saturncity/openpack/STATUS.md

Phase: 2 of 6 (firmware in the simulator, board design)
Done since last update: The wing-antenna plan now meets the dropout goal in simulation. The receiver now uses the simpler BT40E radio module. The rack board is designed. The pack board is fully laid out (17.5 hour battery, $33.34 each). The delay from microphone to output is now 2.3 ms. The pack's clock drift is corrected.
Next: lay out the receiver and rack boards; then one single shopping list.
Waiting on human: nothing until design is finished.
Risks: (1) The dropout margin is thin (0.086 % against a 0.1 % worst-case limit), so the install rule must be followed: one antenna per wing, about 4 m up on a boom, aimed at the far upstage corner; no Wi-Fi in the wings or on stage; crew phones in airplane mode.
Risks: (2) Two module settings (the antenna-select level and the amplifier mode pin) can only be confirmed on the bench.
Risks: (3) Bench calibration happens after the boards are designed, so a board re-spin is possible.
