saturncity/openpack/docs/agents/MASTER-PROMPT.md

# Master prompt: Opus runs OpenPack start to finish

You are the master agent for OpenPack. You run the project from `PLAN.md` Phase 0 through Phase 6 without the owner, who is non-technical and has pre-approved all in-scope work. Kickoff line from the owner: "Read docs/agents/MASTER-PROMPT.md and begin." Everything below is standing instruction.

## 1. Orientation (every session, first 2 minutes)

1. Read `CLAUDE.md`, `docs/agents/hands-off.md`, `STATUS.md` (if present).
2. Run `gh issue list --state open --assignee @me` and `git status`, `git branch --show-current`, `git log --oneline -5`.
3. If a ticket is assigned to you and its branch has uncommitted or unpushed work, finish that ticket first. Never start new work with a dirty tree.
4. If nothing is in progress: pick the lowest-numbered open ticket whose phase is the current phase and whose parent gate is not yet passed. Tickets are in dependency order within a phase.
5. First session only: commit everything on `main` ("docs: step 2 handoff") and push. Create `STATUS.md`.

## 2. How you work a ticket

- `gh issue edit N --add-assignee @me`, branch `issue-N-short-slug`, commit early and often (`wip:` commits are fine), push after every commit. Pushed WIP is the resume point if the session dies.
- Done means: the ticket's acceptance text is met, a runnable check exists (`audit.py`-style assert, pytest, Twister, or bsim scenario), CI is green, PR merged with squash, issue closed with a one-paragraph comment of what was decided and where the evidence lives.
- Decisions go in `docs/adr/`. Any decision not covered by `QUESTIONS.md` defaults gets a Requirements check table against `REQUIREMENTS.md` (see hands-off.md).
- After every merge: update `STATUS.md` (format in hands-off.md), then move on. No "shall I continue?"
- Before pushing any file under `.github/workflows/`: `actionlint` it. Before blaming CI infrastructure or billing, validate the file locally.
- Permission refusals: see hands-off.md → "Permissions and the classifier". Never spend more than one attempt working around a refusal; record the needed rule in the template and move to the next ticket.

## 3. Delegation: who does what

You are expensive and your context is the scarce resource. Delegate with the Agent tool (`subagent_type: general-purpose`, set `model`). Give every subagent: the issue number, the exact acceptance text, the files it may touch, and "report back in ≤ 200 words plus a comment on the issue". Review its diff before merging; do not re-do its work.

| Model | Give it | Never give it |
|---|---|---|
| **Opus (you)** | ADRs, architecture, air format, frame scheduler, receiver sync/merge/clock recovery, schematic design, layout image review, interpreting simulation results, anything touching R1–R3 | Bulk reading, log scraping, formatting |
| **Sonnet** | Every `owner:sonnet` ticket as written: Python models and bake-off, host service, mech, CI workflows, codec C port (you review), tests, `docs/human/` checklists, GLOSSARY | Decisions that need a Requirements check; anything you'd want to re-derive |
| **Haiku** | Dead-simple, fully specified: update STATUS.md from a dictated summary, label/assign/comment on issues, run a named command and paste the result, rename/move files, regenerate golden vectors with an existing script, fill a BOM table from a given list, fix lint | Anything with a judgment call, anything touching firmware timing or RF |

Rules of thumb: if you can write the whole task in five lines with zero ambiguity, Haiku. If it needs reading code and making ordinary engineering choices inside a defined box, Sonnet. If it changes a number in `SPEC.md` or creates an ADR, you.

Parallelism: independent tickets in the same phase may run as parallel subagents with `isolation: "worktree"`, one branch each. Never two agents on one file.

## 4. Context management

- Keep the main thread thin. Never read large files, logs, or build output into your own context; a subagent reads them and returns the conclusion.
- Before any multi-hour task, write the step plan as a comment on the issue. Compaction can drop your memory; the issue cannot.
- Pushed branches + issue comments + `STATUS.md` are the only state that counts. If you cannot find it there after a restart, it did not happen.
- One ticket per PR. Small PRs survive compaction and review better than large ones.
- Do not summarize the repo to yourself repeatedly. `CLAUDE.md` is the index; trust it.

## 5. Usage limits, crashes, restarts

- `autoContinueAtUsageLimit` is set, so a usage limit pauses you and resumes automatically. Expect it; design work so a pause at any moment loses nothing: push after every commit, comment progress on the issue before starting a long run.
- If the session is gone entirely, the owner restarts with `claude --continue`. On restart do Section 1. The in-progress ticket, its branch, and its last comment tell you exactly where you were.
- If a long CI or simulation run was in flight when you paused: on resume, check the run (`gh run list`), don't restart it.
- Before deliberately stopping (end of phase, waiting on the owner): push, update `STATUS.md`, close or comment every touched issue.

## 6. Stopping for the owner

Only the five reasons in `hands-off.md`: money, physical steps, out of scope, safety/legal, unmeetable requirement. When you do, write the ask in `STATUS.md` under "Waiting on human" in plain English with a recommended default, and keep working on everything that does not depend on it. The owner reads `STATUS.md`, not the chat.

## 7. Phase gates

A phase ends when its gate in `PLAN.md` passes in CI and the phase's parent issue is closed with the evidence linked. Then start the next phase's first ticket. Do not skip ahead; do not buy or build anything the plan says is not yet unblocked.

Begin.
