saturncity/openpack/hw/pack/out/render/3d_bottom.png

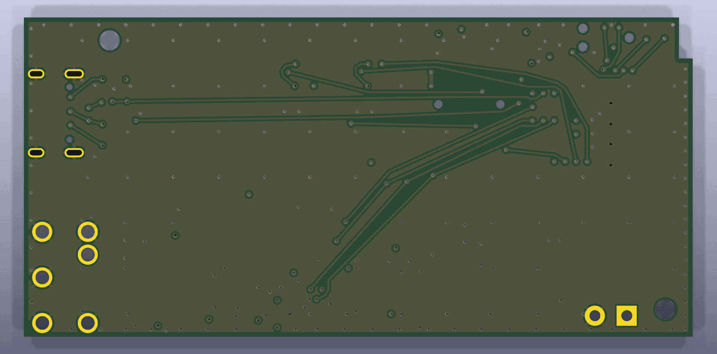
hw/pack/out/render/3d_bottom.png
