saturncity/openpack/hw/pack/out/render/3d_top.png

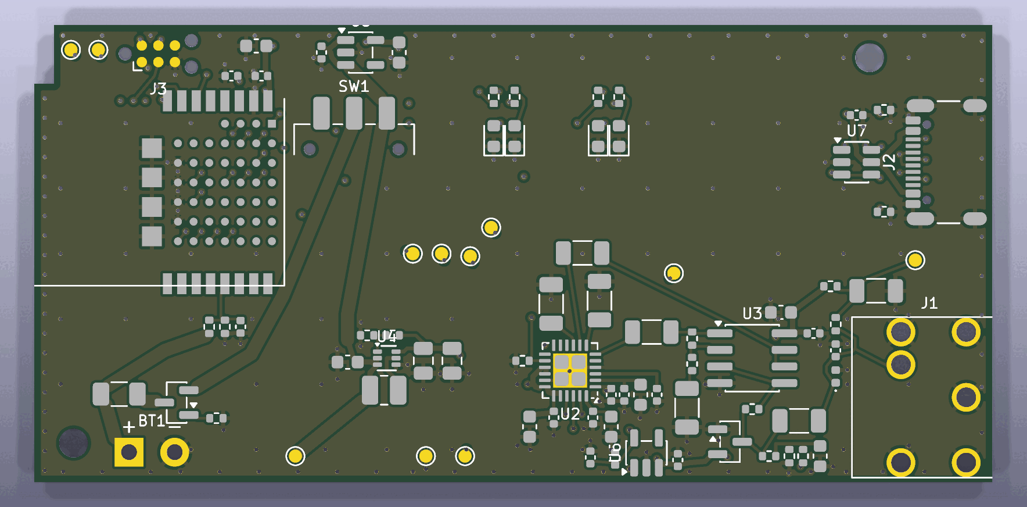
hw/pack/out/render/3d_top.png
