saturncity/openpack/hw/rack/out/render/3d_top.png

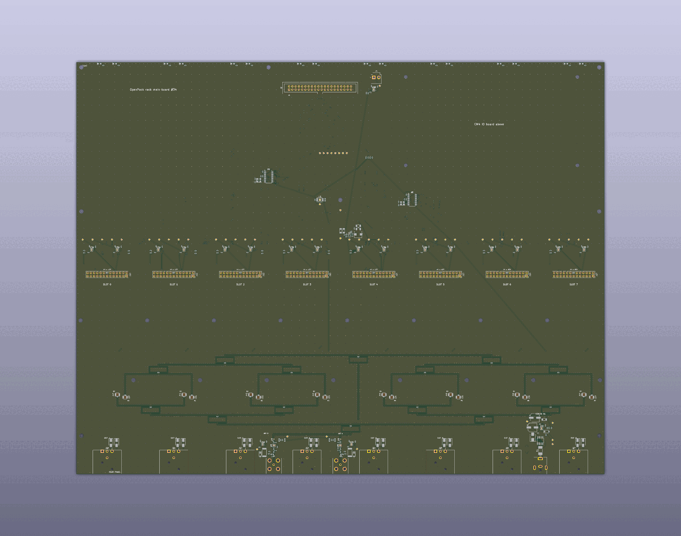
hw/rack/out/render/3d_top.png
