saturncity/openpack/hw/rack/out/render/B.Silkscreen.png

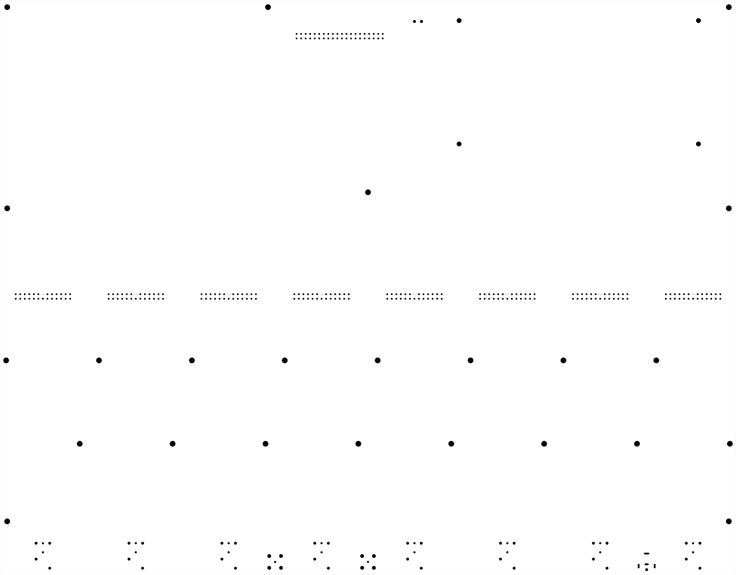
hw/rack/out/render/B.Silkscreen.png
