saturncity/openpack/hw/rack/out/render/crop_power_entry.png

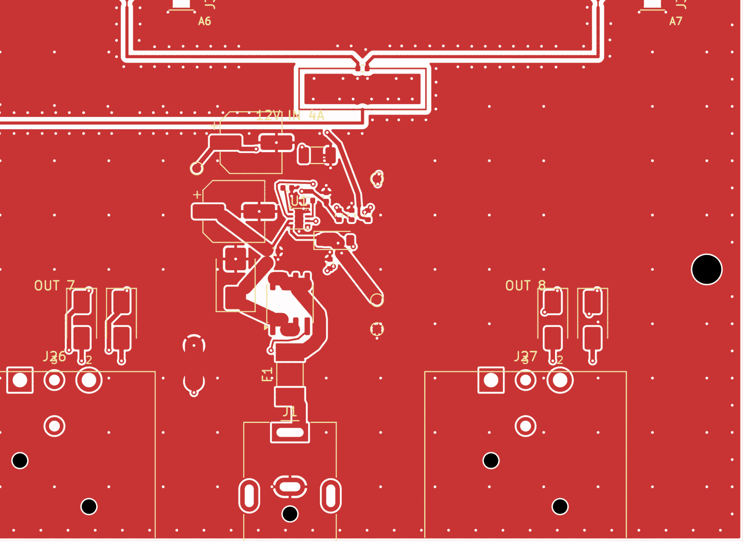
hw/rack/out/render/crop_power_entry.png
