saturncity/openpack/hw/rack/out/render/crop_rf_center.png

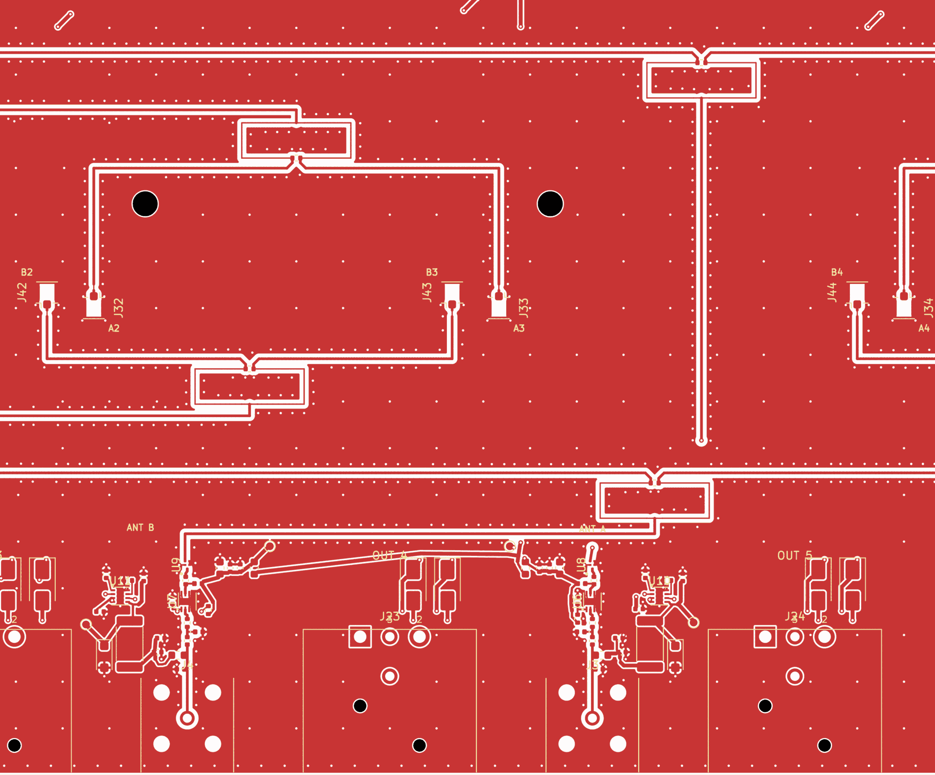
hw/rack/out/render/crop_rf_center.png
