saturncity/openpack/hw/rack/out/render/F.Mask.png

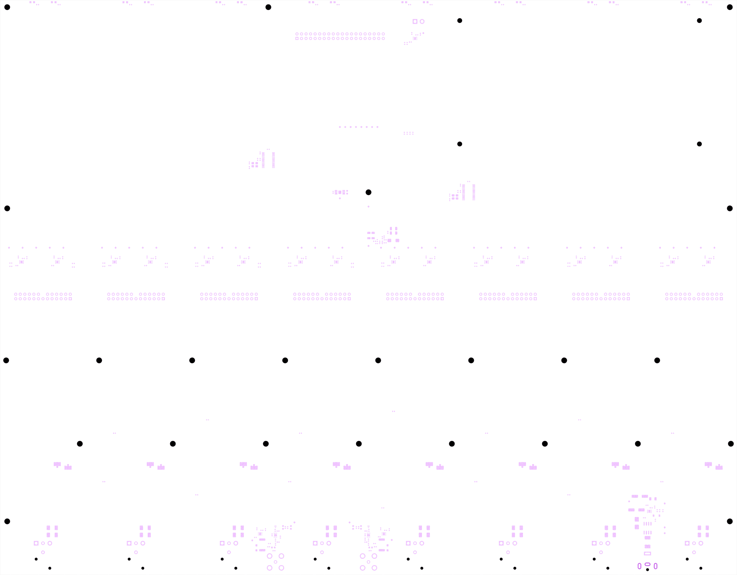
hw/rack/out/render/F.Mask.png
