saturncity/openpack/hw/rx/out/render/3d_bottom.png

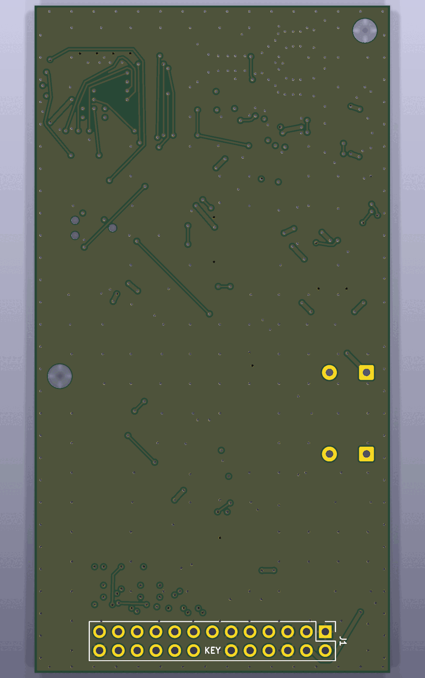
hw/rx/out/render/3d_bottom.png
