saturncity/openpack/hw/rx/out/render/B.Mask.png

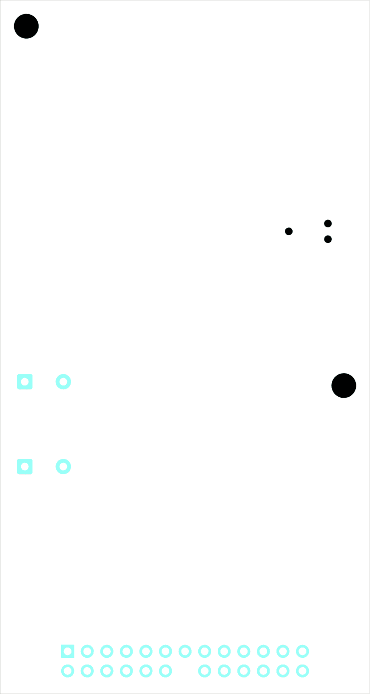
hw/rx/out/render/B.Mask.png
