saturncity/openpack/hw/rx/out/render/B.Paste.png

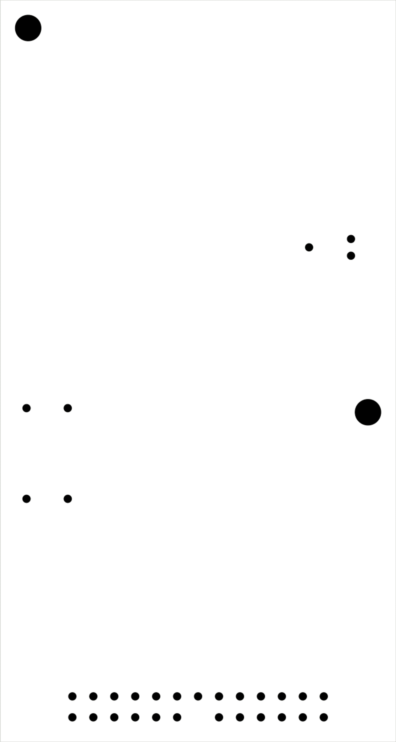
hw/rx/out/render/B.Paste.png
