saturncity/openpack/hw/rx/out/render/F.Silkscreen.png

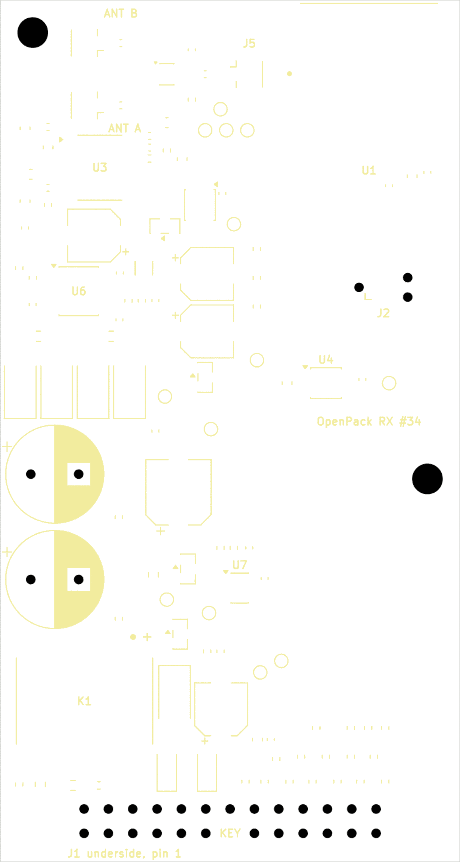
hw/rx/out/render/F.Silkscreen.png
