saturncity/openpack/hw/rx/out/render/L1_F.Cu.png

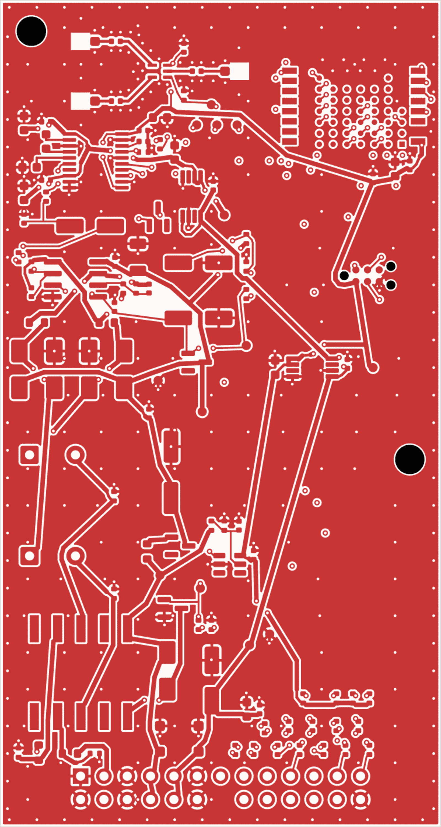
hw/rx/out/render/L1_F.Cu.png
