saturncity/openpack/hw/rx/out/render/L4_B.Cu.png

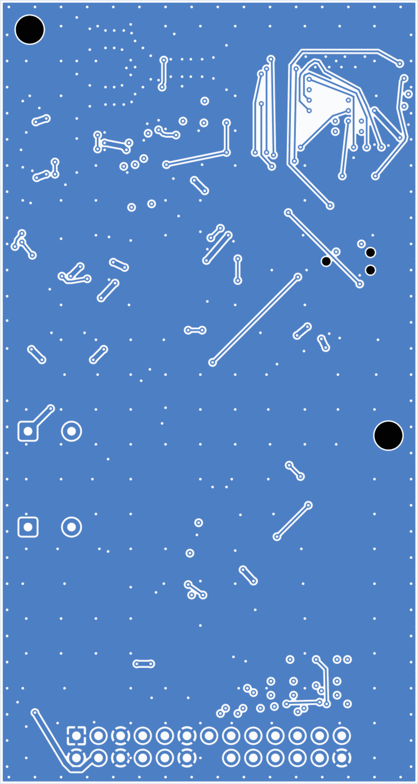
hw/rx/out/render/L4_B.Cu.png
