saturncity/openpack/mech/out/rack_top.png

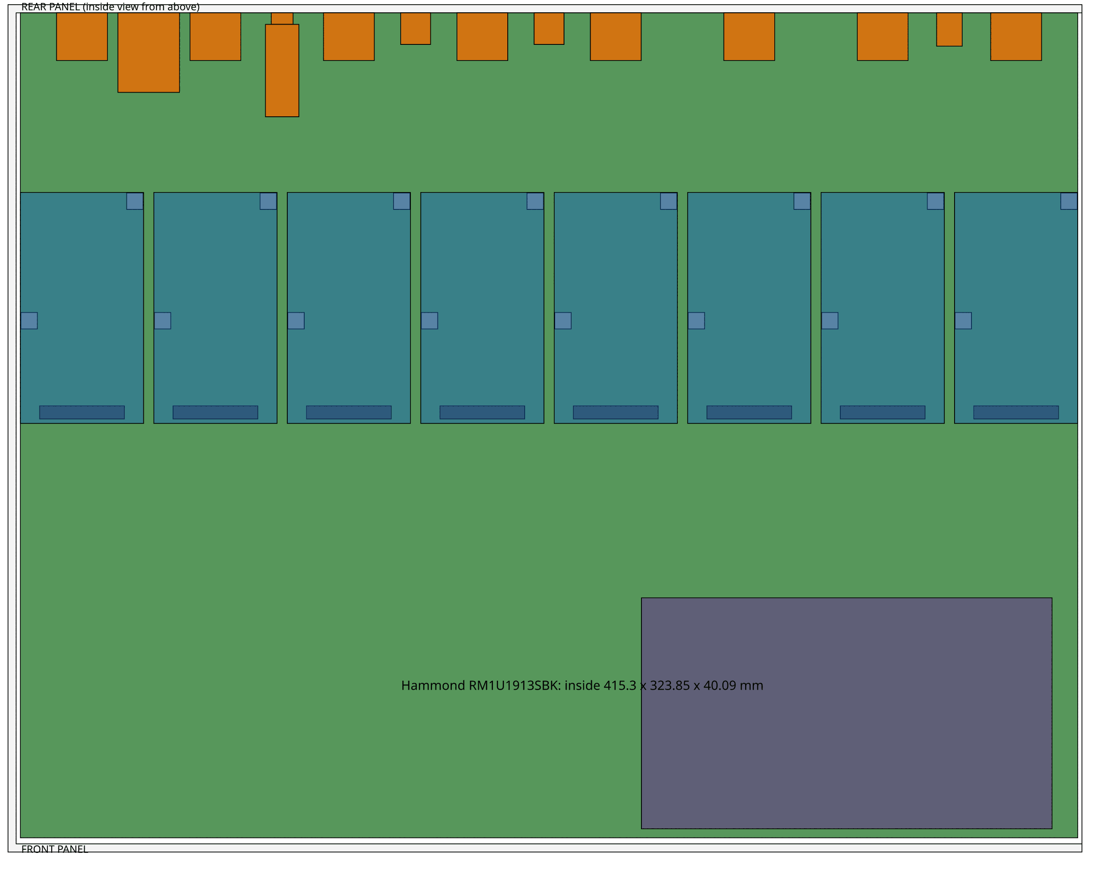
mech/out/rack_top.png
