saturncity/openpack/mech/renders/pack_closed_back.png

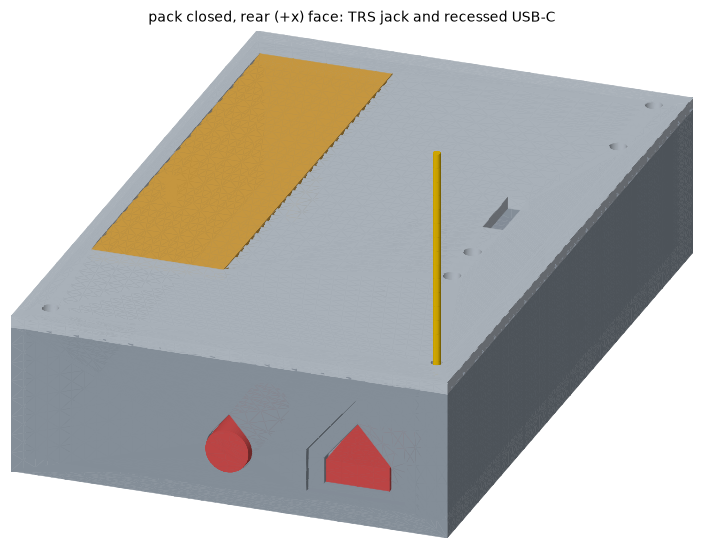
mech/renders/pack_closed_back.png
