saturncity/openpack/mech/renders/pack_open_top.png

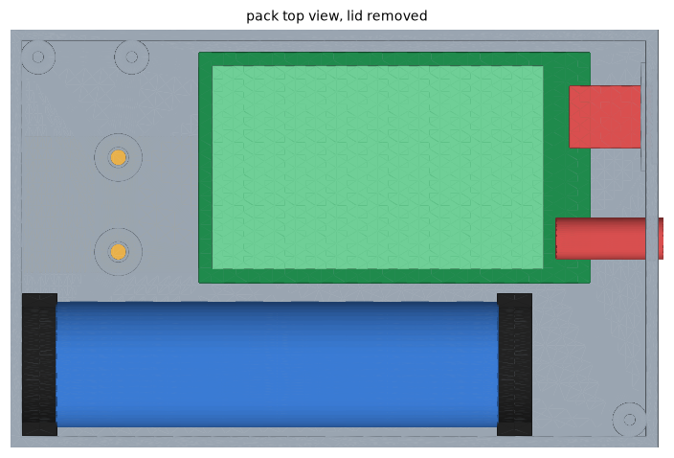
mech/renders/pack_open_top.png
