saturncity/openpack/docs/shopping-list.md

# OpenPack shopping list (issue #36, ADR-0019)

One purchase, bought once, after all design is done (ADR-0019). **Packs, receivers, bench kit and the rack** (main board PR #126, filled in here). Generated from `hw/bom/shopping.csv` by `python3 hw/bom/shopping.py`; do not edit this file by hand. A test (`tests/test_shopping.py`) checks that the totals add up.

## Totals

| Basket | Ex VAT (GBP) | VAT 20 % | Inc VAT |
|---|---:|---:|---:|
| Digi-Key UK | 591.78 | 118.36 | 710.14 |
| Mouser UK | 6.55 | 1.31 | 7.86 |
| Farnell UK | 27.86 | 5.57 | 33.43 |
| RS UK | 132.49 | 26.50 | 158.99 |
| LCSC | 74.61 | 14.92 | 89.53 |
| JLCPCB | 396.00 | 79.20 | 475.20 |
| ITM Components | 316.96 | 63.39 | 380.35 |
| Simply Sound & Lighting | 311.66 | 62.33 | 373.99 |
| Rapid Online | 146.76 | 29.35 | 176.11 |
| The Pi Hut | 99.03 | 19.81 | 118.84 |
| Thomann | 26.50 | 5.30 | 31.80 |
| Lab401 (EU) | 155.00 | 31.00 | 186.00 |
| The Debug Store | 51.00 | 10.20 | 61.20 |
| Knives and Tools UK | 24.92 | 4.98 | 29.90 |
| 123-3D UK | 15.67 | 3.13 | 18.80 |
| **Grand total (required)** | **2,376.79** | **475.36** | **2,852.15** |
| Optional items (not in total) | 533.84 | 106.77 | 640.61 |

Of the required total, GBP 1,642.56 ex VAT is **quoted** and the rest, GBP 734.23, is **estimated** (including shipping). Estimated prices are marked `estimated` in every table; none can be called a quote.

## Optional cuts the owner may choose

The owner has not decided these. **They are still inside the required total above.** Taking all of them saves the amount in the last row.

| Basket | Item | Qty cut | Saving ex VAT | VAT 20 % | Saving inc VAT | Why it may go |
|---|---|---:|---:|---:|---:|---|
| Digi-Key UK | Nordic Power Profiler Kit II (nRF-PPK2) | 1 | 80.17 | 16.03 | 96.20 | Only measures pack and FEM current; the battery-life check can use a bench meter instead. |
| Digi-Key UK | nRF5340-DK (nRF5340-DK) | 1 | 36.58 | 7.32 | 43.90 | One DK runs most bring-up; the second is the peer for the radio link and end-to-end latency tests (#38), which the packs and rack could stand in for later. |
| Simply Sound & Lighting | Thor winch-up lighting stand (LS003) | 2 | 281.66 | 56.33 | 337.99 | The venue's existing lighting stands or booms may serve as the 4 m antenna mounts (the HGX-PMT07 mounts stay). |
| Simply Sound & Lighting | Delivery (2 stands) (-) | 1 | 30.00 | 6.00 | 36.00 | Delivery for the two stands; goes with them. |
| **All cuts** | | | **428.41** | **85.68** | **514.09** | Total after all cuts: GBP 1,948.38 ex VAT, 2,338.06 inc VAT |

Lines already marked OPTIONAL in the baskets (PCM1840EVM, NanoVNA-H4, DS1054Z) are excluded from the total and are not in this table.

## How prices were read

- All prices GBP **ex VAT**; VAT 20 % shown separately and added in the inc-VAT column. Digi-Key UK, Mouser UK, Farnell UK, RS UK show ex- and inc-VAT side by side; ITM Components and the owner-given Simply Sound prices are ex VAT.
- **quoted** = a price read from a source page, with its URL and read date. For pack lines these are the readings in `hw/bom/pack_uk.csv` (2026-10-31 for Digi-Key UK, 2026-11-01 for LCSC) and `hw/rx/out/bom.csv`; for the antennas, coax, mounts and stands they are the figures given by the owner or ADR-0016 on 2026-11-01. Prices are at the quantity of 4 packs (or the 100-tier when the order quantity reaches 100), not re-read today.
- **estimated** = no page read (or the repo marks it ESTIMATE). Bench kit lines were re-read on 2026-11-01 from Digi-Key UK, The Debug Store, Lab401, Knives and Tools UK and 123-3D UK (some from search snippets, marked in the notes). Farnell, Mouser and RS pages timed out or were refused. Still estimated: JLCPCB fab, stencil and shipping (quote page is dynamic), protected cells, fasteners, wire, most delivery lines. Re-check each basket before paying.
- **LCSC and JLCPCB** orders to the UK: 20 % import VAT is collected at checkout, no duty under GBP 135 per consignment, courier shipping is a separate line. Split orders so each stays under GBP 135 ex VAT (the PCB order and parts order already do).
- Quantities: pack lines are 4 packs; receiver lines are **4 receivers** (one per pack; the rack has 8 slots, 4 stay empty, but all 8 get their main-board parts and u.FL jumpers). An MPN is bought **once**: parts shared by packs, receivers and the rack are summed into one line (shared passives sit in LCSC). Rack-only lines come from `hw/bom/rack_uk.csv` (the #126 backplane BOM summed per MPN); the rack host, case, cables and PCB order are in `hw/bom/shopping.py`. Spares: passives max(10, 25 %), ICs under GBP 1 get 1 spare, dearer parts none. Lines used by both pack and receiver are merged into one line.
- Parts the repo consigns elsewhere: BT40NE (pack) at Digi-Key UK GBP 16.34 at qty 4, BT40E (receiver) at Digi-Key UK GBP 9.78 (10 week lead on both; order first). F1 fuse SF-1206F300-2 at Digi-Key UK. No FEM is bought (U8 is not fitted).

## Gaps and decisions

- **Not UK-sourceable / unconfirmed:** the tinySA Ultra+ comes from Lab401 (France), no UK stockist was found; protected 18650 cells (no UK seller page could be read), the NanoVNA (optional). Everything else is on a UK distributor's list but unverified in stock.
- **Missing from the BOMs, added here:** Tag-Connect TC2030-IDC-NL (programming), protected 18650 cells, an external 18650 charger, solder paste, the u.FL pigtails and attenuators for conducted-power measurement.
- **Decided with the rack (#126):** near wing CA3N030 (9.14 m), far wing CA3N075 (22.86 m); an N-socket to BNC-plug adapter at the rack replaces the LCCA30301-FT1.5 jumper. A reflow hot plate/oven and a multimeter are assumed owned.
- **Biggest estimate:** the rack main-board PCB order, GBP 300 (reviewer's range 250-350, the JLC page needs a browser). Quote it before ordering.
- **Not listed (assumed owned):** Bambu A1 mini (ADR-0008 says the owner has it), PC, soldering iron.

## Basket: Digi-Key UK

**Basket total: GBP 591.78 ex VAT, VAT 118.36, GBP 710.14 inc VAT.**

| Item | Part number | Qty | Unit (GBP ex VAT) | Line total | Price | Link | Reason / what it unblocks |
|---|---|---:|---:|---:|---|---|---|
| PCM5102A I2S DAC breakout board (Adafruit 6250) | Adafruit 6250 | 1 | 3.7000 | 3.70 | quoted 2026-11-01 | [link](https://www.digikey.co.uk/en/products/result?keywords=1528-6250-ND) | #38 I2S backend and the DAC output chain on the bench; FLT/XSMT strap tests (ADR-0017). Digi-Key UK 2026-11-01: GBP 3.70 ex VAT (4.44 inc), 494 in stock. The Pi Hut search found no PCM5102 board. |
| u.FL to SMA female pigtail 150 mm (GCT) | CABLE 348 RF-150-A-1 | 2 | 2.1900 | 4.38 | quoted 2026-11-01 | [link](https://www.digikey.co.uk/en/products/result?keywords=U.FL%20to%20SMA%20cable%20assembly) | Connects the pack/receiver u.FL (and the DK RF connector) to the SMA attenuator and analyser. Digi-Key UK 2026-11-01: GBP 2.19 ex VAT, 1,228 in stock; U.FL (MHF1) to SMA, 5.9 in. Check the SMA end is a jack (listing does not say) before ordering. |
| TI PCM1840 evaluation module | PCM1840EVM | 1 | 148.8400 | 148.84 | quoted 2026-11-01, OPTIONAL | [link](https://www.digikey.co.uk/en/products/result?keywords=PCM1840EVM) | #38 ADC delay and noise measured before the pack is populated (ADR-0019 mitigation). Digi-Key UK 2026-11-01: GBP 148.84 ex VAT (178.61 inc), 2 in stock, 12 week factory lead time, purchase limit applies. Was estimated at 55: nearly 3x higher. Order early; Mouser UK page timed out. OPTIONAL: under the single-purchase plan (ADR-0019) the PCM1840 arrives on our own pack boards at the same time, so a separate eval board adds no earlier test step. |
| 8-channel 24 MHz USB logic analyser (Cypress FX2, sigrok fx2lafw), SparkFun | SparkFun 18627 | 1 | 20.4400 | 20.44 | quoted 2026-11-01 | [link](https://www.digikey.co.uk/en/products/result?keywords=logic%20analyzer%20USB%208%20channel) | #38 end-to-end latency via GPIO toggles; I2S and frame-clock phasing (ADR-0020/0022). 24 MHz sampling is 40 ns against ms-scale latency. Digi-Key UK 2026-11-01: GBP 20.44 ex VAT, 968 in stock; the SparkFun unit is documented for sigrok PulseView. The Pi Hut lists the same unit at GBP 26.30 inc VAT (21.92 ex) but SOLD OUT 2026-11-01. |
| SMA attenuator 10 dB 2 W DC-6 GHz (Mini-Circuits) | VAT-10W2+ | 1 | 28.1800 | 28.18 | quoted 2026-11-01 | [link](https://www.digikey.co.uk/en/products/result?keywords=attenuator%20SMA%2010dB) | Stacks to 30 dB for the nRF21540 +20 dBm case if the FEM is fitted. Digi-Key UK 2026-11-01: GBP 28.18 ex VAT, 455 in stock. Cheaper DC-4 GHz Cinch part exists (GBP 17.95) but would not cover harmonics. |
| SMA attenuator 20 dB 2 W DC-6 GHz (Mini-Circuits) | VAT-20W2+ | 1 | 33.6300 | 33.63 | quoted 2026-11-01 | [link](https://www.digikey.co.uk/en/products/result?keywords=attenuator%20SMA%2020dB%202W) | Protects the tinySA input while measuring conducted TX power at the pack u.FL (limit +7 dBm, ADR-0016/design-log). Digi-Key UK 2026-11-01: GBP 33.63 ex VAT, 137 in stock. |
| Nordic Power Profiler Kit II | nRF-PPK2 | 1 | 80.1700 | 80.17 | quoted 2026-11-01, OPTIONAL CUT x1 | [link](https://www.digikey.co.uk/en/products/result?keywords=nRF-PPK2) | #38 FEM and pack current; sources/measures 0.8-5 V for the battery-life check. Digi-Key UK 2026-11-01: GBP 80.17 ex VAT (96.20 inc), 1,798 in stock. OPTIONAL CUT (listed under the optional cuts). |
| nRF5340-DK | nRF5340-DK | 2 | 36.5800 | 73.16 | quoted 2026-11-01, OPTIONAL CUT x1 | [link](https://www.digikey.co.uk/en/products/result?keywords=nRF5340-DK) | Phase 5 DK bring-up (#38): ADC/DAC delay, T_GAP, lock, end-to-end latency. Second DK is the peer. OPTIONAL CUT: the second DK (GBP 36.58) is listed under the optional cuts. Digi-Key UK result page 2026-11-01: GBP 36.58 qty 1 (DK UK shows ex VAT; the page does not label it). Stock level not shown on the result page. Also stocked by Mouser UK and Farnell UK (their pages timed out). |
| Packs x4 part | BAV199,215 | 5 | 0.1600 | 0.80 | estimated | [link](https://www.digikey.co.uk/en/products/detail/nexperia-usa-inc/BAV199-215/763223) | Needed 4 (pack x1; refs D6), +1 spare q4 from DK UK listing (VAT basis not stated); qty100 ESTIMATE |
| Packs x4 part | BT40NE | 4 | 16.3400 | 65.36 | quoted 2026-10-31 | [link](https://www.digikey.co.uk/en/products/detail/fanstel-corp/BT40NE/22107427) | Needed 4 (pack x1) DK UK ex-VAT breaks; Fanstel direct (fanstel.com) also sells; no Farnell/RS/Mouser UK listing found |
| Packs x4 part | C_10u_1206_X7R | 30 | 0.1000 | 3.00 | estimated | [link](https://www.digikey.co.uk/en/products/result?keywords=C_10u_1206_X7R) | Needed 20 (pack x5; refs C10 C15 C16 C17 C18), +10 spare ESTIMATE; e.g. Samsung CL31B106KOHNNNE (verify 16V) |
| Packs x4 part | C_22p_0402_C0G | 14 | 0.0150 | 0.21 | estimated | [link](https://www.digikey.co.uk/en/products/result?keywords=C_22p_0402_C0G) | Needed 4 (pack x1; refs C9), +10 spare ESTIMATE; e.g. GRM1555C1H220JA01D |
| Packs x4 part | DFE252012F-1R0M=P2 | 5 | 0.1900 | 0.95 | quoted 2026-10-31 | [link](https://www.digikey.co.uk/en/products/result?keywords=DFE252012F-1R0M%3DP2) | Needed 4 (pack x1; refs L1), +1 spare ex VAT |
| Packs x4 part | GRM21BR61A226ME51L | 18 | 0.1500 | 2.70 | quoted 2026-10-31 | [link](https://www.digikey.co.uk/en/products/result?keywords=GRM21BR61A226ME51L) | Needed 8 (pack x2; refs C2 C3), +10 spare ex VAT; GRM188R61A226ME15D (0603, 104k stock) is NOT same footprint |
| Packs x4 part | GRM31CR60J107ME39L | 14 | 0.5000 | 7.00 | estimated | [link](https://www.digikey.co.uk/en/products/result?keywords=GRM31CR60J107ME39L) | Needed 4 (pack x1; refs C12), +10 spare FLAG: swap to Samsung CL31A107MQHNNNE (100uF 1206 6.3V X5R) GBP0.50 @1 at DK UK; qty100 ESTIMATE; check DC-bias derating and Samsung datasheet before adopting. Schematic NOT changed |
| Packs x4 part | GRM31CR61A476ME15L | 14 | 0.3100 | 4.34 | quoted 2026-10-31 | [link](https://www.digikey.co.uk/en/products/result?keywords=GRM31CR61A476ME15L) | Needed 4 (pack x1; refs C8), +10 spare ex VAT |
| Packs x4 part | JS102011SAQN | 5 | 0.6700 | 3.35 | quoted 2026-10-31 | [link](https://www.digikey.co.uk/en/products/result?keywords=JS102011SAQN) | Needed 4 (pack x1; refs SW1), +1 spare cut tape; ex VAT |
| Packs x4 part | LTST-C191KGKT | 5 | 0.1100 | 0.55 | quoted 2026-10-31 | [link](https://www.digikey.co.uk/en/products/detail/liteon/LTST-C191KGKT/386835) | Needed 4 (pack x1; refs D1), +1 spare q4 listing; qty100 assumed = KRKT tier (same series) |
| Packs x4 part | LTST-C191KRKT | 9 | 0.1100 | 0.99 | quoted 2026-10-31 | [link](https://www.digikey.co.uk/en/products/result?keywords=LTST-C191KRKT) | Needed 8 (pack x2; refs D2 D4), +1 spare used twice (D2, D4); ex VAT |
| Packs x4 part | LTST-C191KSKT | 5 | 0.1200 | 0.60 | quoted 2026-10-31 | [link](https://www.digikey.co.uk/en/products/result?keywords=LTST-C191KSKT) | Needed 4 (pack x1; refs D3), +1 spare ex VAT |
| Packs x4 part | PCM1840IRTWR | 4 | 3.9600 | 15.84 | quoted 2026-10-31 | [link](https://www.digikey.co.uk/en/products/result?keywords=PCM1840IRTWR) | Needed 4 (pack x1) ex VAT; 296-PCM1840IRTWRCT-ND; Mouser 595-PCM1840IRTWR also lists (UK page not fetched) |
| Packs x4 part | SF-1206F300-2 | 5 | 0.6700 | 3.35 | quoted 2026-10-31 | [link](https://www.digikey.co.uk/en/products/result?keywords=SF-1206F300-2) | Needed 4 (pack x1; refs F1), +1 spare ex VAT |
| Packs x4 part | SJ1-3543 | 4 | 1.6700 | 6.68 | quoted 2026-10-31 | [link](https://www.digikey.co.uk/en/products/detail/same-sky-formerly-cui-devices/SJ1-3543/738704) | Needed 4 (pack x1) ex VAT; bag packaging |
| Packs x4 part | TLV75533PDBVR | 9 | 0.3100 | 2.79 | quoted 2026-10-31 | [link](https://www.digikey.co.uk/en/products/result?keywords=TLV75533PDBVR) | Needed 8 (pack x2; refs U5 U6), +1 spare ex VAT; qty4 order=8 (1-pc tier); qty100 order=200 (100 tier) |
| Packs x4 part | TPD1E10B06DPYR | 5 | 0.3100 | 1.55 | estimated | [link](https://www.digikey.co.uk/en/products/detail/texas-instruments/TPD1E10B06DPYR/3197744) | Needed 4 (pack x1; refs D5), +1 spare q4 from DK UK listing; qty100 ESTIMATE |
| Packs x4 part | TPS61023DRLR | 4 | 1.0300 | 4.12 | quoted 2026-10-31 | [link](https://www.digikey.co.uk/en/products/result?keywords=TPS61023DRLR) | Needed 4 (pack x1) ex VAT; qty4 uses 1-pc tier |
| Packs x4 part | USB4105-GF-A | 5 | 0.6000 | 3.00 | estimated | [link](https://www.digikey.co.uk/en/products/detail/gct/USB4105-GF-A/11198441) | Needed 4 (pack x1; refs J2), +1 spare q4 price from DK UK listing (VAT basis not stated); qty100 ESTIMATE (no UK tier read) |
| Packs x4 part | USBLC6-2SC6 | 5 | 0.4000 | 2.00 | quoted 2026-10-31 | [link](https://www.digikey.co.uk/en/products/detail/stmicroelectronics/USBLC6-2SC6/1040559) | Needed 4 (pack x1; refs U7), +1 spare ex VAT |
| Packs x4 + Receivers x4 part | OPA1656IDR | 8 | 2.2300 | 17.84 | quoted 2026-10-31 | [link](https://www.digikey.co.uk/en/products/result?keywords=OPA1656IDR) | Needed 8 (pack x1; rx x1) ex VAT; 296-OPA1656IDRCT-ND |
| 5415025-1 | 5415025-1 | 2 | 6.9500 | 13.90 | estimated | [link](https://www.digikey.co.uk/en/products/result?keywords=5415025-1) | Needed 2 (rack) rack price from hw/rack/prices.py (est. (TE right-angle PCB BNC 50 ohm 4 GHz, 1/2-28 bulkhead; buy UK: DigiKey UK / Mouser UK, LCSC C5164649 USD 9.15 for reference; Molex 73138-5033 is the drop-in alternative)) |
| UK mains cord BS1363 to C13, 1.83 m | AC-12206-UK | 1 | 8.3500 | 8.35 | quoted 2026-11-01 | [link](https://www.digikey.co.uk/en/products/result?keywords=AC-12206-UK) | Mains lead for the 12 V brick. Digi-Key UK 2026-11-01, read (7,931 in stock). |
| Mean Well GST60A12-P1J 12 V 5 A desktop brick, 2.1 mm plug, C14 inlet | GST60A12-P1J | 1 | 14.5000 | 14.50 | quoted 2026-11-01 | [link](https://www.digikey.co.uk/en/products/result?keywords=GST60A12-P1J) | Rack 12 V supply. Digi-Key UK 2026-11-01, read (6,852 in stock). |
| 40-way IDC ribbon 152 mm socket-socket (Assmann H3AAH-4006G) | H3AAH-4006G | 1 | 1.3000 | 1.30 | quoted 2026-11-01 | [link](https://www.digikey.co.uk/en/products/result?keywords=H3AAH-4006G) | Main board J2 to CM4IO J8. Digi-Key UK 2026-11-01, read. |
| NC3MAH | NC3MAH | 8 | 2.0800 | 16.64 | quoted 2026-11-01 | [link](https://www.digikey.co.uk/en/products/result?keywords=NC3MAH) | Needed 8 (rack) rack price from hw/rack/prices.py (DigiKey UK 2026-11-01, read (Neutrik NC3MAH; the LCSC buy is C5154126, Extended, price there unconfirmed)) |
| Neutrik NE8FDP etherCON RJ45 feedthrough (rear panel) | NE8FDP | 1 | 12.7800 | 12.78 | quoted 2026-11-01 | [link](https://www.digikey.co.uk/en/products/result?keywords=NE8FDP) | Rear-panel network port. Digi-Key UK 2026-11-01, read. |
| PJ-063AH | PJ-063AH | 1 | 1.2200 | 1.22 | quoted 2026-11-01 | [link](https://www.digikey.co.uk/en/products/result?keywords=PJ-063AH) | Needed 1 (rack) rack price from hw/rack/prices.py (DigiKey UK 2026-11-01, read (CUI / Same Sky PJ-063AH 2.1 mm 8 A, 34,138 in stock; not locking): buy UK) |
| QPL9057TR7 | QPL9057TR7 | 2 | 4.6000 | 9.20 | quoted 2026-11-01 | [link](https://www.digikey.co.uk/en/products/result?keywords=QPL9057TR7) | Needed 2 (rack) rack price from hw/rack/prices.py (DigiKey UK 2026-11-01, read (61,763 in stock); 25+ GBP 3.77, 100+ GBP 3.17) |
| QPQ1907SR | QPQ1907SR | 2 | 2.8200 | 5.64 | quoted 2026-11-01 | [link](https://www.digikey.co.uk/en/products/result?keywords=QPQ1907SR) | Needed 2 (rack) rack price from hw/rack/prices.py (DigiKey UK 2026-11-01, read (7,548 in stock; 33-week lead); IL 1.3 typ / 2.2 max dB) |
| Raspberry Pi CM4 IO Board (SC0326) | SC0326 | 1 | 26.1500 | 26.15 | quoted 2026-11-01 | [link](https://www.digikey.co.uk/en/products/result?keywords=SC0326) | CM4 carrier for the rack host. Digi-Key UK 2026-11-01, read. |
| SC16IS752IPW,128 | SC16IS752IPW,128 | 2 | 5.9200 | 11.84 | quoted 2026-11-01 | [link](https://www.digikey.co.uk/en/products/result?keywords=SC16IS752IPW,128) | Needed 2 (rack) rack price from hw/rack/prices.py (DigiKey UK 2026-11-01, read (11,036 in stock); the ,112 tube variant is obsolete) |
| SMAJ58CA | SMAJ58CA | 17 | 0.3600 | 6.12 | quoted 2026-11-01 | [link](https://www.digikey.co.uk/en/products/result?keywords=SMAJ58CA) | Needed 16 (rack; refs SMAJ58CA), +1 spare rack price from hw/rack/prices.py (DigiKey UK 2026-11-01, read (Littelfuse)) |
| SMBJ12A | SMBJ12A | 2 | 0.3700 | 0.74 | quoted 2026-11-01 | [link](https://www.digikey.co.uk/en/products/result?keywords=SMBJ12A) | Needed 1 (rack; refs SMBJ12A), +1 spare rack price from hw/rack/prices.py (DigiKey UK 2026-11-01, read (Littelfuse)) |
| SRP5030T-6R8M | SRP5030T-6R8M | 2 | 0.6200 | 1.24 | estimated | [link](https://www.digikey.co.uk/en/products/result?keywords=SRP5030T-6R8M) | Needed 1 (rack; refs SRP5030T-6R8M), +1 spare rack price from hw/rack/prices.py (est. (Bourns SRP5030T-6R8M 6.8 uH, Irms 4.0 A, Isat 4.3 A, DCR 76.2 mohm, Bourns datasheet read 2026-11-01; buy UK, not LCSC: C177249 is only 3.5 A)) |
| TPS259531DSGR | TPS259531DSGR | 9 | 0.5580 | 5.02 | quoted 2026-11-01 | [link](https://www.digikey.co.uk/en/products/result?keywords=TPS259531DSGR) | Needed 8 (rack; refs TPS259531DSGR), +1 spare rack price from hw/rack/prices.py (DigiKey UK 2026-11-01, read qty-10 break (4,178 in stock)) |
| TPS259541DSGR | TPS259541DSGR | 13 | 0.5580 | 7.25 | quoted 2026-11-01 | [link](https://www.digikey.co.uk/en/products/result?keywords=TPS259541DSGR) | Needed 12 (rack; refs TPS259541DSGR), +1 spare rack price from hw/rack/prices.py (DigiKey UK 2026-11-01, read qty-10 break; 20-week lead, stock not shown) |
| TPS62933DRLR | TPS62933DRLR | 1 | 1.2000 | 1.20 | estimated | [link](https://www.digikey.co.uk/en/products/result?keywords=TPS62933DRLR) | Needed 1 (rack) rack price from hw/rack/prices.py (est. (TI TPS62933 3 A buck, SOT-583)) |
| Receivers x4 part | BT40E | 4 | 9.7700 | 39.08 | quoted 2026-11-01 | [link](https://www.digikey.co.uk/en/products/result?keywords=BT40E) | Needed 4 (rx x1) rx price from hw/rx/out/bom.csv (Digi-Key UK qty-100 cut tape GBP 9.7765, part 13174285, 803 in stock, 10 wk lead (read 2026-11-01)) |
| Receivers x4 part | PCM5102APWR | 4 | 2.7700 | 11.08 | estimated | [link](https://www.digikey.co.uk/en/products/result?keywords=PCM5102APWR) | Needed 4 (rx x1) rx price from hw/rx/out/bom.csv (Digi-Key qty-100, via findchips.com snapshot read 2026-10-31 (Mouser q100 $2.78)); x1.3 on the qty-100 figure for a 4-board order |
| Receivers x4 part | TPS3808G01DBVR | 5 | 0.7900 | 3.95 | estimated | [link](https://www.digikey.co.uk/en/products/result?keywords=TPS3808G01DBVR) | Needed 4 (rx x1; refs U7), +1 spare rx price from hw/rx/out/bom.csv (est. (TI TPS3808 adjustable supervisor, SOT-23-6, q100)); x1.3 on the qty-100 figure for a 4-board order |
| Receivers x4 + Rack part | TLV76733DGNR | 10 | 0.3900 | 3.90 | estimated | [link](https://www.digikey.co.uk/en/products/result?keywords=TLV76733DGNR) | Needed 9 (rx x2; rack; refs U4 U5), +1 spare rx price from hw/rx/out/bom.csv (est. (TI TLV767 1 A 16 V LDO, HVSSOP-8, q100)); x1.3 on the qty-100 figure for a 4-board order |
| Delivery (UPS, duty-paid) | - | 1 | 0.0000 | 0.00 | estimated | [link](https://www.digikey.co.uk) | Free above the Digi-Key UK threshold (about GBP 33, unconfirmed); basket is far above it. Estimate. |

## Basket: Mouser UK

**Basket total: GBP 6.55 ex VAT, VAT 1.31, GBP 7.86 inc VAT.**

| Item | Part number | Qty | Unit (GBP ex VAT) | Line total | Price | Link | Reason / what it unblocks |
|---|---|---:|---:|---:|---|---|---|
| Packs x4 part | DMG2305UX-7 | 5 | 0.1100 | 0.55 | estimated | [link](https://www.mouser.co.uk/ProductDetail/621-DMG2305UX-7) | Needed 4 (pack x1; refs Q1), +1 spare DK UK shows 0 stock/backorder. Prices from search snippets, UNVERIFIED; alt source RS UK https://uk.rs-online.com/web/p/mosfets/8270452 . DMP2305U-7 also 0 stock at DK (40 wk) so not a useful swap |
| Delivery | - | 1 | 6.0000 | 6.00 | estimated | [link](https://www.mouser.co.uk) | Small basket; Mouser UK free-shipping threshold not confirmed. Estimate. |

## Basket: Farnell UK

**Basket total: GBP 27.86 ex VAT, VAT 5.57, GBP 33.43 inc VAT.**

| Item | Part number | Qty | Unit (GBP ex VAT) | Line total | Price | Link | Reason / what it unblocks |
|---|---|---:|---:|---:|---|---|---|
| SMA male-male adapter | SMA-MM | 2 | 3.0000 | 6.00 | estimated | [link](https://uk.farnell.com/w/search?st=SMA+male+male+adapter) | Joins attenuators to the tinySA. Estimate. |
| ESD101-B1-02EL | ESD101-B1-02EL | 3 | 0.3000 | 0.90 | estimated | [link](https://uk.farnell.com/w/search?st=ESD101-B1-02EL) | Needed 2 (rack; refs ESD101-B1-02EL), +1 spare rack price from hw/rack/prices.py (est. (Infineon 5.5 V 0.1 pF RF ESD, TSLP-2-20; Farnell UK 2480926)) |
| ESD103-B1-02EL | ESD103-B1-02EL | 3 | 0.3000 | 0.90 | estimated | [link](https://uk.farnell.com/w/search?st=ESD103-B1-02EL) | Needed 2 (rack; refs ESD103-B1-02EL), +1 spare rack price from hw/rack/prices.py (est. (Infineon 15 V 0.09 pF RF ESD, TSLP-2-20; Farnell UK 2725731, LCSC C535146)) |
| Receivers x4 part | ALU_BP_47u_63V | 18 | 0.1900 | 3.42 | estimated | [link](https://uk.farnell.com/w/search?st=ALU_BP_47u_63V) | Needed 8 (rx x2; refs C47 C48), +10 spare rx price from hw/rx/out/bom.csv (est. (47 uF 63 V bipolar aluminium, 10 mm, e.g. Nichicon UEP series)) |
| Receivers x4 part | TQ2SA-12V | 4 | 3.1600 | 12.64 | estimated | [link](https://uk.farnell.com/w/search?st=TQ2SA-12V) | Needed 4 (rx x1) rx price from hw/rx/out/bom.csv (est. (Panasonic TQ2 DPDT 12 V signal relay, q100; Farnell UK 1124056)); x1.3 on the qty-100 figure for a 4-board order |
| Delivery | - | 1 | 4.0000 | 4.00 | estimated | [link](https://uk.farnell.com) | Under the free-delivery threshold (older sources say GBP 20 ex VAT, unconfirmed). Estimate. |

## Basket: RS UK

**Basket total: GBP 132.49 ex VAT, VAT 26.50, GBP 158.99 inc VAT.**

| Item | Part number | Qty | Unit (GBP ex VAT) | Line total | Price | Link | Reason / what it unblocks |
|---|---|---:|---:|---:|---|---|---|
| Amphenol RF N socket to BNC plug adapter (at the rack BNC, one per wing) | NF-BM-NT3G-50 | 2 | 8.4000 | 16.80 | quoted 2026-11-01 | [link](https://uk.rs-online.com/web/c/?searchTerm=285-6398) | Joins each coax to the rack BNC. Replaces the L-com LCCA30301-FT1.5 jumper (GBP 37.09 each): 0.1 dB instead of ~0.2 dB plus a mated pair (rack PR #126). RS UK 285-6398, ex VAT, from a search snippet 2026-11-01 (rack PR #126); stock not seen. |
| Rigol DS1054Z 50 MHz 4-channel oscilloscope | DS1054Z | 1 | 310.0000 | 310.00 | estimated, OPTIONAL | [link](https://uk.rs-online.com/web/c/?searchTerm=DS1054Z) | Optional: preamp step into 10 nF, start-up transient, boost ripple, P48/hot-plug transients. The PPK2 and logic analyser do not see analogue waveforms. Optional. Estimate; skip if the owner already has a scope. |
| Protected 18650 Li-ion cell, button top, ~3000 mAh | 18650 protected | 6 | 7.0000 | 42.00 | estimated | [link](https://uk.rs-online.com/web/c/?searchTerm=protected+18650) | PK-6: one removable protected 18650 per pack, no on-board charging. 4 + 2 spares for bench and failure. Estimate, NOT sourced. Must be PROTECTED and button-top. RS UK shipping of cells unconfirmed. Tried 2026-11-01: Nkon (403), 18650.UK (TLS error), Fogstar (only a sold-out unprotected 2500 mAh cell, GBP 6.49, on page 1 of 3), Digi-Key UK (no cells in the search). Next: Fogstar or 18650.UK by hand, Nkon by courier. |
| Silicone hookup wire 24 AWG, 5 m red/black | 24AWG silicone | 1 | 5.0000 | 5.00 | estimated | [link](https://uk.rs-online.com/web/c/?searchTerm=24AWG+silicone+wire) | Cell leads (2 x 60 mm per pack) and the 31 mm whip wire. Estimate. |
| M2 brass heat-set inserts, pack of 50 | M2 heat-set insert | 1 | 7.0000 | 7.00 | estimated | [link](https://uk.rs-online.com/web/c/?searchTerm=M2+heat+set+insert) | Clip screws into 7 mm bosses (ADR-0008), two per pack plus spares. Estimate. |
| M2 x 6 pan-head thread-forming screws, pack of 100 | M2x6 PT pan | 1 | 6.0000 | 6.00 | estimated | [link](https://uk.rs-online.com/web/c/?searchTerm=M2x6+thread+forming) | 2 per pack board retention into printed bosses (ADR-0008, pack_uk.csv). Estimate; replaces the US Fastener Superstore source in pack_uk.csv. |
| Lead-free low-temperature solder paste, 35 g syringe (Chip Quik SMD LTLF) | RS 146-6200 | 1 | 29.3700 | 29.37 | quoted 2026-11-01 | [link](https://uk.rs-online.com/web/p/solder-pastes/1466200) | Bare PCBs plus stencil, assembly waits for bench results (ADR-0019); hot-plate reflow. 8 boards of about 70-95 parts each; 35 g replaces 2 x 10 g. SEARCH-RESULT SNIPPET 2026-11-01: GBP 29.37 ex VAT (35.24 inc); product page returned 403. Stock not seen. Farnell UK SMDLTLFP10T5 (10 g) found no price. Reflow hot plate/oven is not listed: if the owner has none, add a hot plate (about GBP 40). |
| Taoglas CAB.6012 U.FL-U.FL 1.13 mm jumper 100 mm | CAB.6012 | 16 | 1.0200 | 16.32 | quoted 2026-11-01 | [link](https://uk.rs-online.com/web/c/?searchTerm=069-0832) | Main-board RF port to each receiver J3/J4 (8 slots x 2); the ports sit right behind each receiver (0.3 dB + 2 mated pairs). All 16 are bought although 4 slots are used, as in #126. RS UK 069-0832, read by the coordinator 2026-11-01; stock unconfirmed. Alternative LCSC C7541876 (Kinghelm). |
| Cat6 patch lead 0.3 m (NE8FDP to CM4IO RJ45) | Cat6 0.3 m | 1 | 2.0000 | 2.00 | estimated | [link](https://uk.rs-online.com/web/c/?searchTerm=cat6+patch+0.3m) | Panel RJ45 to the CM4IO. Estimate (rack PR #126); RS UK or Farnell UK. |
| M2.5 x 10 mm F-F spacer + screws (CM4IO above the main board) | M2.5x10 spacer set | 4 | 0.3000 | 1.20 | estimated | [link](https://uk.rs-online.com/web/c/?searchTerm=M2.5+10mm+spacer) | CM4IO standoffs. Estimate (rack PR #126). |
| M3 x 11 mm F-F hex spacer + 2 x M3 x 6 screws (receiver mounts, 2 per slot) | M3x11 spacer set | 16 | 0.3000 | 4.80 | estimated | [link](https://uk.rs-online.com/web/c/?searchTerm=M3+11mm+hex+spacer) | Receiver mounts H1/H2 in each of 8 slots. Estimate (brass class price; rack PR #126). |
| M3 x 5 mm F-F spacer + screws (main board to the case floor, 8 holes) | M3x5 spacer set | 8 | 0.2500 | 2.00 | estimated | [link](https://uk.rs-online.com/web/c/?searchTerm=M3+5mm+spacer) | Main-board mounting. Estimate (rack PR #126). |
| Delivery | - | 1 | 0.0000 | 0.00 | estimated | [link](https://uk.rs-online.com) | Free over GBP 50 ex VAT (pack-parts-uk-draft.md); basket is above it. Estimate. |

## Basket: LCSC

**Basket total: GBP 74.61 ex VAT, VAT 14.92, GBP 89.53 inc VAT.**

| Item | Part number | Qty | Unit (GBP ex VAT) | Line total | Price | Link | Reason / what it unblocks |
|---|---|---:|---:|---:|---|---|---|
| Packs x4 part | BWIPX1-SMA-1.13L150 | 5 | 0.6247 | 3.12 | quoted 2026-11-01 | [link](https://www.lcsc.com/product-detail/C784404.html) | Needed 4 (pack x1; refs -), +1 spare BAT Wireless IPEX-SMA 1.13 mm 150 mm, SMA cut off, ~100 mm kept + 31 mm 0.9 mm wire whip (est. $0.03); qty4 uses the @10 tier $0.7883; converted at 1.31 |
| Packs x4 part | MY-18650-04-J/05-J | 5 | 0.2000 | 1.00 | quoted 2026-11-01 | [link](https://www.lcsc.com/product-detail/C19184125.html) | Needed 4 (pack x1; refs BT1), +1 spare MYOUNG MY-18650-04-J (C19184125, + plate) + MY-18650-05-J (C19184124, - spring) for the printed cradle; USD 0.1481+0.1084 @5, 0.1181+0.1084 @100, converted at 1.31; ex VAT, VAT at LCSC checkout |
| Packs x4 + Receivers x4 + Rack part | C_100n_0402 | 134 | 0.0200 | 2.68 | estimated | [link](https://www.lcsc.com/search?q=C_100n_0402) | Needed 107 (pack x8; rx x12; rack; refs C2 C8 C11 C12 C23 C31 C33 C35 C36 C44 C4), +27 spare rx price from hw/rx/out/bom.csv (est.) |
| Packs x4 + Receivers x4 + Rack part | C_10u_0603_X5R | 79 | 0.0500 | 3.95 | estimated | [link](https://www.lcsc.com/search?q=C_10u_0603_X5R) | Needed 63 (pack x8; rx x7; rack; refs C1 C4 C6 C10 C30 C32 C34), +16 spare rx price from hw/rx/out/bom.csv (est. (10 uF 10 V 0603 X5R)) |
| Packs x4 + Receivers x4 + Rack part | C_1u_0402 | 69 | 0.0200 | 1.38 | estimated | [link](https://www.lcsc.com/search?q=C_1u_0402) | Needed 55 (pack x6; rx x2; rack; refs C3 C5), +14 spare rx price from hw/rx/out/bom.csv (est.) |
| Packs x4 + Receivers x4 + Rack part | R_0402_1% | 360 | 0.0200 | 7.20 | estimated | [link](https://www.lcsc.com/search?q=R_0402_1%) | Needed 288 (pack x20; rx x3; rx x6; rx x9; rx x5; rx x1; rx x1; rx x1; rx x2; rx x2; rx x1; rx x1; rack; refs R20 R31 R32), +72 spare rx price from hw/rx/out/bom.csv (est.) |
| 0451004.MRL | 0451004.MRL | 2 | 0.9000 | 1.80 | estimated | [link](https://www.lcsc.com/search?q=0451004.MRL) | Needed 1 (rack; refs 0451004.MRL), +1 spare rack price from hw/rack/prices.py (est. (Littelfuse Nano2 451 4 A fast 125 V, 2410 case 6.1 x 2.5 mm, LCSC C27515 (LCSC record read 2026-11-01); footprint Fuse_Littelfuse-NANO2-451_453 = the 2410 land)) |
| 2.54-2*13PFemale | 2.54-2*13PFemale | 9 | 0.1700 | 1.53 | estimated | [link](https://www.lcsc.com/search?q=2.54-2*13PFemale) | Needed 8 (rack; refs 2.54-2*13PFemale), +1 spare rack price from hw/rack/prices.py (est. (BOOMELE 2x13 2.54 mm female 8.5 mm, LCSC C64320, USD 0.2225, JLC parts record 2026-11-01 (stock unconfirmed)); contact 14 pulled and the cavity plugged at assembly: the footprint has no hole at 14 (A |
| 2.54-2*20P | 2.54-2*20P | 2 | 0.1000 | 0.20 | estimated | [link](https://www.lcsc.com/search?q=2.54-2*20P) | Needed 1 (rack; refs 2.54-2*20P), +1 spare rack price from hw/rack/prices.py (est. (BOOMELE 2x20 2.54 mm IDC header, LCSC C9138, LCSC record read 2026-11-01)) |
| AO4407A | AO4407A | 2 | 0.2500 | 0.50 | estimated | [link](https://www.lcsc.com/search?q=AO4407A) | Needed 1 (rack; refs AO4407A), +1 spare rack price from hw/rack/prices.py (est. (Alpha & Omega -30 V 12 A P-FET SO-8; DMP3013SFV-7 is 0-stock at DigiKey UK)) |
| B2P-VH | B2P-VH | 2 | 0.1500 | 0.30 | estimated | [link](https://www.lcsc.com/search?q=B2P-VH) | Needed 1 (rack; refs B2P-VH), +1 spare rack price from hw/rack/prices.py (est. (JST B2P-VH 2-pin 3.96 mm header, CM4IO 12 V feed; LCSC C160315)) |
| BZT52C12 | BZT52C12 | 2 | 0.0300 | 0.06 | estimated | [link](https://www.lcsc.com/search?q=BZT52C12) | Needed 1 (rack; refs BZT52C12), +1 spare rack price from hw/rack/prices.py (est. (12 V zener SOD-123)) |
| CM4IO 12 V pigtail: JST VH 2-pin housing to 2.1 mm DC plug, 200 mm | CM4IO-12V-pigtail | 1 | 3.0000 | 3.00 | estimated | [link](https://www.lcsc.com/search?q=JST+VH+2+pin+housing) | Feeds the CM4IO from the main board J5. Estimate (rack PR #126); LCSC or RS UK. |
| CS0603-39NJ-S | CS0603-39NJ-S | 3 | 0.0200 | 0.06 | estimated | [link](https://www.lcsc.com/search?q=CS0603-39NJ-S) | Needed 2 (rack; refs CS0603-39NJ-S), +1 spare rack price from hw/rack/prices.py (est. (Chilisin 39 nH 5 % 0603, SRF 2.2 GHz, Q 40, 600 mA, DCR 0.25 ohm; LCSC C142171, LCSC record read 2026-11-01)) |
| C_10n_0402 | C_10n_0402 | 12 | 0.0200 | 0.24 | estimated | [link](https://www.lcsc.com/search?q=C_10n_0402) | Needed 2 (rack; refs C_10n_0402), +10 spare rack price from hw/rack/prices.py (est.) |
| C_22n_0402 | C_22n_0402 | 30 | 0.0200 | 0.60 | estimated | [link](https://www.lcsc.com/search?q=C_22n_0402) | Needed 20 (rack; refs C_22n_0402), +10 spare rack price from hw/rack/prices.py (est.) |
| C_22u_1206_25V_X5R | C_22u_1206_25V_X5R | 12 | 0.1000 | 1.20 | estimated | [link](https://www.lcsc.com/search?q=C_22u_1206_25V_X5R) | Needed 2 (rack; refs C_22u_1206_25V_X5R), +10 spare rack price from hw/rack/prices.py (est.) |
| C_33n_0402 | C_33n_0402 | 11 | 0.0200 | 0.22 | estimated | [link](https://www.lcsc.com/search?q=C_33n_0402) | Needed 1 (rack; refs C_33n_0402), +10 spare rack price from hw/rack/prices.py (est.) |
| C_33p_0402_C0G | C_33p_0402_C0G | 14 | 0.0200 | 0.28 | estimated | [link](https://www.lcsc.com/search?q=C_33p_0402_C0G) | Needed 4 (rack; refs C_33p_0402_C0G), +10 spare rack price from hw/rack/prices.py (est.) |
| FB_0603_600R | FB_0603_600R | 3 | 0.0300 | 0.09 | estimated | [link](https://www.lcsc.com/search?q=FB_0603_600R) | Needed 2 (rack; refs FB_0603_600R), +1 spare rack price from hw/rack/prices.py (est. (Murata BLM18KG601SN1D 600 ohm 1.3 A 0603; LCSC C85833)) |
| LTST-S270KGKT | LTST-S270KGKT | 9 | 0.0300 | 0.27 | estimated | [link](https://www.lcsc.com/search?q=LTST-S270KGKT) | Needed 8 (rack; refs LTST-S270KGKT), +1 spare rack price from hw/rack/prices.py (est. (Lite-On side-looking green, LCSC C125113, USD 0.042, JLC parts record 2026-11-01 (stock unconfirmed))) |
| LTST-S270KRKT | LTST-S270KRKT | 9 | 0.0300 | 0.27 | estimated | [link](https://www.lcsc.com/search?q=LTST-S270KRKT) | Needed 8 (rack; refs LTST-S270KRKT), +1 spare rack price from hw/rack/prices.py (est. (Lite-On side-looking red, LCSC C125114, USD 0.032, JLC parts record 2026-11-01 (stock unconfirmed))) |
| R_0402_0R | R_0402_0R | 13 | 0.0100 | 0.13 | estimated | [link](https://www.lcsc.com/search?q=R_0402_0R) | Needed 3 (rack; refs R_0402_0R), +10 spare rack price from hw/rack/prices.py (est.) |
| R_0402_100R_TF | R_0402_100R_TF | 24 | 0.0800 | 1.92 | estimated | [link](https://www.lcsc.com/search?q=R_0402_100R_TF) | Needed 14 (rack; refs R_0402_100R_TF), +10 spare rack price from hw/rack/prices.py (est. (100 ohm 0402 thin film, Wilkinson isolation)) |
| R_2512_1R_1W | R_2512_1R_1W | 12 | 0.1000 | 1.20 | estimated | [link](https://www.lcsc.com/search?q=R_2512_1R_1W) | Needed 2 (rack; refs R_2512_1R_1W), +10 spare rack price from hw/rack/prices.py (est. (1 ohm 1 % 2512 1 W thick film)) |
| SDWL1005C18NGSTF | SDWL1005C18NGSTF | 3 | 0.0200 | 0.06 | estimated | [link](https://www.lcsc.com/search?q=SDWL1005C18NGSTF) | Needed 2 (rack; refs SDWL1005C18NGSTF), +1 spare rack price from hw/rack/prices.py (est. (Sunlord 18 nH 2 % 0402, SRF 4.5 GHz; LCSC C361616, LCSC record read 2026-11-01)) |
| SMF12A | SMF12A | 3 | 0.0800 | 0.24 | estimated | [link](https://www.lcsc.com/search?q=SMF12A) | Needed 2 (rack; refs SMF12A), +1 spare rack price from hw/rack/prices.py (est. (SMF 200 W TVS SOD-123F)) |
| XC32M4-14.7456-F20NLDTL | XC32M4-14.7456-F20NLDTL | 3 | 0.0600 | 0.18 | estimated | [link](https://www.lcsc.com/search?q=XC32M4-14.7456-F20NLDTL) | Needed 2 (rack; refs XC32M4-14.7456-F20NLDTL), +1 spare rack price from hw/rack/prices.py (LCSC C3034317 read via the JLC parts API: HCI 14.7456 MHz 3225 20 pF, ESR 60 ohm, -40..+85 C, 10 ppm (LCSC C3034317, USD 0.0814, JLC parts record read 2026-11-01, 6,684 in stock; #126 review: replaces the  |
| Receivers x4 part | ALU_22u_25V | 18 | 0.0500 | 0.90 | estimated | [link](https://www.lcsc.com/search?q=ALU_22u_25V) | Needed 8 (rx x2; refs C43 C49), +10 spare rx price from hw/rx/out/bom.csv (est. (22 uF 25 V SMD aluminium, 5 mm)) |
| Receivers x4 part | ALU_47u_25V | 18 | 0.0600 | 1.08 | estimated | [link](https://www.lcsc.com/search?q=ALU_47u_25V) | Needed 8 (rx x2; refs C9 C40), +10 spare rx price from hw/rx/out/bom.csv (est. (47 uF 25 V SMD aluminium, 5 mm)) |
| Receivers x4 part | BAT54,215 | 13 | 0.0200 | 0.26 | estimated | [link](https://www.lcsc.com/search?q=BAT54,215) | Needed 12 (rx x3; refs D8 D9 D10), +1 spare rx price from hw/rx/out/bom.csv (est. (Nexperia BAT54 SOT-23, q100)) |
| Receivers x4 part | BSS138 | 5 | 0.0400 | 0.20 | estimated | [link](https://www.lcsc.com/search?q=BSS138) | Needed 4 (rx x1; refs Q1), +1 spare rx price from hw/rx/out/bom.csv (est. (onsemi BSS138 SOT-23, q100)) |
| Receivers x4 part | C_10p_0402_C0G | 22 | 0.0200 | 0.44 | estimated | [link](https://www.lcsc.com/search?q=C_10p_0402_C0G) | Needed 12 (rx x3; refs C20 C21 C22), +10 spare rx price from hw/rx/out/bom.csv (est.) |
| Receivers x4 part | C_1n_0402 | 14 | 0.0200 | 0.28 | estimated | [link](https://www.lcsc.com/search?q=C_1n_0402) | Needed 4 (rx x1; refs C60), +10 spare rx price from hw/rx/out/bom.csv (est.) |
| Receivers x4 part | C_2n2_0402_C0G | 14 | 0.0200 | 0.28 | estimated | [link](https://www.lcsc.com/search?q=C_2n2_0402_C0G) | Needed 4 (rx x1; refs C39), +10 spare rx price from hw/rx/out/bom.csv (est.) |
| Receivers x4 part | C_2u2_0603_X7R | 18 | 0.0200 | 0.36 | estimated | [link](https://www.lcsc.com/search?q=C_2u2_0603_X7R) | Needed 8 (rx x2; refs C37 C38), +10 spare rx price from hw/rx/out/bom.csv (est.) |
| Receivers x4 part | PE4259-63 | 5 | 0.4000 | 2.00 | estimated | [link](https://www.lcsc.com/search?q=PE4259-63) | Needed 4 (rx x1; refs U2), +1 spare rx price from hw/rx/out/bom.csv (LCSC C470892 qty-100, via findchips.com/LCSC snapshot read 2026-10-31 (range $0.32-0.49)); x1.3 on the qty-100 figure for a 4-board order |
| Receivers x4 part | PZ254V-12-26P | 5 | 0.3900 | 1.95 | estimated | [link](https://www.lcsc.com/search?q=PZ254V-12-26P) | Needed 4 (rx x1; refs J1), +1 spare rx price from hw/rx/out/bom.csv (est. (XFCN 2x13 2.54 mm THT header, LCSC C22465887, 2401 in stock at JLC 2026-11-01; pin 14 cut for the key; mates the Harwin M20-7831346 socket + M20-003 key in position 14 on the main board, ADR-0018)); x1 |
| Receivers x4 part | R_0603_1% | 30 | 0.0200 | 0.60 | estimated | [link](https://www.lcsc.com/search?q=R_0603_1%) | Needed 20 (rx x1; rx x4; refs R1), +10 spare rx price from hw/rx/out/bom.csv (est.) |
| Receivers x4 part | S1J | 21 | 0.0300 | 0.63 | estimated | [link](https://www.lcsc.com/search?q=S1J) | Needed 20 (rx x5; refs D3 D4 D5 D6 D7), +1 spare rx price from hw/rx/out/bom.csv (est. (S1J 1 A 600 V SMA, IFSM 30 A, q100)) |
| Receivers x4 part | SMF15A | 5 | 0.0800 | 0.40 | estimated | [link](https://www.lcsc.com/search?q=SMF15A) | Needed 4 (rx x1; refs D1), +1 spare rx price from hw/rx/out/bom.csv (est. (SMF 200 W TVS SOD-123F, q100)) |
| Receivers x4 part | SMF5.0A | 5 | 0.0800 | 0.40 | estimated | [link](https://www.lcsc.com/search?q=SMF5.0A) | Needed 4 (rx x1; refs D2), +1 spare rx price from hw/rx/out/bom.csv (est. (SMF 200 W TVS SOD-123F, q100)) |
| Receivers x4 part | U.FL-U.FL-50MM | 4 | 1.4800 | 5.92 | estimated | [link](https://www.lcsc.com/search?q=U.FL-U.FL-50MM) | Needed 4 (rx x1) rx price from hw/rx/out/bom.csv (est.); x1.3 on the qty-100 figure for a 4-board order |
| Receivers x4 + Rack part | ALU_100u_25V | 16 | 0.0800 | 1.28 | estimated | [link](https://www.lcsc.com/search?q=ALU_100u_25V) | Needed 6 (rx x1; rack; refs C7), +10 spare rx price from hw/rx/out/bom.csv (est. (100 uF 25 V SMD aluminium, 6.3 mm)) |
| Receivers x4 + Rack part | C_100p_0402_C0G | 28 | 0.0200 | 0.56 | estimated | [link](https://www.lcsc.com/search?q=C_100p_0402_C0G) | Needed 18 (rx x2; rack; refs C41 C42), +10 spare rx price from hw/rx/out/bom.csv (est.) |
| Receivers x4 + Rack part | C_10u_1206_25V_X7R | 17 | 0.0900 | 1.53 | estimated | [link](https://www.lcsc.com/search?q=C_10u_1206_25V_X7R) | Needed 7 (rx x1; rack; refs C46), +10 spare rx price from hw/rx/out/bom.csv (est. (10 uF 25 V 1206 X7R)) |
| Receivers x4 + Rack part | U.FL-R-SMT-1(10) | 29 | 0.3400 | 9.86 | estimated | [link](https://www.lcsc.com/search?q=U.FL-R-SMT-1(10)) | Needed 28 (rx x1; rx x1; rx x1; rack; refs U.FL-R-SMT-1(10)), +1 spare rack price from hw/rack/prices.py (est. (Hirose U.FL-R-SMT-1(10), LCSC C88373 (not C88374))) |
| Shipping to the UK (courier) + import VAT at checkout | - | 1 | 12.0000 | 12.00 | estimated | [link](https://www.lcsc.com) | LCSC to UK is a worldwide courier. Order is under GBP 135, so VAT (20 %) is collected at checkout and there is no duty. Estimate; UK shipping option not confirmed (LCSC page unreadable per pack-parts-uk-draft.md). |

## Basket: JLCPCB

**Basket total: GBP 396.00 ex VAT, VAT 79.20, GBP 475.20 inc VAT.**

| Item | Part number | Qty | Unit (GBP ex VAT) | Line total | Price | Link | Reason / what it unblocks |
|---|---|---:|---:|---:|---|---|---|
| Pack stencil, top side only, frameless | pack stencil | 1 | 8.0000 | 8.00 | estimated | [link](https://cart.jlcpcb.com/quote) | All 70 pack parts are on Top (cpl_jlc.csv), one stencil. Estimate. |
| Pack PCB, 4-layer, 73.5 x 35.1 mm, 1.6 mm, ENIG, 10 pcs | pack.kicad_pcb | 1 | 28.0000 | 28.00 | estimated | [link](https://cart.jlcpcb.com/quote) | 4 packs plus 6 spares so a re-spin or a bad solder job costs boards, not a new order (ADR-0019). Size/layers from hw/pack/out/fab/pack-job.gbrjob. Estimate; JLCPCB quote page is dynamic and was not readable 2026-11-01. Only published datum: 4-layer board charge USD 70.6/m2 (Mar 2024 news), which makes the board area itself under GBP 1; the rest is engineering fee, ENIG and shipping. Gerbers: hw/pack/out/fab/gerber. No JLC assembly is assumed (ADR-0019: hand/hot-plate reflow). |
| Receiver stencil, top side only, frameless | rx stencil | 1 | 8.0000 | 8.00 | estimated | [link](https://cart.jlcpcb.com/quote) | All 95 receiver parts are on Top, one stencil. Estimate. |
| Receiver sub-board PCB, 4-layer, 48.1 x 90.1 mm, 1.6 mm, ENIG, 10 pcs | rx.kicad_pcb | 1 | 36.0000 | 36.00 | estimated | [link](https://cart.jlcpcb.com/quote) | 4 receivers plus 6 spares (50 ohm RF traces, 4-layer). Size/layers from hw/rx/out/fab/rx-job.gbrjob. Estimate; 5 pcs would do for 4 boards but 10 costs little more. Gerbers: hw/rx/out/fab/gerber. |
| Rack main board, full JLCPCB order: 5 x 4-layer 412 x 321.5 mm ENIG boards, large framed stencil, extended-part fees, DHL ~2 kg, UK import VAT and handling | rack.kicad_pcb | 1 | 300.0000 | 300.00 | estimated | [link](https://cart.jlcpcb.com/quote) | The rack main board (hw/rack/out/fab). One board is used, four are spares (5 is JLC's minimum). ESTIMATE: reviewer's range GBP 250-350 for the whole order, mid value; the JLC quote page needs a browser, so quote before ordering. The figure already includes DHL and UK import VAT, so the VAT column here slightly overstates. Own order: the shipping line above is for the pack and receiver boards. |
| Shipping to the UK (DHL) + import VAT at checkout | - | 1 | 16.0000 | 16.00 | estimated | [link](https://cart.jlcpcb.com/quote) | JLCPCB collects UK VAT (20 %) at checkout; no duty under GBP 135. Estimate. |

## Basket: ITM Components

**Basket total: GBP 316.96 ex VAT, VAT 63.39, GBP 380.35 inc VAT.**

| Item | Part number | Qty | Unit (GBP ex VAT) | Line total | Price | Link | Reason / what it unblocks |
|---|---|---:|---:|---:|---|---|---|
| L-com CA3N030 400-series coax N-male/N-male 9.14 m (30 ft): rack to near wing | CA3N030 | 1 | 45.8000 | 45.80 | quoted 2026-11-01 | [link](https://www.itm.com) | Rack to near-wing boom, owner decision (#126 choice, RK-7h). Owner-given ITM price GBP 45.80 ex VAT, one per rack. |
| L-com CA3N075 400-series coax N-male/N-male 22.86 m (75 ft): rack to far wing | CA3N075 | 1 | 88.0200 | 88.02 | quoted 2026-11-01 | [link](https://www.itm.com) | Rack to far-wing boom (12 m stage). A 30 ft lead does not reach the far wing (design-log RK-7h; audit.py Audit 5 needs 13.6 m on a 6 x 6 m venue). 7.65 dB at 100 ft is the longest the wing noise figure allows. ITM Components UK, ex VAT, read 2026-11-01 (rack PR #126, hw/rack/prices.py ANTENNA_KIT). |
| L-com HyperLink 2.4 GHz 8 dBi flat patch, N-female | HG2409P-NF | 2 | 72.1200 | 144.24 | quoted 2026-11-01 | [link](https://www.itm.com) | One per wing (ADR-0021); R1 antenna. Price from ADR-0016 (ITM Components UK). Assumed ex VAT (ITM lists ex VAT by default); ADR does not state the basis. |
| L-com HGX-PMT07 pole mount bracket for HG2409P | HGX-PMT07 | 2 | 14.4500 | 28.90 | quoted 2026-11-01 | [link](https://www.itm.com) | Holds each panel on the stand pole at 4 m, tilted 10 deg down (ADR-0021). Owner-given ITM price ex VAT. |
| Delivery (antennas and coax) | - | 1 | 10.0000 | 10.00 | estimated | [link](https://www.itm.com) | Coax drums are heavy. Estimate. |

## Basket: Simply Sound & Lighting

**Basket total: GBP 311.66 ex VAT, VAT 62.33, GBP 373.99 inc VAT.**

| Item | Part number | Qty | Unit (GBP ex VAT) | Line total | Price | Link | Reason / what it unblocks |
|---|---|---:|---:|---:|---|---|---|
| Thor winch-up lighting stand | LS003 | 2 | 140.8300 | 281.66 | quoted 2026-11-01, OPTIONAL CUT x2 | [link](https://www.simplysoundandlighting.co.uk) | 4 m mounting height in each wing where the venue has no boom (ADR-0021; install doc step 3). Owner-given ~GBP 140.83 ex VAT each. Large item: delivery is a separate line (estimated). OPTIONAL CUT: the venue's own lighting stands or booms may serve (the HGX-PMT07 U-bolt mounts stay). |
| Delivery (2 stands) | - | 1 | 30.0000 | 30.00 | estimated, OPTIONAL CUT x1 | [link](https://www.simplysoundandlighting.co.uk) | Stands are about 10 kg each. Estimate. Goes with the stands if they are cut. |

## Basket: Rapid Online

**Basket total: GBP 146.76 ex VAT, VAT 29.35, GBP 176.11 inc VAT.**

| Item | Part number | Qty | Unit (GBP ex VAT) | Line total | Price | Link | Reason / what it unblocks |
|---|---|---:|---:|---:|---|---|---|
| Hammond RM1U1913SBK 1U 19 in aluminium case, 330 mm deep | RM1U1913SBK | 1 | 140.7600 | 140.76 | quoted 2026-11-01 | [link](https://www.rapidonline.com) | Rack chassis (mech/rack.py; panels drilled per hw/rack/mech/out). Rapid Online 31-1555, read by the coordinator 2026-11-01, in stock; DigiKey UK HM996-ND GBP 142.98 (90 in stock). |
| Delivery (1U case, about 4 kg) | - | 1 | 6.0000 | 6.00 | estimated | [link](https://www.rapidonline.com) | Rapid UK delivery charge not read. Estimate. |

## Basket: The Pi Hut

**Basket total: GBP 99.03 ex VAT, VAT 19.81, GBP 118.84 inc VAT.**

| Item | Part number | Qty | Unit (GBP ex VAT) | Line total | Price | Link | Reason / what it unblocks |
|---|---|---:|---:|---:|---|---|---|
| Dupont jumper wires F-F 20 cm (40-pack) | Dupont F-F 40 | 2 | 2.5000 | 5.00 | estimated | [link](https://thepihut.com) | Logic analyser probes to DK pins and board test pads (TP1-TP13 on the receiver). Estimate. |
| Micro-USB cable 1 m (DK, PPK2, programming) | USB-A to micro-B 1 m | 3 | 2.5000 | 7.50 | estimated | [link](https://thepihut.com) | Powers/connects 2 DKs and the PPK2. Estimate. |
| Panel-mount USB-C socket to micro-B plug 30 cm, M3 ears 20 mm apart (Adafruit 4056) | Adafruit 4056 | 1 | 3.8300 | 3.83 | quoted 2026-11-01 | [link](https://thepihut.com) | CM4IO rpiboot port on the front panel (RK-1); no CC resistors, so service with a USB-A-to-C lead. The Pi Hut UK SKU 103462, GBP 4.60 inc VAT, read 2026-11-01; SOLD OUT that day (Adafruit direct USD 4.95). Order may wait. |
| Raspberry Pi CM4 2 GB RAM / 8 GB eMMC, no wireless (SC0680 = CM4002008) | CM4002008 | 1 | 79.2000 | 79.20 | quoted 2026-11-01 | [link](https://thepihut.com) | Rack host (ADR-0018). SC0681 (16 GB eMMC) at the same price is the drop-in alternative. The Pi Hut UK qty 1, 2026-11-01 (coordinator decision on #95; DigiKey UK SC0680 was 0 stock at GBP 61.64). |
| Delivery | - | 1 | 3.5000 | 3.50 | estimated | [link](https://thepihut.com) | Standard. Estimate. |

## Basket: Thomann

**Basket total: GBP 26.50 ex VAT, VAT 5.30, GBP 31.80 inc VAT.**

| Item | Part number | Qty | Unit (GBP ex VAT) | Line total | Price | Link | Reason / what it unblocks |
|---|---|---:|---:|---:|---|---|---|
| Lavalier microphone, 3.5 mm TRS, omni electret | Samson LM5 (or equivalent) | 1 | 15.0000 | 15.00 | estimated | [link](https://www.thomann.de/gb/samson_lm5.htm) | Real source for the preamp/ADC chain on the bench (noise, THD, start-up) and R5 listening checks. Estimate; Thomann UK site ships to the UK (GBP prices inc VAT at checkout). Final show mic is the owner's choice and out of scope. |
| Cable 3.5 mm TRS to 3.5 mm TRS 1.5 m | TRS-TRS 1.5 m | 1 | 3.5000 | 3.50 | estimated | [link](https://www.thomann.de/gb/) | DAC output to the PC sound card / headphone amp during #38. Estimate. |
| Delivery to the UK | - | 1 | 8.0000 | 8.00 | estimated | [link](https://www.thomann.de/gb/) | Thomann ships from Germany; UK prices include VAT at checkout. Estimate. |

## Basket: Lab401 (EU)

**Basket total: GBP 155.00 ex VAT, VAT 31.00, GBP 186.00 inc VAT.**

| Item | Part number | Qty | Unit (GBP ex VAT) | Line total | Price | Link | Reason / what it unblocks |
|---|---|---:|---:|---:|---|---|---|
| tinySA Ultra+ spectrum analyser 100 kHz-5.4 GHz (CE version) | tinySA Ultra+ | 1 | 140.0000 | 140.00 | quoted 2026-11-01 | [link](https://lab401.com/products/tinysa-ultra) | #92 / design-log AN-risk 2: conducted TX power and the 99 % OBW and 2483.5-2487.6 MHz emissions on a pack at 2482 MHz (limit 2.51 MHz OBW). Cheapest adequate; indicative, not a lab EN 300 328 report. DECISION: no UK stockist found (tinysa.org buy page 404, Technofix not found, eBay 403, Amazon UK not found). Lab401 (France, EU) sells the Ultra+ (the current CE-compliant model; the original Ultra is retired at eleshop.eu), EUR 163.00 on 2026-11-01, in stock for EU, UK is in its country list but UK shipping was not confirmed. GBP 140 = EUR 163 x 0.86 (assumed rate; VAT basis of the EUR price not stated). Delivery line is an estimate. Input max is +10 dBm so the 20 dB attenuator is belt and braces. Fallback: Siglent SSA1015X-class from RS UK (about GBP 700). |
| Delivery to the UK (courier) + import VAT at the door | - | 1 | 15.0000 | 15.00 | estimated | [link](https://lab401.com) | EU seller; post-Brexit UK import VAT (20 %) is collected by the courier, unit is under GBP 135. Estimate; shipping is calculated at checkout. |

## Basket: The Debug Store

**Basket total: GBP 51.00 ex VAT, VAT 10.20, GBP 61.20 inc VAT.**

| Item | Part number | Qty | Unit (GBP ex VAT) | Line total | Price | Link | Reason / what it unblocks |
|---|---|---:|---:|---:|---|---|---|
| Tag-Connect TC2030-IDC-NL cable (2x5 1.27 mm to TC2030 no-legs) | TC2030-IDC-NL | 1 | 46.0000 | 46.00 | quoted 2026-11-01 | [link](https://thedebugstore.com/products/tag-connect-tc2030-idc-nl-cable-uk) | Programs and debugs the pack and receiver boards (both carry TC2030 pads only, no header). Not in either BOM, so a missing item. UK Tag-Connect stockist. GBP 46.00 ex VAT from the search-result snippet (55.20 inc); the product page read 2026-11-01 showed 42.00 ex VAT and is internally inconsistent, so the higher figure is used. SOLD OUT on the page, dispatch within 10 working days if ordered. Digi-Key UK does not list the -NL cable (only TC2030-IDC with legs, GBP 33.31, 339 in stock, which needs mounting holes the boards lack). |
| Delivery | - | 1 | 5.0000 | 5.00 | estimated | [link](https://thedebugstore.com) | UK seller. Estimate. |

## Basket: Knives and Tools UK

**Basket total: GBP 24.92 ex VAT, VAT 4.98, GBP 29.90 inc VAT.**

| Item | Part number | Qty | Unit (GBP ex VAT) | Line total | Price | Link | Reason / what it unblocks |
|---|---|---:|---:|---:|---|---|---|
| External 18650 charger, 2-bay, USB (Nitecore UI2) | Nitecore UI2 | 1 | 16.6300 | 16.63 | quoted 2026-11-01 | [link](https://knivesandtools.co.uk/en/pt/-nitecore-ui2-battery-charger.htm) | The pack has no charging circuit (PK-6), so cells charge externally. GBP 19.95 inc VAT on the page 2026-11-01 (16.63 ex; a search snippet showed 15.45), in stock, ships from the Netherlands. LED, no display. |
| Delivery (fixed rate, from the Netherlands) | - | 1 | 8.2900 | 8.29 | quoted 2026-11-01 | [link](https://knivesandtools.co.uk/en/pt/-nitecore-ui2-battery-charger.htm) | Fixed GBP 9.95 inc VAT for all orders. Page read 2026-11-01. |

## Basket: 123-3D UK

**Basket total: GBP 15.67 ex VAT, VAT 3.13, GBP 18.80 inc VAT.**

| Item | Part number | Qty | Unit (GBP ex VAT) | Line total | Price | Link | Reason / what it unblocks |
|---|---|---:|---:|---:|---|---|---|
| PETG filament 1.75 mm, 1 kg spool (eSun solid grey; enclosures + belt clips) | eSun PETG 1 kg | 1 | 11.6700 | 11.67 | quoted 2026-11-01 | [link](https://www.123-3d.co.uk/eSun-PETG-filament-1-75mm-Solid-Grey-1-kg-i9656.html) | ADR-0008: printed PETG body, clip and cradle on the Bambu A1 mini (assumed owned, not listed). About 30 g per pack; 1 kg covers reprints. SEARCH-RESULT SNIPPET, 2026-11-01: GBP 14.00 inc, 11.67 ex VAT. The product page returned HTTP 429, stock not confirmed; other 123-3D snippets disagreed (13.33 to 19.96 ex). |
| Delivery | - | 1 | 4.0000 | 4.00 | estimated | [link](https://www.123-3d.co.uk) | Standard. Estimate. |

## Basket: tinySA reseller (UK)

**Basket total: GBP 0.00 ex VAT, VAT 0.00, GBP 0.00 inc VAT.**

| Item | Part number | Qty | Unit (GBP ex VAT) | Line total | Price | Link | Reason / what it unblocks |
|---|---|---:|---:|---:|---|---|---|
| NanoVNA-H4 vector network analyser | NanoVNA-H4 | 1 | 75.0000 | 75.00 | estimated, OPTIONAL | [link](https://nanovna.com) | Optional: RF-11 (QPQ1907 loss at band edges), antenna/coax S11, receiver RF chain S2P checks. Optional. Estimate. UK stockist not confirmed; not searched. |

## Summary by category

| Category | Ex VAT | VAT 20 % | Inc VAT |
|---|---:|---:|---:|
| Bench kit | 466.66 | 93.33 | 559.99 |
| Packs x4 | 133.85 | 26.77 | 160.62 |
| Packs x4 + Receivers x4 | 17.84 | 3.57 | 21.41 |
| Rack | 709.35 | 141.87 | 851.22 |
| Receivers x4 | 85.87 | 17.17 | 103.04 |
| Receivers x4 + Rack | 17.13 | 3.43 | 20.56 |
| Shipping | 127.79 | 25.56 | 153.35 |
| Antennas, coax, stands | 605.42 | 121.08 | 726.50 |
| Mechanical and cells | 117.67 | 23.53 | 141.20 |
| Packs x4 + Receivers x4 + Rack | 15.21 | 3.04 | 18.25 |
| PCB fabrication | 80.00 | 16.00 | 96.00 |
| **Total** | **2,376.79** | **475.36** | **2,852.15** |

Shipping is its own category. Lines marked OPTIONAL are excluded; the optional cuts above are included.
