saturncity/openpack/hw/bom/shopping.csv

basket | category | item | mpn | qty | unit_gbp_ex | line_gbp_ex | line_vat | price_status | source_url | date_read | required | cut_qty | reason | notes
Digi-Key UK | Bench kit | PCM5102A I2S DAC breakout board (Adafruit 6250) | Adafruit 6250 | 1 | 3.7 | 3.7 | 0.74 | quoted | https://www.digikey.co.uk/en/products/result?keywords=1528-6250-ND | 2026-11-01 | yes | 0 | #38 I2S backend and the DAC output chain on the bench; FLT/XSMT strap tests (ADR-0017). | Digi-Key UK 2026-11-01: GBP 3.70 ex VAT (4.44 inc), 494 in stock. The Pi Hut search found no PCM5102 board.
Digi-Key UK | Bench kit | u.FL to SMA female pigtail 150 mm (GCT) | CABLE 348 RF-150-A-1 | 2 | 2.19 | 4.38 | 0.88 | quoted | https://www.digikey.co.uk/en/products/result?keywords=U.FL%20to%20SMA%20cable%20assembly | 2026-11-01 | yes | 0 | Connects the pack/receiver u.FL (and the DK RF connector) to the SMA attenuator and analyser. | Digi-Key UK 2026-11-01: GBP 2.19 ex VAT, 1,228 in stock; U.FL (MHF1) to SMA, 5.9 in. Check the SMA end is a jack (listing does not say) before ordering.
Digi-Key UK | Bench kit | TI PCM1840 evaluation module | PCM1840EVM | 1 | 148.84 | 148.84 | 29.77 | quoted | https://www.digikey.co.uk/en/products/result?keywords=PCM1840EVM | 2026-11-01 | optional | 0 | #38 ADC delay and noise measured before the pack is populated (ADR-0019 mitigation). | Digi-Key UK 2026-11-01: GBP 148.84 ex VAT (178.61 inc), 2 in stock, 12 week factory lead time, purchase limit applies. Was estimated at 55: nearly 3x higher. Order early; Mouser UK page timed out. OPTIONAL: under the single-purchase plan (ADR-0019) the PCM1840 arrives on our own pack boards at the same time, so a separate eval board adds no earlier test step.
Digi-Key UK | Bench kit | 8-channel 24 MHz USB logic analyser (Cypress FX2, sigrok fx2lafw), SparkFun | SparkFun 18627 | 1 | 20.44 | 20.44 | 4.09 | quoted | https://www.digikey.co.uk/en/products/result?keywords=logic%20analyzer%20USB%208%20channel | 2026-11-01 | yes | 0 | #38 end-to-end latency via GPIO toggles; I2S and frame-clock phasing (ADR-0020/0022). 24 MHz sampling is 40 ns against ms-scale latency. | Digi-Key UK 2026-11-01: GBP 20.44 ex VAT, 968 in stock; the SparkFun unit is documented for sigrok PulseView. The Pi Hut lists the same unit at GBP 26.30 inc VAT (21.92 ex) but SOLD OUT 2026-11-01.
Digi-Key UK | Bench kit | SMA attenuator 10 dB 2 W DC-6 GHz (Mini-Circuits) | VAT-10W2+ | 1 | 28.18 | 28.18 | 5.64 | quoted | https://www.digikey.co.uk/en/products/result?keywords=attenuator%20SMA%2010dB | 2026-11-01 | yes | 0 | Stacks to 30 dB for the nRF21540 +20 dBm case if the FEM is fitted. | Digi-Key UK 2026-11-01: GBP 28.18 ex VAT, 455 in stock. Cheaper DC-4 GHz Cinch part exists (GBP 17.95) but would not cover harmonics.
Digi-Key UK | Bench kit | SMA attenuator 20 dB 2 W DC-6 GHz (Mini-Circuits) | VAT-20W2+ | 1 | 33.63 | 33.63 | 6.73 | quoted | https://www.digikey.co.uk/en/products/result?keywords=attenuator%20SMA%2020dB%202W | 2026-11-01 | yes | 0 | Protects the tinySA input while measuring conducted TX power at the pack u.FL (limit +7 dBm, ADR-0016/design-log). | Digi-Key UK 2026-11-01: GBP 33.63 ex VAT, 137 in stock.
Digi-Key UK | Bench kit | Nordic Power Profiler Kit II | nRF-PPK2 | 1 | 80.17 | 80.17 | 16.03 | quoted | https://www.digikey.co.uk/en/products/result?keywords=nRF-PPK2 | 2026-11-01 | yes | 1 | #38 FEM and pack current; sources/measures 0.8-5 V for the battery-life check. | Digi-Key UK 2026-11-01: GBP 80.17 ex VAT (96.20 inc), 1,798 in stock. OPTIONAL CUT (listed under the optional cuts).
Digi-Key UK | Bench kit | nRF5340-DK | nRF5340-DK | 2 | 36.58 | 73.16 | 14.63 | quoted | https://www.digikey.co.uk/en/products/result?keywords=nRF5340-DK | 2026-11-01 | yes | 1 | Phase 5 DK bring-up (#38): ADC/DAC delay, T_GAP, lock, end-to-end latency. Second DK is the peer. OPTIONAL CUT: the second DK (GBP 36.58) is listed under the optional cuts. | Digi-Key UK result page 2026-11-01: GBP 36.58 qty 1 (DK UK shows ex VAT; the page does not label it). Stock level not shown on the result page. Also stocked by Mouser UK and Farnell UK (their pages timed out).
Digi-Key UK | Packs x4 | BAV199,215 | BAV199,215 | 5 | 0.16 | 0.8 | 0.16 | estimated | https://www.digikey.co.uk/en/products/detail/nexperia-usa-inc/BAV199-215/763223 |  | yes | 0 | Needed 4 (pack x1; refs D6), +1 spare | q4 from DK UK listing (VAT basis not stated); qty100 ESTIMATE
Digi-Key UK | Packs x4 | BT40NE | BT40NE | 4 | 16.34 | 65.36 | 13.07 | quoted | https://www.digikey.co.uk/en/products/detail/fanstel-corp/BT40NE/22107427 | 2026-10-31 | yes | 0 | Needed 4 (pack x1) | DK UK ex-VAT breaks; Fanstel direct (fanstel.com) also sells; no Farnell/RS/Mouser UK listing found
Digi-Key UK | Packs x4 | C_10u_1206_X7R | C_10u_1206_X7R | 30 | 0.1 | 3.0 | 0.6 | estimated | https://www.digikey.co.uk/en/products/result?keywords=C_10u_1206_X7R |  | yes | 0 | Needed 20 (pack x5; refs C10 C15 C16 C17 C18), +10 spare | ESTIMATE; e.g. Samsung CL31B106KOHNNNE (verify 16V)
Digi-Key UK | Packs x4 | C_22p_0402_C0G | C_22p_0402_C0G | 14 | 0.015 | 0.21 | 0.04 | estimated | https://www.digikey.co.uk/en/products/result?keywords=C_22p_0402_C0G |  | yes | 0 | Needed 4 (pack x1; refs C9), +10 spare | ESTIMATE; e.g. GRM1555C1H220JA01D
Digi-Key UK | Packs x4 | DFE252012F-1R0M=P2 | DFE252012F-1R0M=P2 | 5 | 0.19 | 0.95 | 0.19 | quoted | https://www.digikey.co.uk/en/products/result?keywords=DFE252012F-1R0M%3DP2 | 2026-10-31 | yes | 0 | Needed 4 (pack x1; refs L1), +1 spare | ex VAT
Digi-Key UK | Packs x4 | GRM21BR61A226ME51L | GRM21BR61A226ME51L | 18 | 0.15 | 2.7 | 0.54 | quoted | https://www.digikey.co.uk/en/products/result?keywords=GRM21BR61A226ME51L | 2026-10-31 | yes | 0 | Needed 8 (pack x2; refs C2 C3), +10 spare | ex VAT; GRM188R61A226ME15D (0603, 104k stock) is NOT same footprint
Digi-Key UK | Packs x4 | GRM31CR60J107ME39L | GRM31CR60J107ME39L | 14 | 0.5 | 7.0 | 1.4 | estimated | https://www.digikey.co.uk/en/products/result?keywords=GRM31CR60J107ME39L |  | yes | 0 | Needed 4 (pack x1; refs C12), +10 spare | FLAG: swap to Samsung CL31A107MQHNNNE (100uF 1206 6.3V X5R) GBP0.50 @1 at DK UK; qty100 ESTIMATE; check DC-bias derating and Samsung datasheet before adopting. Schematic NOT changed
Digi-Key UK | Packs x4 | GRM31CR61A476ME15L | GRM31CR61A476ME15L | 14 | 0.31 | 4.34 | 0.87 | quoted | https://www.digikey.co.uk/en/products/result?keywords=GRM31CR61A476ME15L | 2026-10-31 | yes | 0 | Needed 4 (pack x1; refs C8), +10 spare | ex VAT
Digi-Key UK | Packs x4 | JS102011SAQN | JS102011SAQN | 5 | 0.67 | 3.35 | 0.67 | quoted | https://www.digikey.co.uk/en/products/result?keywords=JS102011SAQN | 2026-10-31 | yes | 0 | Needed 4 (pack x1; refs SW1), +1 spare | cut tape; ex VAT
Digi-Key UK | Packs x4 | LTST-C191KGKT | LTST-C191KGKT | 5 | 0.11 | 0.55 | 0.11 | quoted | https://www.digikey.co.uk/en/products/detail/liteon/LTST-C191KGKT/386835 | 2026-10-31 | yes | 0 | Needed 4 (pack x1; refs D1), +1 spare | q4 listing; qty100 assumed = KRKT tier (same series)
Digi-Key UK | Packs x4 | LTST-C191KRKT | LTST-C191KRKT | 9 | 0.11 | 0.99 | 0.2 | quoted | https://www.digikey.co.uk/en/products/result?keywords=LTST-C191KRKT | 2026-10-31 | yes | 0 | Needed 8 (pack x2; refs D2 D4), +1 spare | used twice (D2, D4); ex VAT
Digi-Key UK | Packs x4 | LTST-C191KSKT | LTST-C191KSKT | 5 | 0.12 | 0.6 | 0.12 | quoted | https://www.digikey.co.uk/en/products/result?keywords=LTST-C191KSKT | 2026-10-31 | yes | 0 | Needed 4 (pack x1; refs D3), +1 spare | ex VAT
Digi-Key UK | Packs x4 | PCM1840IRTWR | PCM1840IRTWR | 4 | 3.96 | 15.84 | 3.17 | quoted | https://www.digikey.co.uk/en/products/result?keywords=PCM1840IRTWR | 2026-10-31 | yes | 0 | Needed 4 (pack x1) | ex VAT; 296-PCM1840IRTWRCT-ND; Mouser 595-PCM1840IRTWR also lists (UK page not fetched)
Digi-Key UK | Packs x4 | SF-1206F300-2 | SF-1206F300-2 | 5 | 0.67 | 3.35 | 0.67 | quoted | https://www.digikey.co.uk/en/products/result?keywords=SF-1206F300-2 | 2026-10-31 | yes | 0 | Needed 4 (pack x1; refs F1), +1 spare | ex VAT
Digi-Key UK | Packs x4 | SJ1-3543 | SJ1-3543 | 4 | 1.67 | 6.68 | 1.34 | quoted | https://www.digikey.co.uk/en/products/detail/same-sky-formerly-cui-devices/SJ1-3543/738704 | 2026-10-31 | yes | 0 | Needed 4 (pack x1) | ex VAT; bag packaging
Digi-Key UK | Packs x4 | TLV75533PDBVR | TLV75533PDBVR | 9 | 0.31 | 2.79 | 0.56 | quoted | https://www.digikey.co.uk/en/products/result?keywords=TLV75533PDBVR | 2026-10-31 | yes | 0 | Needed 8 (pack x2; refs U5 U6), +1 spare | ex VAT; qty4 order=8 (1-pc tier); qty100 order=200 (100 tier)
Digi-Key UK | Packs x4 | TPD1E10B06DPYR | TPD1E10B06DPYR | 5 | 0.31 | 1.55 | 0.31 | estimated | https://www.digikey.co.uk/en/products/detail/texas-instruments/TPD1E10B06DPYR/3197744 |  | yes | 0 | Needed 4 (pack x1; refs D5), +1 spare | q4 from DK UK listing; qty100 ESTIMATE
Digi-Key UK | Packs x4 | TPS61023DRLR | TPS61023DRLR | 4 | 1.03 | 4.12 | 0.82 | quoted | https://www.digikey.co.uk/en/products/result?keywords=TPS61023DRLR | 2026-10-31 | yes | 0 | Needed 4 (pack x1) | ex VAT; qty4 uses 1-pc tier
Digi-Key UK | Packs x4 | USB4105-GF-A | USB4105-GF-A | 5 | 0.6 | 3.0 | 0.6 | estimated | https://www.digikey.co.uk/en/products/detail/gct/USB4105-GF-A/11198441 |  | yes | 0 | Needed 4 (pack x1; refs J2), +1 spare | q4 price from DK UK listing (VAT basis not stated); qty100 ESTIMATE (no UK tier read)
Digi-Key UK | Packs x4 | USBLC6-2SC6 | USBLC6-2SC6 | 5 | 0.4 | 2.0 | 0.4 | quoted | https://www.digikey.co.uk/en/products/detail/stmicroelectronics/USBLC6-2SC6/1040559 | 2026-10-31 | yes | 0 | Needed 4 (pack x1; refs U7), +1 spare | ex VAT
Digi-Key UK | Packs x4 + Receivers x4 | OPA1656IDR | OPA1656IDR | 8 | 2.23 | 17.84 | 3.57 | quoted | https://www.digikey.co.uk/en/products/result?keywords=OPA1656IDR | 2026-10-31 | yes | 0 | Needed 8 (pack x1; rx x1) | ex VAT; 296-OPA1656IDRCT-ND
Digi-Key UK | Rack | 5415025-1 | 5415025-1 | 2 | 6.95 | 13.9 | 2.78 | estimated | https://www.digikey.co.uk/en/products/result?keywords=5415025-1 |  | yes | 0 | Needed 2 (rack) | rack price from hw/rack/prices.py (est. (TE right-angle PCB BNC 50 ohm 4 GHz, 1/2-28 bulkhead; buy UK: DigiKey UK / Mouser UK, LCSC C5164649 USD 9.15 for reference; Molex 73138-5033 is the drop-in alternative))
Digi-Key UK | Rack | UK mains cord BS1363 to C13, 1.83 m | AC-12206-UK | 1 | 8.35 | 8.35 | 1.67 | quoted | https://www.digikey.co.uk/en/products/result?keywords=AC-12206-UK | 2026-11-01 | yes | 0 | Mains lead for the 12 V brick. | Digi-Key UK 2026-11-01, read (7,931 in stock).
Digi-Key UK | Rack | Mean Well GST60A12-P1J 12 V 5 A desktop brick, 2.1 mm plug, C14 inlet | GST60A12-P1J | 1 | 14.5 | 14.5 | 2.9 | quoted | https://www.digikey.co.uk/en/products/result?keywords=GST60A12-P1J | 2026-11-01 | yes | 0 | Rack 12 V supply. | Digi-Key UK 2026-11-01, read (6,852 in stock).
Digi-Key UK | Rack | 40-way IDC ribbon 152 mm socket-socket (Assmann H3AAH-4006G) | H3AAH-4006G | 1 | 1.3 | 1.3 | 0.26 | quoted | https://www.digikey.co.uk/en/products/result?keywords=H3AAH-4006G | 2026-11-01 | yes | 0 | Main board J2 to CM4IO J8. | Digi-Key UK 2026-11-01, read.
Digi-Key UK | Rack | NC3MAH | NC3MAH | 8 | 2.08 | 16.64 | 3.33 | quoted | https://www.digikey.co.uk/en/products/result?keywords=NC3MAH | 2026-11-01 | yes | 0 | Needed 8 (rack) | rack price from hw/rack/prices.py (DigiKey UK 2026-11-01, read (Neutrik NC3MAH; the LCSC buy is C5154126, Extended, price there unconfirmed))
Digi-Key UK | Rack | Neutrik NE8FDP etherCON RJ45 feedthrough (rear panel) | NE8FDP | 1 | 12.78 | 12.78 | 2.56 | quoted | https://www.digikey.co.uk/en/products/result?keywords=NE8FDP | 2026-11-01 | yes | 0 | Rear-panel network port. | Digi-Key UK 2026-11-01, read.
Digi-Key UK | Rack | PJ-063AH | PJ-063AH | 1 | 1.22 | 1.22 | 0.24 | quoted | https://www.digikey.co.uk/en/products/result?keywords=PJ-063AH | 2026-11-01 | yes | 0 | Needed 1 (rack) | rack price from hw/rack/prices.py (DigiKey UK 2026-11-01, read (CUI / Same Sky PJ-063AH 2.1 mm 8 A, 34,138 in stock; not locking): buy UK)
Digi-Key UK | Rack | QPL9057TR7 | QPL9057TR7 | 2 | 4.6 | 9.2 | 1.84 | quoted | https://www.digikey.co.uk/en/products/result?keywords=QPL9057TR7 | 2026-11-01 | yes | 0 | Needed 2 (rack) | rack price from hw/rack/prices.py (DigiKey UK 2026-11-01, read (61,763 in stock); 25+ GBP 3.77, 100+ GBP 3.17)
Digi-Key UK | Rack | QPQ1907SR | QPQ1907SR | 2 | 2.82 | 5.64 | 1.13 | quoted | https://www.digikey.co.uk/en/products/result?keywords=QPQ1907SR | 2026-11-01 | yes | 0 | Needed 2 (rack) | rack price from hw/rack/prices.py (DigiKey UK 2026-11-01, read (7,548 in stock; 33-week lead); IL 1.3 typ / 2.2 max dB)
Digi-Key UK | Rack | Raspberry Pi CM4 IO Board (SC0326) | SC0326 | 1 | 26.15 | 26.15 | 5.23 | quoted | https://www.digikey.co.uk/en/products/result?keywords=SC0326 | 2026-11-01 | yes | 0 | CM4 carrier for the rack host. | Digi-Key UK 2026-11-01, read.
Digi-Key UK | Rack | SC16IS752IPW,128 | SC16IS752IPW,128 | 2 | 5.92 | 11.84 | 2.37 | quoted | https://www.digikey.co.uk/en/products/result?keywords=SC16IS752IPW,128 | 2026-11-01 | yes | 0 | Needed 2 (rack) | rack price from hw/rack/prices.py (DigiKey UK 2026-11-01, read (11,036 in stock); the ,112 tube variant is obsolete)
Digi-Key UK | Rack | SMAJ58CA | SMAJ58CA | 17 | 0.36 | 6.12 | 1.22 | quoted | https://www.digikey.co.uk/en/products/result?keywords=SMAJ58CA | 2026-11-01 | yes | 0 | Needed 16 (rack; refs SMAJ58CA), +1 spare | rack price from hw/rack/prices.py (DigiKey UK 2026-11-01, read (Littelfuse))
Digi-Key UK | Rack | SMBJ12A | SMBJ12A | 2 | 0.37 | 0.74 | 0.15 | quoted | https://www.digikey.co.uk/en/products/result?keywords=SMBJ12A | 2026-11-01 | yes | 0 | Needed 1 (rack; refs SMBJ12A), +1 spare | rack price from hw/rack/prices.py (DigiKey UK 2026-11-01, read (Littelfuse))
Digi-Key UK | Rack | SRP5030T-6R8M | SRP5030T-6R8M | 2 | 0.62 | 1.24 | 0.25 | estimated | https://www.digikey.co.uk/en/products/result?keywords=SRP5030T-6R8M |  | yes | 0 | Needed 1 (rack; refs SRP5030T-6R8M), +1 spare | rack price from hw/rack/prices.py (est. (Bourns SRP5030T-6R8M 6.8 uH, Irms 4.0 A, Isat 4.3 A, DCR 76.2 mohm, Bourns datasheet read 2026-11-01; buy UK, not LCSC: C177249 is only 3.5 A))
Digi-Key UK | Rack | TPS259531DSGR | TPS259531DSGR | 9 | 0.558 | 5.02 | 1.0 | quoted | https://www.digikey.co.uk/en/products/result?keywords=TPS259531DSGR | 2026-11-01 | yes | 0 | Needed 8 (rack; refs TPS259531DSGR), +1 spare | rack price from hw/rack/prices.py (DigiKey UK 2026-11-01, read qty-10 break (4,178 in stock))
Digi-Key UK | Rack | TPS259541DSGR | TPS259541DSGR | 13 | 0.558 | 7.25 | 1.45 | quoted | https://www.digikey.co.uk/en/products/result?keywords=TPS259541DSGR | 2026-11-01 | yes | 0 | Needed 12 (rack; refs TPS259541DSGR), +1 spare | rack price from hw/rack/prices.py (DigiKey UK 2026-11-01, read qty-10 break; 20-week lead, stock not shown)
Digi-Key UK | Rack | TPS62933DRLR | TPS62933DRLR | 1 | 1.2 | 1.2 | 0.24 | estimated | https://www.digikey.co.uk/en/products/result?keywords=TPS62933DRLR |  | yes | 0 | Needed 1 (rack) | rack price from hw/rack/prices.py (est. (TI TPS62933 3 A buck, SOT-583))
Digi-Key UK | Receivers x4 | BT40E | BT40E | 4 | 9.77 | 39.08 | 7.82 | quoted | https://www.digikey.co.uk/en/products/result?keywords=BT40E | 2026-11-01 | yes | 0 | Needed 4 (rx x1) | rx price from hw/rx/out/bom.csv (Digi-Key UK qty-100 cut tape GBP 9.7765, part 13174285, 803 in stock, 10 wk lead (read 2026-11-01))
Digi-Key UK | Receivers x4 | PCM5102APWR | PCM5102APWR | 4 | 2.77 | 11.08 | 2.22 | estimated | https://www.digikey.co.uk/en/products/result?keywords=PCM5102APWR |  | yes | 0 | Needed 4 (rx x1) | rx price from hw/rx/out/bom.csv (Digi-Key qty-100, via findchips.com snapshot read 2026-10-31 (Mouser q100 $2.78)); x1.3 on the qty-100 figure for a 4-board order
Digi-Key UK | Receivers x4 | TPS3808G01DBVR | TPS3808G01DBVR | 5 | 0.79 | 3.95 | 0.79 | estimated | https://www.digikey.co.uk/en/products/result?keywords=TPS3808G01DBVR |  | yes | 0 | Needed 4 (rx x1; refs U7), +1 spare | rx price from hw/rx/out/bom.csv (est. (TI TPS3808 adjustable supervisor, SOT-23-6, q100)); x1.3 on the qty-100 figure for a 4-board order
Digi-Key UK | Receivers x4 + Rack | TLV76733DGNR | TLV76733DGNR | 10 | 0.39 | 3.9 | 0.78 | estimated | https://www.digikey.co.uk/en/products/result?keywords=TLV76733DGNR |  | yes | 0 | Needed 9 (rx x2; rack; refs U4 U5), +1 spare | rx price from hw/rx/out/bom.csv (est. (TI TLV767 1 A 16 V LDO, HVSSOP-8, q100)); x1.3 on the qty-100 figure for a 4-board order
Digi-Key UK | Shipping | Delivery (UPS, duty-paid) | - | 1 | 0.0 | 0.0 | 0.0 | estimated | https://www.digikey.co.uk |  | yes | 0 | Free above the Digi-Key UK threshold (about GBP 33, unconfirmed); basket is far above it. | Estimate.
Mouser UK | Packs x4 | DMG2305UX-7 | DMG2305UX-7 | 5 | 0.11 | 0.55 | 0.11 | estimated | https://www.mouser.co.uk/ProductDetail/621-DMG2305UX-7 |  | yes | 0 | Needed 4 (pack x1; refs Q1), +1 spare | DK UK shows 0 stock/backorder. Prices from search snippets, UNVERIFIED; alt source RS UK https://uk.rs-online.com/web/p/mosfets/8270452 . DMP2305U-7 also 0 stock at DK (40 wk) so not a useful swap
Mouser UK | Shipping | Delivery | - | 1 | 6.0 | 6.0 | 1.2 | estimated | https://www.mouser.co.uk |  | yes | 0 | Small basket; Mouser UK free-shipping threshold not confirmed. | Estimate.
Farnell UK | Bench kit | SMA male-male adapter | SMA-MM | 2 | 3.0 | 6.0 | 1.2 | estimated | https://uk.farnell.com/w/search?st=SMA+male+male+adapter |  | yes | 0 | Joins attenuators to the tinySA. | Estimate.
Farnell UK | Rack | ESD101-B1-02EL | ESD101-B1-02EL | 3 | 0.3 | 0.9 | 0.18 | estimated | https://uk.farnell.com/w/search?st=ESD101-B1-02EL |  | yes | 0 | Needed 2 (rack; refs ESD101-B1-02EL), +1 spare | rack price from hw/rack/prices.py (est. (Infineon 5.5 V 0.1 pF RF ESD, TSLP-2-20; Farnell UK 2480926))
Farnell UK | Rack | ESD103-B1-02EL | ESD103-B1-02EL | 3 | 0.3 | 0.9 | 0.18 | estimated | https://uk.farnell.com/w/search?st=ESD103-B1-02EL |  | yes | 0 | Needed 2 (rack; refs ESD103-B1-02EL), +1 spare | rack price from hw/rack/prices.py (est. (Infineon 15 V 0.09 pF RF ESD, TSLP-2-20; Farnell UK 2725731, LCSC C535146))
Farnell UK | Receivers x4 | ALU_BP_47u_63V | ALU_BP_47u_63V | 18 | 0.19 | 3.42 | 0.68 | estimated | https://uk.farnell.com/w/search?st=ALU_BP_47u_63V |  | yes | 0 | Needed 8 (rx x2; refs C47 C48), +10 spare | rx price from hw/rx/out/bom.csv (est. (47 uF 63 V bipolar aluminium, 10 mm, e.g. Nichicon UEP series))
Farnell UK | Receivers x4 | TQ2SA-12V | TQ2SA-12V | 4 | 3.16 | 12.64 | 2.53 | estimated | https://uk.farnell.com/w/search?st=TQ2SA-12V |  | yes | 0 | Needed 4 (rx x1) | rx price from hw/rx/out/bom.csv (est. (Panasonic TQ2 DPDT 12 V signal relay, q100; Farnell UK 1124056)); x1.3 on the qty-100 figure for a 4-board order
Farnell UK | Shipping | Delivery | - | 1 | 4.0 | 4.0 | 0.8 | estimated | https://uk.farnell.com |  | yes | 0 | Under the free-delivery threshold (older sources say GBP 20 ex VAT, unconfirmed). | Estimate.
RS UK | Antennas, coax, stands | Amphenol RF N socket to BNC plug adapter (at the rack BNC, one per wing) | NF-BM-NT3G-50 | 2 | 8.4 | 16.8 | 3.36 | quoted | https://uk.rs-online.com/web/c/?searchTerm=285-6398 | 2026-11-01 | yes | 0 | Joins each coax to the rack BNC. Replaces the L-com LCCA30301-FT1.5 jumper (GBP 37.09 each): 0.1 dB instead of ~0.2 dB plus a mated pair (rack PR #126). | RS UK 285-6398, ex VAT, from a search snippet 2026-11-01 (rack PR #126); stock not seen.
RS UK | Bench kit | Rigol DS1054Z 50 MHz 4-channel oscilloscope | DS1054Z | 1 | 310.0 | 310.0 | 62.0 | estimated | https://uk.rs-online.com/web/c/?searchTerm=DS1054Z |  | optional | 0 | Optional: preamp step into 10 nF, start-up transient, boost ripple, P48/hot-plug transients. The PPK2 and logic analyser do not see analogue waveforms. | Optional. Estimate; skip if the owner already has a scope.
RS UK | Mechanical and cells | Protected 18650 Li-ion cell, button top, ~3000 mAh | 18650 protected | 6 | 7.0 | 42.0 | 8.4 | estimated | https://uk.rs-online.com/web/c/?searchTerm=protected+18650 |  | yes | 0 | PK-6: one removable protected 18650 per pack, no on-board charging. 4 + 2 spares for bench and failure. | Estimate, NOT sourced. Must be PROTECTED and button-top. RS UK shipping of cells unconfirmed. Tried 2026-11-01: Nkon (403), 18650.UK (TLS error), Fogstar (only a sold-out unprotected 2500 mAh cell, GBP 6.49, on page 1 of 3), Digi-Key UK (no cells in the search). Next: Fogstar or 18650.UK by hand, Nkon by courier.
RS UK | Mechanical and cells | Silicone hookup wire 24 AWG, 5 m red/black | 24AWG silicone | 1 | 5.0 | 5.0 | 1.0 | estimated | https://uk.rs-online.com/web/c/?searchTerm=24AWG+silicone+wire |  | yes | 0 | Cell leads (2 x 60 mm per pack) and the 31 mm whip wire. | Estimate.
RS UK | Mechanical and cells | M2 brass heat-set inserts, pack of 50 | M2 heat-set insert | 1 | 7.0 | 7.0 | 1.4 | estimated | https://uk.rs-online.com/web/c/?searchTerm=M2+heat+set+insert |  | yes | 0 | Clip screws into 7 mm bosses (ADR-0008), two per pack plus spares. | Estimate.
RS UK | Mechanical and cells | M2 x 6 pan-head thread-forming screws, pack of 100 | M2x6 PT pan | 1 | 6.0 | 6.0 | 1.2 | estimated | https://uk.rs-online.com/web/c/?searchTerm=M2x6+thread+forming |  | yes | 0 | 2 per pack board retention into printed bosses (ADR-0008, pack_uk.csv). | Estimate; replaces the US Fastener Superstore source in pack_uk.csv.
RS UK | Mechanical and cells | Lead-free low-temperature solder paste, 35 g syringe (Chip Quik SMD LTLF) | RS 146-6200 | 1 | 29.37 | 29.37 | 5.87 | quoted | https://uk.rs-online.com/web/p/solder-pastes/1466200 | 2026-11-01 | yes | 0 | Bare PCBs plus stencil, assembly waits for bench results (ADR-0019); hot-plate reflow. 8 boards of about 70-95 parts each; 35 g replaces 2 x 10 g. | SEARCH-RESULT SNIPPET 2026-11-01: GBP 29.37 ex VAT (35.24 inc); product page returned 403. Stock not seen. Farnell UK SMDLTLFP10T5 (10 g) found no price. Reflow hot plate/oven is not listed: if the owner has none, add a hot plate (about GBP 40).
RS UK | Rack | Taoglas CAB.6012 U.FL-U.FL 1.13 mm jumper 100 mm | CAB.6012 | 16 | 1.02 | 16.32 | 3.26 | quoted | https://uk.rs-online.com/web/c/?searchTerm=069-0832 | 2026-11-01 | yes | 0 | Main-board RF port to each receiver J3/J4 (8 slots x 2); the ports sit right behind each receiver (0.3 dB + 2 mated pairs). All 16 are bought although 4 slots are used, as in #126. | RS UK 069-0832, read by the coordinator 2026-11-01; stock unconfirmed. Alternative LCSC C7541876 (Kinghelm).
RS UK | Rack | Cat6 patch lead 0.3 m (NE8FDP to CM4IO RJ45) | Cat6 0.3 m | 1 | 2.0 | 2.0 | 0.4 | estimated | https://uk.rs-online.com/web/c/?searchTerm=cat6+patch+0.3m |  | yes | 0 | Panel RJ45 to the CM4IO. | Estimate (rack PR #126); RS UK or Farnell UK.
RS UK | Rack | M2.5 x 10 mm F-F spacer + screws (CM4IO above the main board) | M2.5x10 spacer set | 4 | 0.3 | 1.2 | 0.24 | estimated | https://uk.rs-online.com/web/c/?searchTerm=M2.5+10mm+spacer |  | yes | 0 | CM4IO standoffs. | Estimate (rack PR #126).
RS UK | Rack | M3 x 11 mm F-F hex spacer + 2 x M3 x 6 screws (receiver mounts, 2 per slot) | M3x11 spacer set | 16 | 0.3 | 4.8 | 0.96 | estimated | https://uk.rs-online.com/web/c/?searchTerm=M3+11mm+hex+spacer |  | yes | 0 | Receiver mounts H1/H2 in each of 8 slots. | Estimate (brass class price; rack PR #126).
RS UK | Rack | M3 x 5 mm F-F spacer + screws (main board to the case floor, 8 holes) | M3x5 spacer set | 8 | 0.25 | 2.0 | 0.4 | estimated | https://uk.rs-online.com/web/c/?searchTerm=M3+5mm+spacer |  | yes | 0 | Main-board mounting. | Estimate (rack PR #126).
RS UK | Shipping | Delivery | - | 1 | 0.0 | 0.0 | 0.0 | estimated | https://uk.rs-online.com |  | yes | 0 | Free over GBP 50 ex VAT (pack-parts-uk-draft.md); basket is above it. | Estimate.
LCSC | Packs x4 | BWIPX1-SMA-1.13L150 | BWIPX1-SMA-1.13L150 | 5 | 0.6247 | 3.12 | 0.62 | quoted | https://www.lcsc.com/product-detail/C784404.html | 2026-11-01 | yes | 0 | Needed 4 (pack x1; refs -), +1 spare | BAT Wireless IPEX-SMA 1.13 mm 150 mm, SMA cut off, ~100 mm kept + 31 mm 0.9 mm wire whip (est. $0.03); qty4 uses the @10 tier $0.7883; converted at 1.31
LCSC | Packs x4 | MY-18650-04-J/05-J | MY-18650-04-J/05-J | 5 | 0.2 | 1.0 | 0.2 | quoted | https://www.lcsc.com/product-detail/C19184125.html | 2026-11-01 | yes | 0 | Needed 4 (pack x1; refs BT1), +1 spare | MYOUNG MY-18650-04-J (C19184125, + plate) + MY-18650-05-J (C19184124, - spring) for the printed cradle; USD 0.1481+0.1084 @5, 0.1181+0.1084 @100, converted at 1.31; ex VAT, VAT at LCSC checkout
LCSC | Packs x4 + Receivers x4 + Rack | C_100n_0402 | C_100n_0402 | 134 | 0.02 | 2.68 | 0.54 | estimated | https://www.lcsc.com/search?q=C_100n_0402 |  | yes | 0 | Needed 107 (pack x8; rx x12; rack; refs C2 C8 C11 C12 C23 C31 C33 C35 C36 C44 C4), +27 spare | rx price from hw/rx/out/bom.csv (est.)
LCSC | Packs x4 + Receivers x4 + Rack | C_10u_0603_X5R | C_10u_0603_X5R | 79 | 0.05 | 3.95 | 0.79 | estimated | https://www.lcsc.com/search?q=C_10u_0603_X5R |  | yes | 0 | Needed 63 (pack x8; rx x7; rack; refs C1 C4 C6 C10 C30 C32 C34), +16 spare | rx price from hw/rx/out/bom.csv (est. (10 uF 10 V 0603 X5R))
LCSC | Packs x4 + Receivers x4 + Rack | C_1u_0402 | C_1u_0402 | 69 | 0.02 | 1.38 | 0.28 | estimated | https://www.lcsc.com/search?q=C_1u_0402 |  | yes | 0 | Needed 55 (pack x6; rx x2; rack; refs C3 C5), +14 spare | rx price from hw/rx/out/bom.csv (est.)
LCSC | Packs x4 + Receivers x4 + Rack | R_0402_1% | R_0402_1% | 360 | 0.02 | 7.2 | 1.44 | estimated | https://www.lcsc.com/search?q=R_0402_1% |  | yes | 0 | Needed 288 (pack x20; rx x3; rx x6; rx x9; rx x5; rx x1; rx x1; rx x1; rx x2; rx x2; rx x1; rx x1; rack; refs R20 R31 R32), +72 spare | rx price from hw/rx/out/bom.csv (est.)
LCSC | Rack | 0451004.MRL | 0451004.MRL | 2 | 0.9 | 1.8 | 0.36 | estimated | https://www.lcsc.com/search?q=0451004.MRL |  | yes | 0 | Needed 1 (rack; refs 0451004.MRL), +1 spare | rack price from hw/rack/prices.py (est. (Littelfuse Nano2 451 4 A fast 125 V, 2410 case 6.1 x 2.5 mm, LCSC C27515 (LCSC record read 2026-11-01); footprint Fuse_Littelfuse-NANO2-451_453 = the 2410 land))
LCSC | Rack | 2.54-2*13PFemale | 2.54-2*13PFemale | 9 | 0.17 | 1.53 | 0.31 | estimated | https://www.lcsc.com/search?q=2.54-2*13PFemale |  | yes | 0 | Needed 8 (rack; refs 2.54-2*13PFemale), +1 spare | rack price from hw/rack/prices.py (est. (BOOMELE 2x13 2.54 mm female 8.5 mm, LCSC C64320, USD 0.2225, JLC parts record 2026-11-01 (stock unconfirmed)); contact 14 pulled and the cavity plugged at assembly: the footprint has no hole at 14 (A
LCSC | Rack | 2.54-2*20P | 2.54-2*20P | 2 | 0.1 | 0.2 | 0.04 | estimated | https://www.lcsc.com/search?q=2.54-2*20P |  | yes | 0 | Needed 1 (rack; refs 2.54-2*20P), +1 spare | rack price from hw/rack/prices.py (est. (BOOMELE 2x20 2.54 mm IDC header, LCSC C9138, LCSC record read 2026-11-01))
LCSC | Rack | AO4407A | AO4407A | 2 | 0.25 | 0.5 | 0.1 | estimated | https://www.lcsc.com/search?q=AO4407A |  | yes | 0 | Needed 1 (rack; refs AO4407A), +1 spare | rack price from hw/rack/prices.py (est. (Alpha & Omega -30 V 12 A P-FET SO-8; DMP3013SFV-7 is 0-stock at DigiKey UK))
LCSC | Rack | B2P-VH | B2P-VH | 2 | 0.15 | 0.3 | 0.06 | estimated | https://www.lcsc.com/search?q=B2P-VH |  | yes | 0 | Needed 1 (rack; refs B2P-VH), +1 spare | rack price from hw/rack/prices.py (est. (JST B2P-VH 2-pin 3.96 mm header, CM4IO 12 V feed; LCSC C160315))
LCSC | Rack | BZT52C12 | BZT52C12 | 2 | 0.03 | 0.06 | 0.01 | estimated | https://www.lcsc.com/search?q=BZT52C12 |  | yes | 0 | Needed 1 (rack; refs BZT52C12), +1 spare | rack price from hw/rack/prices.py (est. (12 V zener SOD-123))
LCSC | Rack | CM4IO 12 V pigtail: JST VH 2-pin housing to 2.1 mm DC plug, 200 mm | CM4IO-12V-pigtail | 1 | 3.0 | 3.0 | 0.6 | estimated | https://www.lcsc.com/search?q=JST+VH+2+pin+housing |  | yes | 0 | Feeds the CM4IO from the main board J5. | Estimate (rack PR #126); LCSC or RS UK.
LCSC | Rack | CS0603-39NJ-S | CS0603-39NJ-S | 3 | 0.02 | 0.06 | 0.01 | estimated | https://www.lcsc.com/search?q=CS0603-39NJ-S |  | yes | 0 | Needed 2 (rack; refs CS0603-39NJ-S), +1 spare | rack price from hw/rack/prices.py (est. (Chilisin 39 nH 5 % 0603, SRF 2.2 GHz, Q 40, 600 mA, DCR 0.25 ohm; LCSC C142171, LCSC record read 2026-11-01))
LCSC | Rack | C_10n_0402 | C_10n_0402 | 12 | 0.02 | 0.24 | 0.05 | estimated | https://www.lcsc.com/search?q=C_10n_0402 |  | yes | 0 | Needed 2 (rack; refs C_10n_0402), +10 spare | rack price from hw/rack/prices.py (est.)
LCSC | Rack | C_22n_0402 | C_22n_0402 | 30 | 0.02 | 0.6 | 0.12 | estimated | https://www.lcsc.com/search?q=C_22n_0402 |  | yes | 0 | Needed 20 (rack; refs C_22n_0402), +10 spare | rack price from hw/rack/prices.py (est.)
LCSC | Rack | C_22u_1206_25V_X5R | C_22u_1206_25V_X5R | 12 | 0.1 | 1.2 | 0.24 | estimated | https://www.lcsc.com/search?q=C_22u_1206_25V_X5R |  | yes | 0 | Needed 2 (rack; refs C_22u_1206_25V_X5R), +10 spare | rack price from hw/rack/prices.py (est.)
LCSC | Rack | C_33n_0402 | C_33n_0402 | 11 | 0.02 | 0.22 | 0.04 | estimated | https://www.lcsc.com/search?q=C_33n_0402 |  | yes | 0 | Needed 1 (rack; refs C_33n_0402), +10 spare | rack price from hw/rack/prices.py (est.)
LCSC | Rack | C_33p_0402_C0G | C_33p_0402_C0G | 14 | 0.02 | 0.28 | 0.06 | estimated | https://www.lcsc.com/search?q=C_33p_0402_C0G |  | yes | 0 | Needed 4 (rack; refs C_33p_0402_C0G), +10 spare | rack price from hw/rack/prices.py (est.)
LCSC | Rack | FB_0603_600R | FB_0603_600R | 3 | 0.03 | 0.09 | 0.02 | estimated | https://www.lcsc.com/search?q=FB_0603_600R |  | yes | 0 | Needed 2 (rack; refs FB_0603_600R), +1 spare | rack price from hw/rack/prices.py (est. (Murata BLM18KG601SN1D 600 ohm 1.3 A 0603; LCSC C85833))
LCSC | Rack | LTST-S270KGKT | LTST-S270KGKT | 9 | 0.03 | 0.27 | 0.05 | estimated | https://www.lcsc.com/search?q=LTST-S270KGKT |  | yes | 0 | Needed 8 (rack; refs LTST-S270KGKT), +1 spare | rack price from hw/rack/prices.py (est. (Lite-On side-looking green, LCSC C125113, USD 0.042, JLC parts record 2026-11-01 (stock unconfirmed)))
LCSC | Rack | LTST-S270KRKT | LTST-S270KRKT | 9 | 0.03 | 0.27 | 0.05 | estimated | https://www.lcsc.com/search?q=LTST-S270KRKT |  | yes | 0 | Needed 8 (rack; refs LTST-S270KRKT), +1 spare | rack price from hw/rack/prices.py (est. (Lite-On side-looking red, LCSC C125114, USD 0.032, JLC parts record 2026-11-01 (stock unconfirmed)))
LCSC | Rack | R_0402_0R | R_0402_0R | 13 | 0.01 | 0.13 | 0.03 | estimated | https://www.lcsc.com/search?q=R_0402_0R |  | yes | 0 | Needed 3 (rack; refs R_0402_0R), +10 spare | rack price from hw/rack/prices.py (est.)
LCSC | Rack | R_0402_100R_TF | R_0402_100R_TF | 24 | 0.08 | 1.92 | 0.38 | estimated | https://www.lcsc.com/search?q=R_0402_100R_TF |  | yes | 0 | Needed 14 (rack; refs R_0402_100R_TF), +10 spare | rack price from hw/rack/prices.py (est. (100 ohm 0402 thin film, Wilkinson isolation))
LCSC | Rack | R_2512_1R_1W | R_2512_1R_1W | 12 | 0.1 | 1.2 | 0.24 | estimated | https://www.lcsc.com/search?q=R_2512_1R_1W |  | yes | 0 | Needed 2 (rack; refs R_2512_1R_1W), +10 spare | rack price from hw/rack/prices.py (est. (1 ohm 1 % 2512 1 W thick film))
LCSC | Rack | SDWL1005C18NGSTF | SDWL1005C18NGSTF | 3 | 0.02 | 0.06 | 0.01 | estimated | https://www.lcsc.com/search?q=SDWL1005C18NGSTF |  | yes | 0 | Needed 2 (rack; refs SDWL1005C18NGSTF), +1 spare | rack price from hw/rack/prices.py (est. (Sunlord 18 nH 2 % 0402, SRF 4.5 GHz; LCSC C361616, LCSC record read 2026-11-01))
LCSC | Rack | SMF12A | SMF12A | 3 | 0.08 | 0.24 | 0.05 | estimated | https://www.lcsc.com/search?q=SMF12A |  | yes | 0 | Needed 2 (rack; refs SMF12A), +1 spare | rack price from hw/rack/prices.py (est. (SMF 200 W TVS SOD-123F))
LCSC | Rack | XC32M4-14.7456-F20NLDTL | XC32M4-14.7456-F20NLDTL | 3 | 0.06 | 0.18 | 0.04 | estimated | https://www.lcsc.com/search?q=XC32M4-14.7456-F20NLDTL |  | yes | 0 | Needed 2 (rack; refs XC32M4-14.7456-F20NLDTL), +1 spare | rack price from hw/rack/prices.py (LCSC C3034317 read via the JLC parts API: HCI 14.7456 MHz 3225 20 pF, ESR 60 ohm, -40..+85 C, 10 ppm (LCSC C3034317, USD 0.0814, JLC parts record read 2026-11-01, 6,684 in stock; #126 review: replaces the
LCSC | Receivers x4 | ALU_22u_25V | ALU_22u_25V | 18 | 0.05 | 0.9 | 0.18 | estimated | https://www.lcsc.com/search?q=ALU_22u_25V |  | yes | 0 | Needed 8 (rx x2; refs C43 C49), +10 spare | rx price from hw/rx/out/bom.csv (est. (22 uF 25 V SMD aluminium, 5 mm))
LCSC | Receivers x4 | ALU_47u_25V | ALU_47u_25V | 18 | 0.06 | 1.08 | 0.22 | estimated | https://www.lcsc.com/search?q=ALU_47u_25V |  | yes | 0 | Needed 8 (rx x2; refs C9 C40), +10 spare | rx price from hw/rx/out/bom.csv (est. (47 uF 25 V SMD aluminium, 5 mm))
LCSC | Receivers x4 | BAT54,215 | BAT54,215 | 13 | 0.02 | 0.26 | 0.05 | estimated | https://www.lcsc.com/search?q=BAT54,215 |  | yes | 0 | Needed 12 (rx x3; refs D8 D9 D10), +1 spare | rx price from hw/rx/out/bom.csv (est. (Nexperia BAT54 SOT-23, q100))
LCSC | Receivers x4 | BSS138 | BSS138 | 5 | 0.04 | 0.2 | 0.04 | estimated | https://www.lcsc.com/search?q=BSS138 |  | yes | 0 | Needed 4 (rx x1; refs Q1), +1 spare | rx price from hw/rx/out/bom.csv (est. (onsemi BSS138 SOT-23, q100))
LCSC | Receivers x4 | C_10p_0402_C0G | C_10p_0402_C0G | 22 | 0.02 | 0.44 | 0.09 | estimated | https://www.lcsc.com/search?q=C_10p_0402_C0G |  | yes | 0 | Needed 12 (rx x3; refs C20 C21 C22), +10 spare | rx price from hw/rx/out/bom.csv (est.)
LCSC | Receivers x4 | C_1n_0402 | C_1n_0402 | 14 | 0.02 | 0.28 | 0.06 | estimated | https://www.lcsc.com/search?q=C_1n_0402 |  | yes | 0 | Needed 4 (rx x1; refs C60), +10 spare | rx price from hw/rx/out/bom.csv (est.)
LCSC | Receivers x4 | C_2n2_0402_C0G | C_2n2_0402_C0G | 14 | 0.02 | 0.28 | 0.06 | estimated | https://www.lcsc.com/search?q=C_2n2_0402_C0G |  | yes | 0 | Needed 4 (rx x1; refs C39), +10 spare | rx price from hw/rx/out/bom.csv (est.)
LCSC | Receivers x4 | C_2u2_0603_X7R | C_2u2_0603_X7R | 18 | 0.02 | 0.36 | 0.07 | estimated | https://www.lcsc.com/search?q=C_2u2_0603_X7R |  | yes | 0 | Needed 8 (rx x2; refs C37 C38), +10 spare | rx price from hw/rx/out/bom.csv (est.)
LCSC | Receivers x4 | PE4259-63 | PE4259-63 | 5 | 0.4 | 2.0 | 0.4 | estimated | https://www.lcsc.com/search?q=PE4259-63 |  | yes | 0 | Needed 4 (rx x1; refs U2), +1 spare | rx price from hw/rx/out/bom.csv (LCSC C470892 qty-100, via findchips.com/LCSC snapshot read 2026-10-31 (range $0.32-0.49)); x1.3 on the qty-100 figure for a 4-board order
LCSC | Receivers x4 | PZ254V-12-26P | PZ254V-12-26P | 5 | 0.39 | 1.95 | 0.39 | estimated | https://www.lcsc.com/search?q=PZ254V-12-26P |  | yes | 0 | Needed 4 (rx x1; refs J1), +1 spare | rx price from hw/rx/out/bom.csv (est. (XFCN 2x13 2.54 mm THT header, LCSC C22465887, 2401 in stock at JLC 2026-11-01; pin 14 cut for the key; mates the Harwin M20-7831346 socket + M20-003 key in position 14 on the main board, ADR-0018)); x1
LCSC | Receivers x4 | R_0603_1% | R_0603_1% | 30 | 0.02 | 0.6 | 0.12 | estimated | https://www.lcsc.com/search?q=R_0603_1% |  | yes | 0 | Needed 20 (rx x1; rx x4; refs R1), +10 spare | rx price from hw/rx/out/bom.csv (est.)
LCSC | Receivers x4 | S1J | S1J | 21 | 0.03 | 0.63 | 0.13 | estimated | https://www.lcsc.com/search?q=S1J |  | yes | 0 | Needed 20 (rx x5; refs D3 D4 D5 D6 D7), +1 spare | rx price from hw/rx/out/bom.csv (est. (S1J 1 A 600 V SMA, IFSM 30 A, q100))
LCSC | Receivers x4 | SMF15A | SMF15A | 5 | 0.08 | 0.4 | 0.08 | estimated | https://www.lcsc.com/search?q=SMF15A |  | yes | 0 | Needed 4 (rx x1; refs D1), +1 spare | rx price from hw/rx/out/bom.csv (est. (SMF 200 W TVS SOD-123F, q100))
LCSC | Receivers x4 | SMF5.0A | SMF5.0A | 5 | 0.08 | 0.4 | 0.08 | estimated | https://www.lcsc.com/search?q=SMF5.0A |  | yes | 0 | Needed 4 (rx x1; refs D2), +1 spare | rx price from hw/rx/out/bom.csv (est. (SMF 200 W TVS SOD-123F, q100))
LCSC | Receivers x4 | U.FL-U.FL-50MM | U.FL-U.FL-50MM | 4 | 1.48 | 5.92 | 1.18 | estimated | https://www.lcsc.com/search?q=U.FL-U.FL-50MM |  | yes | 0 | Needed 4 (rx x1) | rx price from hw/rx/out/bom.csv (est.); x1.3 on the qty-100 figure for a 4-board order
LCSC | Receivers x4 + Rack | ALU_100u_25V | ALU_100u_25V | 16 | 0.08 | 1.28 | 0.26 | estimated | https://www.lcsc.com/search?q=ALU_100u_25V |  | yes | 0 | Needed 6 (rx x1; rack; refs C7), +10 spare | rx price from hw/rx/out/bom.csv (est. (100 uF 25 V SMD aluminium, 6.3 mm))
LCSC | Receivers x4 + Rack | C_100p_0402_C0G | C_100p_0402_C0G | 28 | 0.02 | 0.56 | 0.11 | estimated | https://www.lcsc.com/search?q=C_100p_0402_C0G |  | yes | 0 | Needed 18 (rx x2; rack; refs C41 C42), +10 spare | rx price from hw/rx/out/bom.csv (est.)
LCSC | Receivers x4 + Rack | C_10u_1206_25V_X7R | C_10u_1206_25V_X7R | 17 | 0.09 | 1.53 | 0.31 | estimated | https://www.lcsc.com/search?q=C_10u_1206_25V_X7R |  | yes | 0 | Needed 7 (rx x1; rack; refs C46), +10 spare | rx price from hw/rx/out/bom.csv (est. (10 uF 25 V 1206 X7R))
LCSC | Receivers x4 + Rack | U.FL-R-SMT-1(10) | U.FL-R-SMT-1(10) | 29 | 0.34 | 9.86 | 1.97 | estimated | https://www.lcsc.com/search?q=U.FL-R-SMT-1(10) |  | yes | 0 | Needed 28 (rx x1; rx x1; rx x1; rack; refs U.FL-R-SMT-1(10)), +1 spare | rack price from hw/rack/prices.py (est. (Hirose U.FL-R-SMT-1(10), LCSC C88373 (not C88374)))
LCSC | Shipping | Shipping to the UK (courier) + import VAT at checkout | - | 1 | 12.0 | 12.0 | 2.4 | estimated | https://www.lcsc.com |  | yes | 0 | LCSC to UK is a worldwide courier. Order is under GBP 135, so VAT (20 %) is collected at checkout and there is no duty. | Estimate; UK shipping option not confirmed (LCSC page unreadable per pack-parts-uk-draft.md).
JLCPCB | PCB fabrication | Pack stencil, top side only, frameless | pack stencil | 1 | 8.0 | 8.0 | 1.6 | estimated | https://cart.jlcpcb.com/quote |  | yes | 0 | All 70 pack parts are on Top (cpl_jlc.csv), one stencil. | Estimate.
JLCPCB | PCB fabrication | Pack PCB, 4-layer, 73.5 x 35.1 mm, 1.6 mm, ENIG, 10 pcs | pack.kicad_pcb | 1 | 28.0 | 28.0 | 5.6 | estimated | https://cart.jlcpcb.com/quote |  | yes | 0 | 4 packs plus 6 spares so a re-spin or a bad solder job costs boards, not a new order (ADR-0019). Size/layers from hw/pack/out/fab/pack-job.gbrjob. | Estimate; JLCPCB quote page is dynamic and was not readable 2026-11-01. Only published datum: 4-layer board charge USD 70.6/m2 (Mar 2024 news), which makes the board area itself under GBP 1; the rest is engineering fee, ENIG and shipping. Gerbers: hw/pack/out/fab/gerber. No JLC assembly is assumed (ADR-0019: hand/hot-plate reflow).
JLCPCB | PCB fabrication | Receiver stencil, top side only, frameless | rx stencil | 1 | 8.0 | 8.0 | 1.6 | estimated | https://cart.jlcpcb.com/quote |  | yes | 0 | All 95 receiver parts are on Top, one stencil. | Estimate.
JLCPCB | PCB fabrication | Receiver sub-board PCB, 4-layer, 48.1 x 90.1 mm, 1.6 mm, ENIG, 10 pcs | rx.kicad_pcb | 1 | 36.0 | 36.0 | 7.2 | estimated | https://cart.jlcpcb.com/quote |  | yes | 0 | 4 receivers plus 6 spares (50 ohm RF traces, 4-layer). Size/layers from hw/rx/out/fab/rx-job.gbrjob. | Estimate; 5 pcs would do for 4 boards but 10 costs little more. Gerbers: hw/rx/out/fab/gerber.
JLCPCB | Rack | Rack main board, full JLCPCB order: 5 x 4-layer 412 x 321.5 mm ENIG boards, large framed stencil, extended-part fees, DHL ~2 kg, UK import VAT and handling | rack.kicad_pcb | 1 | 300.0 | 300.0 | 60.0 | estimated | https://cart.jlcpcb.com/quote |  | yes | 0 | The rack main board (hw/rack/out/fab). One board is used, four are spares (5 is JLC's minimum). | ESTIMATE: reviewer's range GBP 250-350 for the whole order, mid value; the JLC quote page needs a browser, so quote before ordering. The figure already includes DHL and UK import VAT, so the VAT column here slightly overstates. Own order: the shipping line above is for the pack and receiver boards.
JLCPCB | Shipping | Shipping to the UK (DHL) + import VAT at checkout | - | 1 | 16.0 | 16.0 | 3.2 | estimated | https://cart.jlcpcb.com/quote |  | yes | 0 | JLCPCB collects UK VAT (20 %) at checkout; no duty under GBP 135. | Estimate.
ITM Components | Antennas, coax, stands | L-com CA3N030 400-series coax N-male/N-male 9.14 m (30 ft): rack to near wing | CA3N030 | 1 | 45.8 | 45.8 | 9.16 | quoted | https://www.itm.com | 2026-11-01 | yes | 0 | Rack to near-wing boom, owner decision (#126 choice, RK-7h). | Owner-given ITM price GBP 45.80 ex VAT, one per rack.
ITM Components | Antennas, coax, stands | L-com CA3N075 400-series coax N-male/N-male 22.86 m (75 ft): rack to far wing | CA3N075 | 1 | 88.02 | 88.02 | 17.6 | quoted | https://www.itm.com | 2026-11-01 | yes | 0 | Rack to far-wing boom (12 m stage). A 30 ft lead does not reach the far wing (design-log RK-7h; audit.py Audit 5 needs 13.6 m on a 6 x 6 m venue). 7.65 dB at 100 ft is the longest the wing noise figure allows. | ITM Components UK, ex VAT, read 2026-11-01 (rack PR #126, hw/rack/prices.py ANTENNA_KIT).
ITM Components | Antennas, coax, stands | L-com HyperLink 2.4 GHz 8 dBi flat patch, N-female | HG2409P-NF | 2 | 72.12 | 144.24 | 28.85 | quoted | https://www.itm.com | 2026-11-01 | yes | 0 | One per wing (ADR-0021); R1 antenna. | Price from ADR-0016 (ITM Components UK). Assumed ex VAT (ITM lists ex VAT by default); ADR does not state the basis.
ITM Components | Antennas, coax, stands | L-com HGX-PMT07 pole mount bracket for HG2409P | HGX-PMT07 | 2 | 14.45 | 28.9 | 5.78 | quoted | https://www.itm.com | 2026-11-01 | yes | 0 | Holds each panel on the stand pole at 4 m, tilted 10 deg down (ADR-0021). | Owner-given ITM price ex VAT.
ITM Components | Shipping | Delivery (antennas and coax) | - | 1 | 10.0 | 10.0 | 2.0 | estimated | https://www.itm.com |  | yes | 0 | Coax drums are heavy. | Estimate.
Simply Sound & Lighting | Antennas, coax, stands | Thor winch-up lighting stand | LS003 | 2 | 140.83 | 281.66 | 56.33 | quoted | https://www.simplysoundandlighting.co.uk | 2026-11-01 | yes | 2 | 4 m mounting height in each wing where the venue has no boom (ADR-0021; install doc step 3). | Owner-given ~GBP 140.83 ex VAT each. Large item: delivery is a separate line (estimated). OPTIONAL CUT: the venue's own lighting stands or booms may serve (the HGX-PMT07 U-bolt mounts stay).
Simply Sound & Lighting | Shipping | Delivery (2 stands) | - | 1 | 30.0 | 30.0 | 6.0 | estimated | https://www.simplysoundandlighting.co.uk |  | yes | 1 | Stands are about 10 kg each. | Estimate. Goes with the stands if they are cut.
Rapid Online | Rack | Hammond RM1U1913SBK 1U 19 in aluminium case, 330 mm deep | RM1U1913SBK | 1 | 140.76 | 140.76 | 28.15 | quoted | https://www.rapidonline.com | 2026-11-01 | yes | 0 | Rack chassis (mech/rack.py; panels drilled per hw/rack/mech/out). | Rapid Online 31-1555, read by the coordinator 2026-11-01, in stock; DigiKey UK HM996-ND GBP 142.98 (90 in stock).
Rapid Online | Shipping | Delivery (1U case, about 4 kg) | - | 1 | 6.0 | 6.0 | 1.2 | estimated | https://www.rapidonline.com |  | yes | 0 | Rapid UK delivery charge not read. | Estimate.
The Pi Hut | Bench kit | Dupont jumper wires F-F 20 cm (40-pack) | Dupont F-F 40 | 2 | 2.5 | 5.0 | 1.0 | estimated | https://thepihut.com |  | yes | 0 | Logic analyser probes to DK pins and board test pads (TP1-TP13 on the receiver). | Estimate.
The Pi Hut | Bench kit | Micro-USB cable 1 m (DK, PPK2, programming) | USB-A to micro-B 1 m | 3 | 2.5 | 7.5 | 1.5 | estimated | https://thepihut.com |  | yes | 0 | Powers/connects 2 DKs and the PPK2. | Estimate.
The Pi Hut | Rack | Panel-mount USB-C socket to micro-B plug 30 cm, M3 ears 20 mm apart (Adafruit 4056) | Adafruit 4056 | 1 | 3.83 | 3.83 | 0.77 | quoted | https://thepihut.com | 2026-11-01 | yes | 0 | CM4IO rpiboot port on the front panel (RK-1); no CC resistors, so service with a USB-A-to-C lead. | The Pi Hut UK SKU 103462, GBP 4.60 inc VAT, read 2026-11-01; SOLD OUT that day (Adafruit direct USD 4.95). Order may wait.
The Pi Hut | Rack | Raspberry Pi CM4 2 GB RAM / 8 GB eMMC, no wireless (SC0680 = CM4002008) | CM4002008 | 1 | 79.2 | 79.2 | 15.84 | quoted | https://thepihut.com | 2026-11-01 | yes | 0 | Rack host (ADR-0018). SC0681 (16 GB eMMC) at the same price is the drop-in alternative. | The Pi Hut UK qty 1, 2026-11-01 (coordinator decision on #95; DigiKey UK SC0680 was 0 stock at GBP 61.64).
The Pi Hut | Shipping | Delivery | - | 1 | 3.5 | 3.5 | 0.7 | estimated | https://thepihut.com |  | yes | 0 | Standard. | Estimate.
Thomann | Bench kit | Lavalier microphone, 3.5 mm TRS, omni electret | Samson LM5 (or equivalent) | 1 | 15.0 | 15.0 | 3.0 | estimated | https://www.thomann.de/gb/samson_lm5.htm |  | yes | 0 | Real source for the preamp/ADC chain on the bench (noise, THD, start-up) and R5 listening checks. | Estimate; Thomann UK site ships to the UK (GBP prices inc VAT at checkout). Final show mic is the owner's choice and out of scope.
Thomann | Bench kit | Cable 3.5 mm TRS to 3.5 mm TRS 1.5 m | TRS-TRS 1.5 m | 1 | 3.5 | 3.5 | 0.7 | estimated | https://www.thomann.de/gb/ |  | yes | 0 | DAC output to the PC sound card / headphone amp during #38. | Estimate.
Thomann | Shipping | Delivery to the UK | - | 1 | 8.0 | 8.0 | 1.6 | estimated | https://www.thomann.de/gb/ |  | yes | 0 | Thomann ships from Germany; UK prices include VAT at checkout. | Estimate.
Lab401 (EU) | Bench kit | tinySA Ultra+ spectrum analyser 100 kHz-5.4 GHz (CE version) | tinySA Ultra+ | 1 | 140.0 | 140.0 | 28.0 | quoted | https://lab401.com/products/tinysa-ultra | 2026-11-01 | yes | 0 | #92 / design-log AN-risk 2: conducted TX power and the 99 % OBW and 2483.5-2487.6 MHz emissions on a pack at 2482 MHz (limit 2.51 MHz OBW). Cheapest adequate; indicative, not a lab EN 300 328 report. | DECISION: no UK stockist found (tinysa.org buy page 404, Technofix not found, eBay 403, Amazon UK not found). Lab401 (France, EU) sells the Ultra+ (the current CE-compliant model; the original Ultra is retired at eleshop.eu), EUR 163.00 on 2026-11-01, in stock for EU, UK is in its country list but UK shipping was not confirmed. GBP 140 = EUR 163 x 0.86 (assumed rate; VAT basis of the EUR price not stated). Delivery line is an estimate. Input max is +10 dBm so the 20 dB attenuator is belt and braces. Fallback: Siglent SSA1015X-class from RS UK (about GBP 700).
Lab401 (EU) | Shipping | Delivery to the UK (courier) + import VAT at the door | - | 1 | 15.0 | 15.0 | 3.0 | estimated | https://lab401.com |  | yes | 0 | EU seller; post-Brexit UK import VAT (20 %) is collected by the courier, unit is under GBP 135. | Estimate; shipping is calculated at checkout.
The Debug Store | Bench kit | Tag-Connect TC2030-IDC-NL cable (2x5 1.27 mm to TC2030 no-legs) | TC2030-IDC-NL | 1 | 46.0 | 46.0 | 9.2 | quoted | https://thedebugstore.com/products/tag-connect-tc2030-idc-nl-cable-uk | 2026-11-01 | yes | 0 | Programs and debugs the pack and receiver boards (both carry TC2030 pads only, no header). Not in either BOM, so a missing item. | UK Tag-Connect stockist. GBP 46.00 ex VAT from the search-result snippet (55.20 inc); the product page read 2026-11-01 showed 42.00 ex VAT and is internally inconsistent, so the higher figure is used. SOLD OUT on the page, dispatch within 10 working days if ordered. Digi-Key UK does not list the -NL cable (only TC2030-IDC with legs, GBP 33.31, 339 in stock, which needs mounting holes the boards lack).
The Debug Store | Shipping | Delivery | - | 1 | 5.0 | 5.0 | 1.0 | estimated | https://thedebugstore.com |  | yes | 0 | UK seller. | Estimate.
Knives and Tools UK | Mechanical and cells | External 18650 charger, 2-bay, USB (Nitecore UI2) | Nitecore UI2 | 1 | 16.63 | 16.63 | 3.33 | quoted | https://knivesandtools.co.uk/en/pt/-nitecore-ui2-battery-charger.htm | 2026-11-01 | yes | 0 | The pack has no charging circuit (PK-6), so cells charge externally. | GBP 19.95 inc VAT on the page 2026-11-01 (16.63 ex; a search snippet showed 15.45), in stock, ships from the Netherlands. LED, no display.
Knives and Tools UK | Shipping | Delivery (fixed rate, from the Netherlands) | - | 1 | 8.29 | 8.29 | 1.66 | quoted | https://knivesandtools.co.uk/en/pt/-nitecore-ui2-battery-charger.htm | 2026-11-01 | yes | 0 | Fixed GBP 9.95 inc VAT for all orders. | Page read 2026-11-01.
123-3D UK | Mechanical and cells | PETG filament 1.75 mm, 1 kg spool (eSun solid grey; enclosures + belt clips) | eSun PETG 1 kg | 1 | 11.67 | 11.67 | 2.33 | quoted | https://www.123-3d.co.uk/eSun-PETG-filament-1-75mm-Solid-Grey-1-kg-i9656.html | 2026-11-01 | yes | 0 | ADR-0008: printed PETG body, clip and cradle on the Bambu A1 mini (assumed owned, not listed). About 30 g per pack; 1 kg covers reprints. | SEARCH-RESULT SNIPPET, 2026-11-01: GBP 14.00 inc, 11.67 ex VAT. The product page returned HTTP 429, stock not confirmed; other 123-3D snippets disagreed (13.33 to 19.96 ex).
123-3D UK | Shipping | Delivery | - | 1 | 4.0 | 4.0 | 0.8 | estimated | https://www.123-3d.co.uk |  | yes | 0 | Standard. | Estimate.
tinySA reseller (UK) | Bench kit | NanoVNA-H4 vector network analyser | NanoVNA-H4 | 1 | 75.0 | 75.0 | 15.0 | estimated | https://nanovna.com |  | optional | 0 | Optional: RF-11 (QPQ1907 loss at band edges), antenna/coax S11, receiver RF chain S2P checks. | Optional. Estimate. UK stockist not confirmed; not searched.
