saturncity/openpack/hw/rack/out/render/top_assembly.png

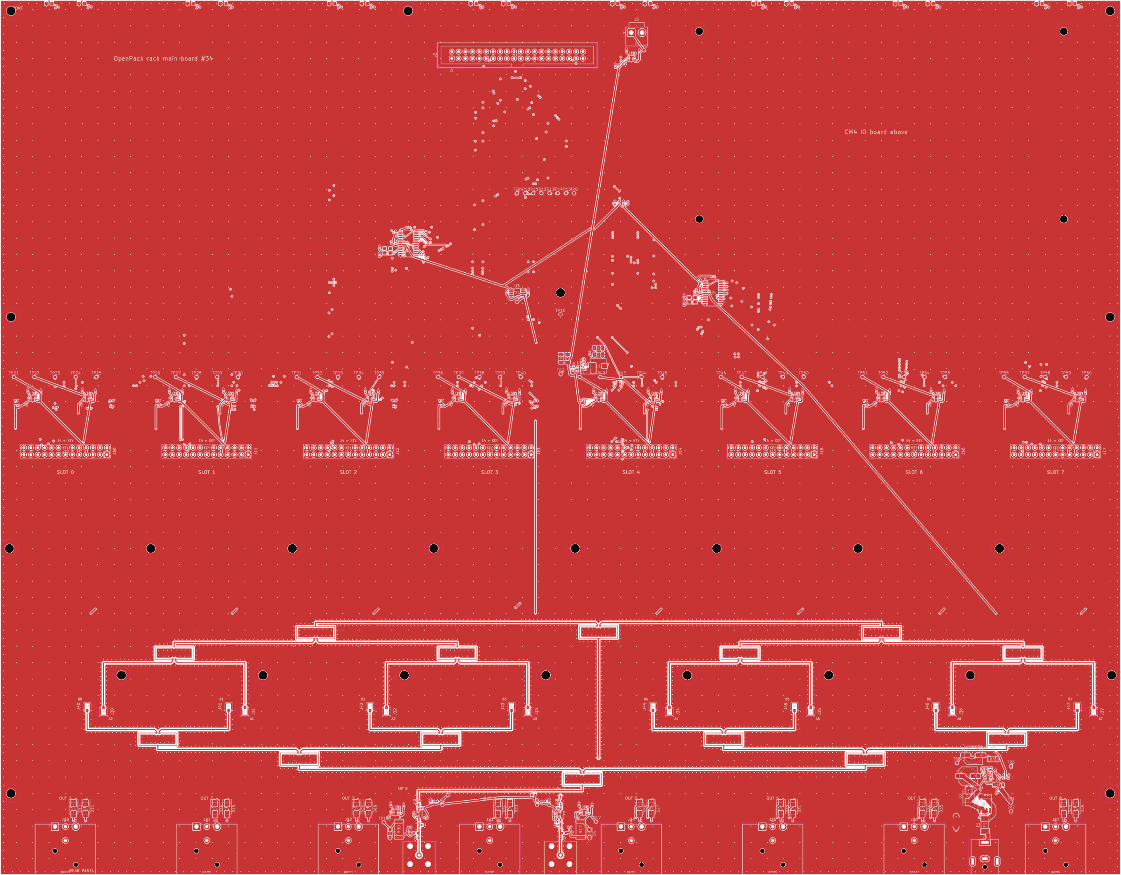
hw/rack/out/render/top_assembly.png
