saturncity/openpack/hw/rx/rx.kicad_pcb

## KiCad design hw/rx/rx.kicad_pcb (2026-11-01)

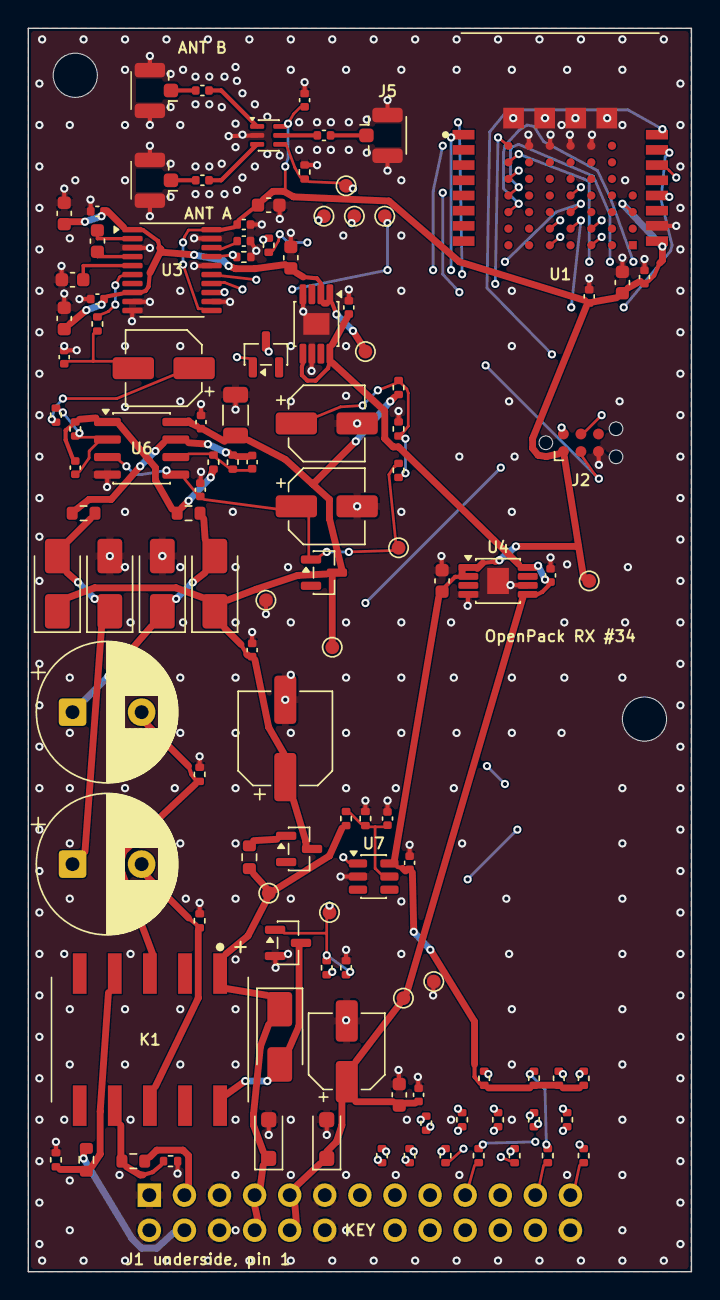
[picture p18: board rx.kicad_pcb from above]

Board: 4 copper layers, 48.0 x 90.0 mm, 117 parts (1 on the bottom side), 67 nets.

Parts:
C1, C4, C6, C10, C30, C32, C34: 10u; C_0603_1608Metric
C2, C8, C11, C12, C23, C31, C33, C35, C36, C44, C45, C61: 100n; C_0402_1005Metric
C3, C5: 1u; C_0402_1005Metric
C7: 100u 25V; CP_Elec_6.3x5.4
C9, C40: 47u 25V; CP_Elec_5x5.4
C20, C21, C22: 10p; C_0402_1005Metric
C37, C38: 2u2; C_0603_1608Metric
C39: 2n2; C_0402_1005Metric
C41, C42: 100p; C_0402_1005Metric
C43, C49: 22u 25V; CP_Elec_5x5.4
C46: 10u; C_1206_3216Metric
C47, C48: 47u 63V BP; CP_Radial_D10.0mm_P5.00mm
C60: 1n; C_0402_1005Metric
D1: SMF15A; D_SOD-123F
D2: SMF5.0A; D_SOD-123F
D3, D4, D5, D6, D7: S1J; D_SMA
D8, D9, D10: BAT54; SOT-23
H1, H2: MountingHole_3.2mm_M3
J1: backplane 2x13; PinHeader_2x13_P2.54mm_Key14
J2: SWD; Tag-Connect_TC2030-IDC-NL_2x03_P1.27mm_Vertical
J3: ANT_A; U.FL_Hirose_U.FL-R-SMT-1_Vertical
J4: ANT_B; U.FL_Hirose_U.FL-R-SMT-1_Vertical
J5: TO_MODULE; U.FL_Hirose_U.FL-R-SMT-1_Vertical
K1: TQ2SA-12V; Panasonic_TQ2SA
Q1: BSS138; SOT-23
R1: 10; R_0603_1608Metric
R20, R31, R32: 100; R_0402_1005Metric
R21, R22, R23, R25, R26, R27: 1k; R_0402_1005Metric
R24, R28, R29, R30, R38, R53, R54, R55, R62: 10k; R_0402_1005Metric
R33, R34, R35: DNP (100); R_0402_1005Metric
R36, R37, R49, R52, R63: 100k; R_0402_1005Metric
R40: 470; R_0402_1005Metric
R41: 2.0k; R_0402_1005Metric
R42: 3.65k; R_0402_1005Metric
R43, R44: 4.99k; R_0402_1005Metric
R45, R46: 22k; R_0402_1005Metric
R47, R48, R50, R51: 22; R_0603_1608Metric
R60: 249k; R_0402_1005Metric
R61: 9.76k; R_0402_1005Metric
TP1: +12V; TestPoint_Pad_D1.0mm
TP2: +12VA; TestPoint_Pad_D1.0mm
TP3: +5V; TestPoint_Pad_D1.0mm
TP4: +3V3; TestPoint_Pad_D1.0mm
TP5: +3V3A; TestPoint_Pad_D1.0mm
TP6, TP7: GND; TestPoint_Pad_D1.0mm
TP8: I2S_BCK; TestPoint_Pad_D1.0mm
TP9: I2S_LRCK; TestPoint_Pad_D1.0mm
TP10: I2S_SDOUT; TestPoint_Pad_D1.0mm
TP11: VCM; TestPoint_Pad_D1.0mm
TP12: ANT_SEL; TestPoint_Pad_D1.0mm
TP13: RLY_G; TestPoint_Pad_D1.0mm
U1: BT40E; Fanstel_BT40E
U2: PE4259; SOT-363_SC-70-6
U3: PCM5102A; TSSOP-20_4.4x6.5mm_P0.65mm
U4, U5: TLV76733; HVSSOP-8-1EP_3x3mm_P0.65mm_EP1.57x1.89mm
U6: OPA1656; SOIC-8_3.9x4.9mm_P1.27mm
U7: TPS3808G01; SOT-23-6

Connections:
+3V3: C4.1, C10.1, C11.1, C12.1, C23.1, C34.1, C35.1, C61.1, J2.1, R24.1, R28.1, R29.1, R30.1, TP4.1, U1.9, U1.F4, U2.6, U3.11, U3.20, U4.1, U4.2, U7.6
+3V3A: C6.1, C30.1, C31.1, C32.1, C33.1, TP5.1, U3.1, U3.8, U5.1, U5.2
+5V: C1.1, C2.1, C3.1, C5.1, C9.1, D2.1, J1.9, J1.10, TP3.1, U4.5, U4.8, U5.5, U5.8
+12V: D1.1, D7.1, J1.7, J1.8, K1.1, R1.1, R60.1, TP1.1
+12VA: C7.1, C8.1, C45.1, C46.1, D5.1, D6.1, D8.3, D9.3, R45.1, TP2.1, U6.8
+12V_R: D9.1, R1.2
ANT_SEL: R36.1, TP12.1, U1.D6, U2.4
AUD_COLD: J1.4, R48.2
AUD_HOT: J1.3, R51.2
BOOT: R23.2, R24.2, U1.1
BP_BOOT: J1.20, R23.1
BP_I2S_BCK: J1.13, R33.2
BP_I2S_LRCK: J1.15, R34.2
BP_I2S_SDOUT: J1.16, R35.2
BP_LED_LOCK: J1.21, R31.2
BP_LED_PEAK: J1.22, R32.2
BP_SLOT0: J1.23, R25.1
BP_SLOT1: J1.24, R26.1
BP_SLOT2: J1.25, R27.1
BP_UART_RX: J1.18, R21.1
BP_UART_TX: J1.17, R20.2
BP_nRESET: J1.19, R22.1
DAC_CAPM: C37.2, U3.4
DAC_CAPP: C37.1, U3.2
DAC_LDOO: C36.1, U3.18
DAC_OUTF: C39.1, C40.2, R40.2
DAC_OUTL: R40.1, U3.6
DAC_VNEG: C38.1, U3.5
DAC_XSMT: D10.1, R37.1, R38.2, U3.17
DRV_CIN: C40.1, R41.1
DRV_COLD_O: K1.4, R48.1, R49.1
DRV_COLD_P: C47.1, D3.1, D5.2, R47.2
DRV_COLD_X: C47.2, K1.3, R54.1
DRV_HOT_O: K1.7, R51.1, R52.1
DRV_HOT_P: C48.1, D4.1, D6.2, R50.2
DRV_HOT_X: C48.2, K1.8, R55.1
DRV_INA: C41.1, R41.2, R42.1, U6.2
DRV_INB: C42.1, R43.2, R44.1, U6.6
DRV_OUTA: C41.2, R42.2, R43.1, R47.1, U6.1
DRV_OUTB: C42.2, R44.2, R50.1, U6.7
GND: C1.2, C2.2, C3.2, C4.2, C5.2, C6.2, C7.2, C8.2, C9.2, C10.2, C11.2, C12.2, C23.2, C30.2, C31.2, C32.2, C33.2, C34.2, C35.2, C36.2, C38.2, C39.2, C43.2, C44.2, C45.2, C46.2, C49.2, C60.2, C61.2, D1.2, D2.2, D3.2, D4.2, J1.1, J1.2, J1.5, J1.6, J1.11, J1.12, J1.26, J2.5, J3.2, J4.2, J5.2, Q1.2, R36.2, R37.2, R46.2, R49.2, R52.2, R54.2, R55.2, R61.2, R63.2, TP6.1, TP7.1, U1.10, U1.A0, U1.B0, U1.C0, U1.D0, U1.H0, U1.H1, U1.H2, U1.H3, U2.2, U3.3, U3.9, U3.10, U3.12, U3.16, U3.19, U4.4, U4.6, U4.9, U5.4, U5.6, U5.9, U6.4, U7.2
I2S_BCK: R33.1, TP8.1, U1.C3, U3.13
I2S_LRCK: R34.1, TP9.1, U1.C4, U3.15
I2S_SDOUT: R35.1, TP10.1, U1.B6, U3.14
LED_LOCK: R31.1, U1.Z0
LED_PEAK: R32.1, U1.Z1
OUT_EN: R62.1, U1.12
RF_A: C20.1, J3.1
RF_B: C21.1, J4.1
RF_OUT: C22.2, J5.1
RLY_COIL: D7.2, K1.10, Q1.3
RLY_G: D10.3, Q1.1, R62.2, R63.1, TP13.1, U7.1
SLOT0: R25.2, R28.2, U1.Z2
SLOT1: R26.2, R29.2, U1.Z3
SLOT2: R27.2, R30.2, U1.Z4
SUP_SENSE: C60.1, R60.2, R61.1, U7.5
SWDCLK: J2.4, U1.15
SWDIO: J2.2, U1.16
SW_RF1: C21.2, U2.1
SW_RF2: C20.2, U2.3
SW_RFC: C22.1, U2.5
UART_RX: R21.2, U1.D5
UART_TX: R20.1, U1.C5
VCM: C44.1, C49.1, D8.1, R53.2, TP11.1, U6.3, U6.5
VCM1: C43.1, R45.2, R46.1, R53.1
XSMT_EN: R38.1, U1.B5
nRESET: J2.3, R22.2, U1.14
