saturncity/openpack/hw/pack/pack.kicad_pcb

## KiCad design hw/pack/pack.kicad_pcb (2026-11-01)

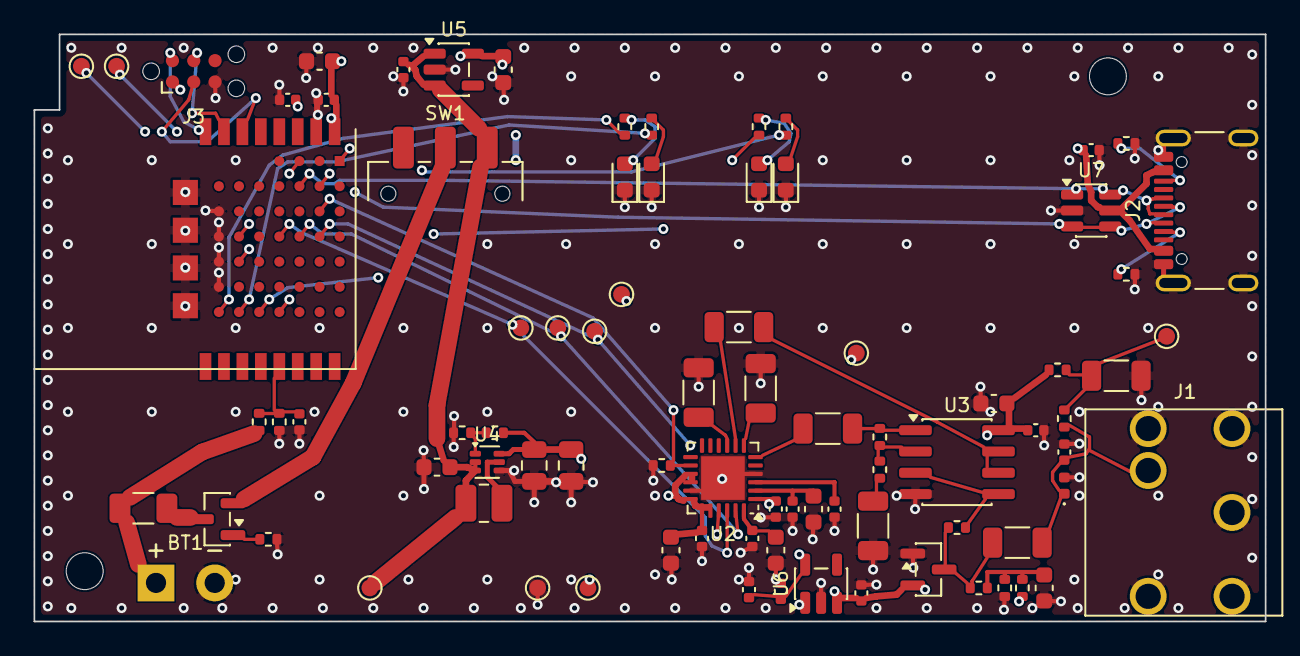
[picture p19: board pack.kicad_pcb from above]

Board: 4 copper layers, 73.4 x 35.0 mm, 86 parts (0 on the bottom side), 50 nets.

Parts:
BT1: 18650 cradle contacts; Cell_Wire_Pads
C1, C5, C11, C14, C21, C24, C26, C28: 10u; C_0603_1608Metric
C2, C3: 22u; C_0805_2012Metric
C4, C6, C7, C19, C23, C31: 1u; C_0402_1005Metric
C8: 47u; C_1206_3216Metric
C9: 22p; C_0402_1005Metric
C10, C15, C16, C17, C18: 10u; C_1206_3216Metric
C12: 100u; C_1206_3216Metric
C13, C20, C22, C25, C27, C29, C30, C32: 100n; C_0402_1005Metric
D1: green BAT; LED_0603_1608Metric
D2: red BAT LOW; LED_0603_1608Metric
D3: amber PEAK; LED_0603_1608Metric
D4: red CLIP; LED_0603_1608Metric
D5: TPD1E10B06; D_0402_1005Metric
D6: BAV199; SOT-23
F1: 3A fast; Fuse_1206_3216Metric
H1, H2: MountingHole_2.2mm_M2
J1: 3.5mm locking; SameSky_SJ1-3543
J2: USB-C; USB_C_Receptacle_GCT_USB4105-xx-A_16P_TopMnt_Horizontal
J3: SWD; Tag-Connect_TC2030-IDC-NL_2x03_P1.27mm_Vertical
L1: 1uH 4.7A; L_1008_2520Metric
Q1: DMG2305UX; SOT-23
R1, R3, R6, R8, R11: 100k; R_0402_1005Metric
R2: 732k; R_0402_1005Metric
R4, R20: 100; R_0402_1005Metric
R5: 2.2k; R_0402_1005Metric
R7: 180k; R_0402_1005Metric
R9, R10: 330; R_0402_1005Metric
R12, R13: 1M; R_0402_1005Metric
R14, R15, R16, R17: 1k; R_0402_1005Metric
R18, R19: 5.1k; R_0402_1005Metric
SW1: recessed slide; SW_SPDT_CK_JS102011SAQN
TP1: UART_TX; TestPoint_Pad_D1.0mm
TP2: UART_RX; TestPoint_Pad_D1.0mm
TP3: VSYS; TestPoint_Pad_D1.0mm
TP4: +5V; TestPoint_Pad_D1.0mm
TP5: +3V3; TestPoint_Pad_D1.0mm
TP6: +3V3A; TestPoint_Pad_D1.0mm
TP7: +5V_BIAS; TestPoint_Pad_D1.0mm
TP8: GND; TestPoint_Pad_D1.0mm
TP9: I2S_BCLK; TestPoint_Pad_D1.0mm
TP10: I2S_FSYNC; TestPoint_Pad_D1.0mm
TP11: I2S_SDOUT; TestPoint_Pad_D1.0mm
U1: BT40NE; Fanstel_BT40NE
U2: PCM1840; WQFN-24-1EP_4x4mm_P0.5mm_EP2.6x2.6mm
U3: OPA1656; SOIC-8_3.9x4.9mm_P1.27mm
U4: TPS61023; SOT-563
U5, U6: TLV75533P; SOT-23-5
U7: USBLC6-2SC6; SOT-23-6

Connections:
+3V3: C5.1, C26.1, C27.1, C28.1, C29.1, C32.1, J3.1, TP5.1, U1.9, U1.F4, U2.15, U2.16, U2.18, U2.19, U2.20, U5.5
+3V3A: C7.1, C19.1, C20.1, TP6.1, U2.1, U6.5
+5V: C2.1, C3.1, C6.1, C13.1, C14.1, D6.2, R2.1, R4.1, R7.1, TP4.1, U3.8, U4.6, U6.1, U6.3
+5V_BIAS: C8.1, R4.2, R5.1, TP7.1
ADC_AREG: C21.1, C22.1, U2.2
ADC_DREG: C24.1, C25.1, U2.24
ADC_IN1M: C16.1, U2.7
ADC_IN1P: C15.2, U2.6
ADC_IN2M: C18.1, U2.9
ADC_IN2P: C17.2, U2.8
ADC_SHDNZ: R11.1, U1.D5, U2.14
ADC_VREF: C23.1, U2.3
BAT+: BT1.1, F1.1, R12.1
BAT_F: F1.2, Q1.3
BOOST_FB: R2.2, R3.1, U4.1
BOOST_SW: L1.2, U4.5
GND: BT1.2, C1.2, C2.2, C3.2, C4.2, C5.2, C6.2, C7.2, C8.2, C9.2, C11.2, C12.2, C13.2, C14.2, C16.2, C18.2, C19.2, C20.2, C21.2, C22.2, C23.2, C24.2, C25.2, C26.2, C27.2, C28.2, C29.2, C30.2, C31.2, C32.2, D1.1, D2.1, D3.1, D4.1, D5.2, D6.1, J1.MP, J1.R, J1.S, J2.A1, J2.A12, J2.B1, J2.B12, J2.SH, J3.5, R1.2, R3.2, R8.2, R11.2, R13.2, R18.2, R19.2, TP8.1, U1.10, U1.A0, U1.B0, U1.C0, U1.D0, U1.H0, U1.H1, U1.H2, U1.H3, U2.4, U2.17, U2.25, U3.4, U4.4, U5.2, U6.2, U7.2
I2S_BCLK: TP9.1, U1.C3, U2.22
I2S_FSYNC: TP10.1, U1.C4, U2.23
I2S_SDOUT: TP11.1, U1.C5, U2.21
LED_BAT_LOW: R15.1, U1.Z1
LED_BAT_LOW_A: D2.2, R15.2
LED_BAT_OK: R14.1, U1.Z0
LED_BAT_OK_A: D1.2, R14.2
LED_CLIP: R17.1, U1.Z3
LED_CLIP_A: D4.2, R17.2
LED_PEAK: R16.1, U1.Z2
LED_PEAK_A: D3.2, R16.2
MIC: C9.1, C10.1, D5.1, J1.T, R5.2
PRE_CG: C12.1, R10.2
PRE_INM: R9.2, R10.1, U3.2
PRE_INP: R20.2, U3.3, U3.5
PRE_NP: C10.2, D6.3, R6.1, R20.1
PRE_OUTA: C15.1, R9.1, U3.1
PRE_OUTB: C17.1, U3.6, U3.7
Q1_G: Q1.1, R1.1
SWDCLK: J3.4, U1.15
SWDIO: J3.2, U1.16
UART_RX: TP2.1, U1.C1
UART_TX: TP1.1, U1.B1
USB_CC1: J2.A5, R18.1
USB_CC2: J2.B5, R19.1
USB_D+: J2.A6, J2.B6, U1.E4, U7.1, U7.6
USB_D-: J2.A7, J2.B7, U1.E5, U7.3, U7.4
USB_VBUS: C31.1, J2.A4, J2.A9, J2.B4, J2.B9, U1.F6, U7.5
VBAT_RP: Q1.2, SW1.2
VBAT_SENSE: C30.1, R12.2, R13.1, U1.5
VCM: C11.1, R6.2, R7.2, R8.1
VSYS: C1.1, C4.1, L1.1, SW1.3, TP3.1, U4.2, U4.3, U5.1, U5.3
nRESET: J3.3, U1.14
