saturncity/openpack/hw/rack/out/sch/backplane_rf_a1.kicad_sch

## KiCad design hw/rack/out/sch/backplane_rf_a1.kicad_sch (2026-11-01)

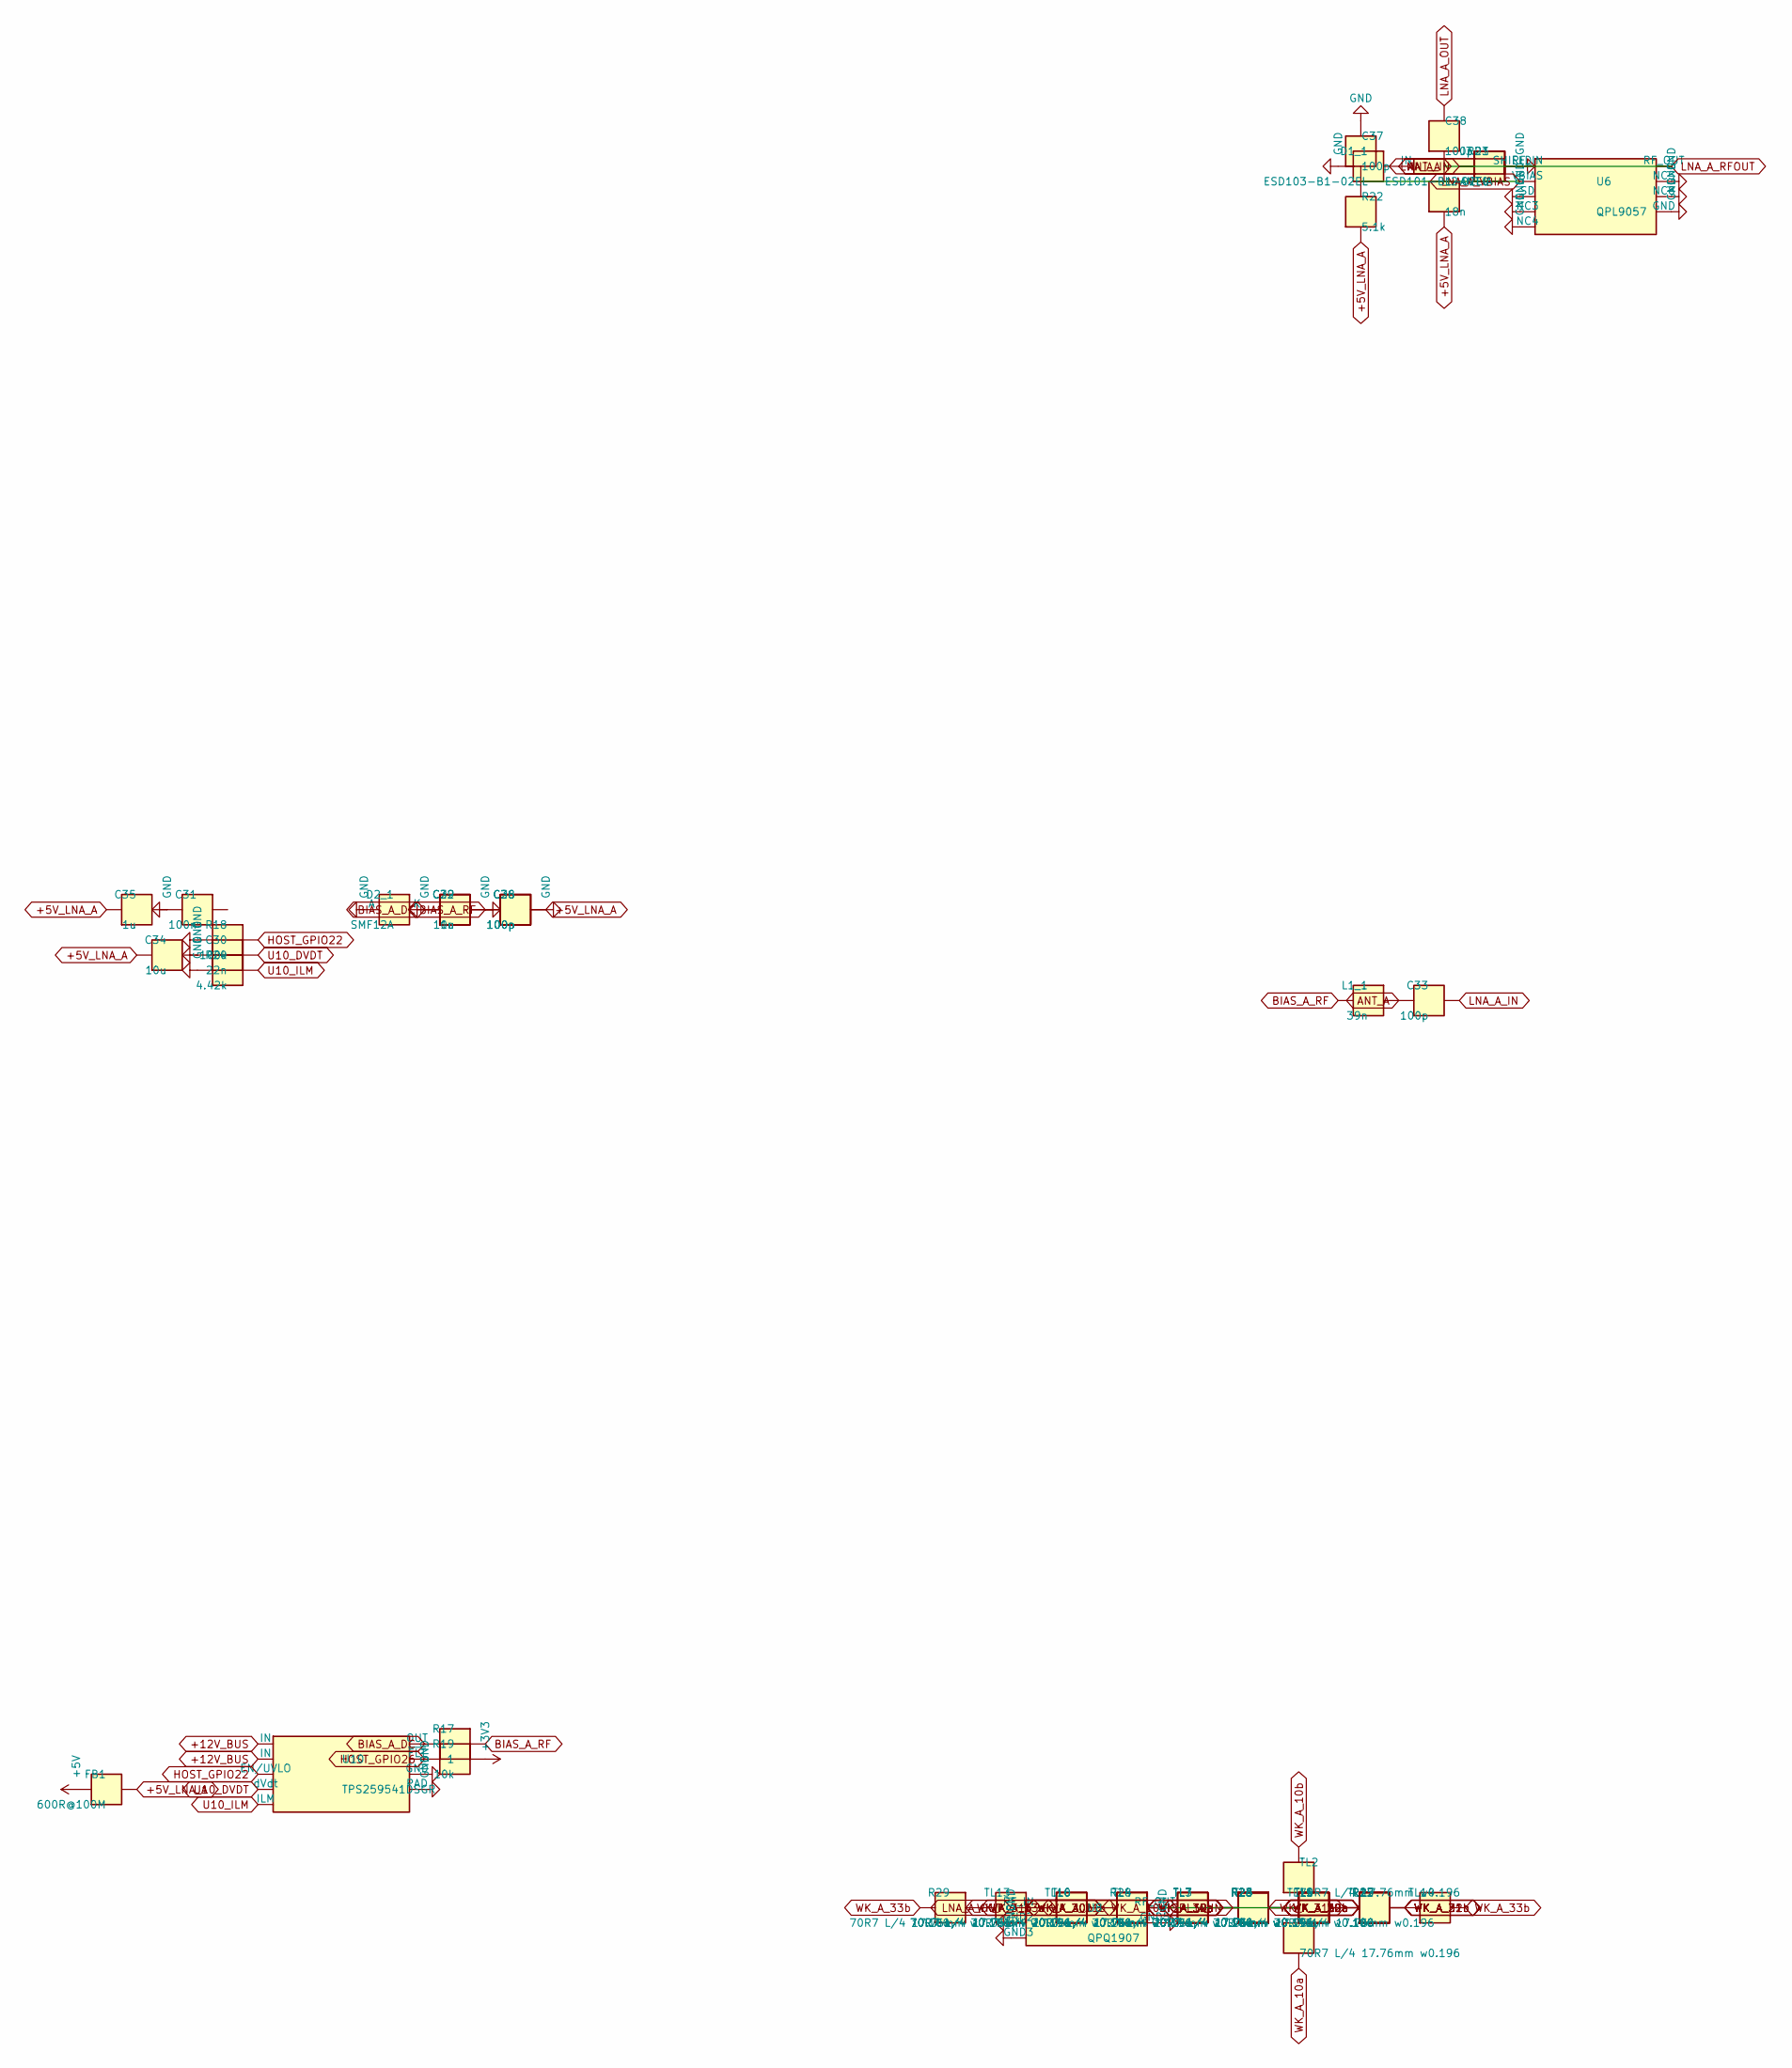
[picture p20: schematic backplane_rf_a1.kicad_sch]

Parts:
C28, C33, C36, C37, C38: 100p; C_0402_1005Metric; MPN C_100p_0402_C0G
C29: 10n; C_0402_1005Metric; MPN C_10n_0402
C30: 22n; C_0402_1005Metric; MPN C_22n_0402
C31: 100n; C_0402_1005Metric; MPN C_100n_0402
C32, C35: 1u; C_0402_1005Metric; MPN C_1u_0402
C34: 10u; C_0603_1608Metric; MPN C_10u_0603_X5R
D1_1: ESD103-B1-02EL; D_0402_1005Metric; MPN ESD103-B1-02EL
D2_1: SMF12A; D_SOD-123F; MPN SMF12A
D3: ESD101-B1-02EL; D_0402_1005Metric; MPN ESD101-B1-02EL
FB1: 600R@100M; L_0603_1608Metric; MPN FB_0603_600R
J3: ANT A; BNC_Amphenol_112487_RA_Bulkhead; MPN 112487
L1_1: 39n; L_0603_1608Metric; MPN LQW18AN39NG80D
L2: 18n; L_0402_1005Metric; MPN 0402CS-18NXG
R17: 1; R_2512_6332Metric; MPN R_2512_1R_1W
R18: 100k; R_0402_1005Metric; MPN R_0402_1%
R19: 10k; R_0402_1005Metric; MPN R_0402_1%
R20: 4.42k; R_0402_1005Metric; MPN R_0402_1%
R21: 0; R_0402_1005Metric; MPN R_0402_0R
R22: 5.1k; R_0402_1005Metric; MPN R_0402_1%
R23, R24, R25, R26, R27, R28, R29: 100; R_0402_1005Metric; MPN R_0402_100R_TF
TL1, TL2, TL3, TL4, TL5, TL6, TL7, TL8, TL9, TL10, TL11, TL12, TL13, TL14: 70R7 L/4 17.76mm w0.196; Microstrip_NetTie; MPN PCB_TRACE
U6: QPL9057; DFN-8-1EP_2x2mm_P0.5mm_EP0.9x1.6mm; MPN QPL9057TR7
U8: QPQ1907; Qorvo_QPQ1907_LGA5_1.4x1.2mm_datasheet_land_pattern; MPN QPQ1907SR
U10: TPS259541DSGR; WSON-8-1EP_2x2mm_P0.5mm_EP0.9x1.6mm; MPN TPS259541DSGR

Connections:
+3V3: R19.1
+5V: FB1.1
+5V_LNA_A: C28.1, C28.2, C29.1, C29.2, C30.2, C31.2, C32.1, C32.2, C33.2, C34.1, C34.2, C35.1, C35.2, C36.1, C36.2, C37.2, C38.1, D1_1.2, D2_1.1 (K), D2_1.2 (A), D3.1, D3.2, FB1.2, J3.2 (SHIELD), L1_1.2, L2.1, L2.2, R17.1, R17.2, R18.2, R20.2, R21.1, R21.2, R22.1, U6.2 (RF_IN), U6.3 (NC3), U6.4 (NC4), U6.5 (NC5), U6.6 (SD), U6.7 (RF_OUT), U6.8 (NC8), U6.9 (GND), U8.2 (GND2), U8.3 (GND3), U8.5 (GND5), U10.5 (OUT), U10.8 (GND), U10.9 (PAD)
+12V_BUS: U10.3 (IN), U10.4 (IN)
ANT_A: C33.1, D1_1.1, J3.1 (IN), L1_1.1
HOST_GPIO22: R18.1, U10.2 (EN/UVLO)
HOST_GPIO26: R19.2, U10.6 (~FLT)
LNA_A_OUT: C38.2, U8.1 (RF_IN)
LNA_A_VBIAS: C37.1, R22.2, U6.1 (VBIAS)
SPL_A_IN: R23.1, R23.2, R24.1, R24.2, R25.2, R26.1, R26.2, R27.2, R28.1, R28.2, TL1.1, TL1.2, TL2.1, TL2.2, TL3.1, TL3.2, TL4.1, TL4.2, TL5.1, TL6.1, TL6.2, TL7.1, TL7.2, TL8.1, TL8.2, TL9.1, TL10.1, TL10.2, TL11.2, TL12.2, TL13.1, TL14.1, U8.4 (RF_OUT)
U10_DVDT: C30.1, U10.1 (dVdt)
U10_ILM: R20.1, U10.7 (ILM)
WK_A_31a: R25.1, R27.1, TL5.2, TL9.2, TL11.1, TL12.1
WK_A_33a: R29.1, TL13.2
WK_A_33b: R29.2, TL14.2
