saturncity/openpack/hw/bom/shopping.py

"""Build hw/bom/shopping.csv and docs/shopping-list.md (issue #36, ADR-0019).

    python3 hw/bom/shopping.py          # rewrite both files
    python3 hw/bom/shopping.py --check  # exit 1 if either is stale

Pack and receiver lines are derived from hw/bom/pack_uk.csv and hw/rx/out/bom.csv so quantities follow the boards.
Rack backplane parts come from hw/bom/rack_uk.csv (the hw/rack/out/bom.csv of PR #126 summed per MPN, UK baskets chosen here).
Hand-entered lines (bench, antennas, fab, mechanical, rack host/case/PCB) are in MANUAL below.
An MPN is bought once: when packs, receivers and the rack all use it, the demands are summed into one line.
All GBP, ex VAT; VAT 20 % on everything (LCSC / JLCPCB: collected at checkout, no duty under GBP 135 per order).
"""
import csv
import math
import pathlib
import sys
from collections import OrderedDict

HERE = pathlib.Path(__file__).resolve().parent
ROOT = HERE.parent.parent
VAT = 0.20
N_PACKS = 4
N_RX = 4          # one receiver sub-board per pack (ADR-0018 slot per carrier); the rack has 8 slots, 4 are used
CUTS_ARE_IN_TOTAL = True  # owner has not decided the optional cuts: their cost stays in the required total
RX_Q4_UPLIFT = 1.30  # hw/rx prices are qty-100; pack_uk.csv shows qty-4 is ~1.3x qty-100 for active parts
D_REPO = "2026-10-31"
D_NOW = "2026-11-01"

BASKETS = [  # order = basket order in the list
    "Digi-Key UK", "Mouser UK", "Farnell UK", "RS UK", "LCSC", "JLCPCB",
    "ITM Components", "Simply Sound & Lighting", "Rapid Online", "The Pi Hut", "Thomann", "Lab401 (EU)", "The Debug Store", "Knives and Tools UK", "123-3D UK",
    "tinySA reseller (UK)",
]
SEARCH = {
    "Digi-Key UK": "https://www.digikey.co.uk/en/products/result?keywords=",
    "Mouser UK": "https://www.mouser.co.uk/c/?q=",
    "Farnell UK": "https://uk.farnell.com/w/search?st=",
    "RS UK": "https://uk.rs-online.com/web/c/?searchTerm=",
    "LCSC": "https://www.lcsc.com/search?q=",
}
FIELDS = ["basket", "category", "item", "mpn", "qty", "unit_gbp_ex", "line_gbp_ex", "line_vat", "price_status",
          "source_url", "date_read", "required", "cut_qty", "reason", "notes"]

CAT_BENCH, CAT_PACK, CAT_RX, CAT_ANT, CAT_FAB, CAT_MECH, CAT_SHIP, CAT_RACK = (
    "Bench kit", "Packs x4", "Receivers x4", "Antennas, coax, stands", "PCB fabrication", "Mechanical and cells",
    "Shipping", "Rack")


def line(basket, cat, item, mpn, qty, unit, status, url, date, reason, notes="", required=True, cut_qty=0):
    """cut_qty: how many of qty the owner may choose to drop (an optional cut). The line stays in the required total."""
    return dict(basket=basket, category=cat, item=item, mpn=mpn, qty=qty, unit_gbp_ex=unit, price_status=status,
                source_url=url, date_read=date, required="yes" if required else "optional", cut_qty=cut_qty,
                reason=reason, notes=notes)


# ---------------------------------------------------------------- hand-entered lines
Q, E = "quoted", "estimated"
MANUAL = [
    # Bench kit
    line("Digi-Key UK", CAT_BENCH, "nRF5340-DK", "nRF5340-DK", 2, 36.58, Q, SEARCH["Digi-Key UK"] + "nRF5340-DK", D_NOW,
         "Phase 5 DK bring-up (#38): ADC/DAC delay, T_GAP, lock, end-to-end latency. Second DK is the peer. OPTIONAL CUT: the second DK (GBP 36.58) is listed under the optional cuts.",
         "Digi-Key UK result page 2026-11-01: GBP 36.58 qty 1 (DK UK shows ex VAT; the page does not label it). Stock level not shown on the result page. Also stocked by Mouser UK and Farnell UK (their pages timed out).", cut_qty=1),
    line("Digi-Key UK", CAT_BENCH, "Nordic Power Profiler Kit II", "nRF-PPK2", 1, 80.17, Q, SEARCH["Digi-Key UK"] + "nRF-PPK2", D_NOW,
         "#38 FEM and pack current; sources/measures 0.8-5 V for the battery-life check.",
         "Digi-Key UK 2026-11-01: GBP 80.17 ex VAT (96.20 inc), 1,798 in stock. OPTIONAL CUT (listed under the optional cuts).", cut_qty=1),
    line("Digi-Key UK", CAT_BENCH, "TI PCM1840 evaluation module", "PCM1840EVM", 1, 148.84, Q, SEARCH["Digi-Key UK"] + "PCM1840EVM", D_NOW,
         "#38 ADC delay and noise measured before the pack is populated (ADR-0019 mitigation).",
         "Digi-Key UK 2026-11-01: GBP 148.84 ex VAT (178.61 inc), 2 in stock, 12 week factory lead time, purchase limit applies. Was estimated at 55: nearly 3x higher. Order early; Mouser UK page timed out. OPTIONAL: under the single-purchase plan (ADR-0019) the PCM1840 arrives on our own pack boards at the same time, so a separate eval board adds no earlier test step.", False),
    line("The Debug Store", CAT_BENCH, "Tag-Connect TC2030-IDC-NL cable (2x5 1.27 mm to TC2030 no-legs)", "TC2030-IDC-NL", 1, 46.00, Q,
         "https://thedebugstore.com/products/tag-connect-tc2030-idc-nl-cable-uk", D_NOW,
         "Programs and debugs the pack and receiver boards (both carry TC2030 pads only, no header). Not in either BOM, so a missing item.",
         "UK Tag-Connect stockist. GBP 46.00 ex VAT from the search-result snippet (55.20 inc); the product page read 2026-11-01 showed 42.00 ex VAT and is internally inconsistent, so the higher figure is used. SOLD OUT on the page, dispatch within 10 working days if ordered. Digi-Key UK does not list the -NL cable (only TC2030-IDC with legs, GBP 33.31, 339 in stock, which needs mounting holes the boards lack)."),
    line("Digi-Key UK", CAT_BENCH, "PCM5102A I2S DAC breakout board (Adafruit 6250)", "Adafruit 6250", 1, 3.70, Q,
         "https://www.digikey.co.uk/en/products/result?keywords=1528-6250-ND", D_NOW,
         "#38 I2S backend and the DAC output chain on the bench; FLT/XSMT strap tests (ADR-0017).",
         "Digi-Key UK 2026-11-01: GBP 3.70 ex VAT (4.44 inc), 494 in stock. The Pi Hut search found no PCM5102 board."),
    line("Digi-Key UK", CAT_BENCH, "8-channel 24 MHz USB logic analyser (Cypress FX2, sigrok fx2lafw), SparkFun", "SparkFun 18627", 1, 20.44, Q,
         "https://www.digikey.co.uk/en/products/result?keywords=logic%20analyzer%20USB%208%20channel", D_NOW,
         "#38 end-to-end latency via GPIO toggles; I2S and frame-clock phasing (ADR-0020/0022). 24 MHz sampling is 40 ns against ms-scale latency.",
         "Digi-Key UK 2026-11-01: GBP 20.44 ex VAT, 968 in stock; the SparkFun unit is documented for sigrok PulseView. The Pi Hut lists the same unit at GBP 26.30 inc VAT (21.92 ex) but SOLD OUT 2026-11-01."),
    line("The Pi Hut", CAT_BENCH, "Micro-USB cable 1 m (DK, PPK2, programming)", "USB-A to micro-B 1 m", 3, 2.50, E, "https://thepihut.com", "",
         "Powers/connects 2 DKs and the PPK2.", "Estimate."),
    line("The Pi Hut", CAT_BENCH, "Dupont jumper wires F-F 20 cm (40-pack)", "Dupont F-F 40", 2, 2.50, E, "https://thepihut.com", "",
         "Logic analyser probes to DK pins and board test pads (TP1-TP13 on the receiver).", "Estimate."),
    line("Thomann", CAT_BENCH, "Lavalier microphone, 3.5 mm TRS, omni electret", "Samson LM5 (or equivalent)", 1, 15.00, E,
         "https://www.thomann.de/gb/samson_lm5.htm", "",
         "Real source for the preamp/ADC chain on the bench (noise, THD, start-up) and R5 listening checks.",
         "Estimate; Thomann UK site ships to the UK (GBP prices inc VAT at checkout). Final show mic is the owner's choice and out of scope."),
    line("Thomann", CAT_BENCH, "Cable 3.5 mm TRS to 3.5 mm TRS 1.5 m", "TRS-TRS 1.5 m", 1, 3.50, E, "https://www.thomann.de/gb/", "",
         "DAC output to the PC sound card / headphone amp during #38.", "Estimate."),
    line("Digi-Key UK", CAT_BENCH, "SMA attenuator 20 dB 2 W DC-6 GHz (Mini-Circuits)", "VAT-20W2+", 1, 33.63, Q,
         "https://www.digikey.co.uk/en/products/result?keywords=attenuator%20SMA%2020dB%202W", D_NOW,
         "Protects the tinySA input while measuring conducted TX power at the pack u.FL (limit +7 dBm, ADR-0016/design-log).",
         "Digi-Key UK 2026-11-01: GBP 33.63 ex VAT, 137 in stock."),
    line("Digi-Key UK", CAT_BENCH, "SMA attenuator 10 dB 2 W DC-6 GHz (Mini-Circuits)", "VAT-10W2+", 1, 28.18, Q,
         "https://www.digikey.co.uk/en/products/result?keywords=attenuator%20SMA%2010dB", D_NOW,
         "Stacks to 30 dB for the nRF21540 +20 dBm case if the FEM is fitted.",
         "Digi-Key UK 2026-11-01: GBP 28.18 ex VAT, 455 in stock. Cheaper DC-4 GHz Cinch part exists (GBP 17.95) but would not cover harmonics."),
    line("Digi-Key UK", CAT_BENCH, "u.FL to SMA female pigtail 150 mm (GCT)", "CABLE 348 RF-150-A-1", 2, 2.19, Q,
         "https://www.digikey.co.uk/en/products/result?keywords=U.FL%20to%20SMA%20cable%20assembly", D_NOW,
         "Connects the pack/receiver u.FL (and the DK RF connector) to the SMA attenuator and analyser.",
         "Digi-Key UK 2026-11-01: GBP 2.19 ex VAT, 1,228 in stock; U.FL (MHF1) to SMA, 5.9 in. Check the SMA end is a jack (listing does not say) before ordering."),
    line("Farnell UK", CAT_BENCH, "SMA male-male adapter", "SMA-MM", 2, 3.00, E, SEARCH["Farnell UK"] + "SMA+male+male+adapter", "",
         "Joins attenuators to the tinySA.", "Estimate."),
    line("Lab401 (EU)", CAT_BENCH, "tinySA Ultra+ spectrum analyser 100 kHz-5.4 GHz (CE version)", "tinySA Ultra+", 1, 140.00, Q,
         "https://lab401.com/products/tinysa-ultra", D_NOW,
         "#92 / design-log AN-risk 2: conducted TX power and the 99 % OBW and 2483.5-2487.6 MHz emissions on a pack at 2482 MHz (limit 2.51 MHz OBW). Cheapest adequate; indicative, not a lab EN 300 328 report.",
         "DECISION: no UK stockist found (tinysa.org buy page 404, Technofix not found, eBay 403, Amazon UK not found). Lab401 (France, EU) sells the Ultra+ (the current CE-compliant model; the original Ultra is retired at eleshop.eu), EUR 163.00 on 2026-11-01, in stock for EU, UK is in its country list but UK shipping was not confirmed. GBP 140 = EUR 163 x 0.86 (assumed rate; VAT basis of the EUR price not stated). Delivery line is an estimate. Input max is +10 dBm so the 20 dB attenuator is belt and braces. Fallback: Siglent SSA1015X-class from RS UK (about GBP 700)."),
    line("tinySA reseller (UK)", CAT_BENCH, "NanoVNA-H4 vector network analyser", "NanoVNA-H4", 1, 75.00, E, "https://nanovna.com", "",
         "Optional: RF-11 (QPQ1907 loss at band edges), antenna/coax S11, receiver RF chain S2P checks.",
         "Optional. Estimate. UK stockist not confirmed; not searched.", False),
    line("RS UK", CAT_BENCH, "Rigol DS1054Z 50 MHz 4-channel oscilloscope", "DS1054Z", 1, 310.00, E, SEARCH["RS UK"] + "DS1054Z", "",
         "Optional: preamp step into 10 nF, start-up transient, boost ripple, P48/hot-plug transients. The PPK2 and logic analyser do not see analogue waveforms.",
         "Optional. Estimate; skip if the owner already has a scope.", False),

    # Antennas, coax, stands (decided)
    line("ITM Components", CAT_ANT, "L-com HyperLink 2.4 GHz 8 dBi flat patch, N-female", "HG2409P-NF", 2, 72.12, Q,
         "https://www.itm.com", D_NOW,
         "One per wing (ADR-0021); R1 antenna.", "Price from ADR-0016 (ITM Components UK). Assumed ex VAT (ITM lists ex VAT by default); ADR does not state the basis."),
    line("ITM Components", CAT_ANT, "L-com CA3N030 400-series coax N-male/N-male 9.14 m (30 ft): rack to near wing", "CA3N030", 1, 45.80, Q,
         "https://www.itm.com", D_NOW,
         "Rack to near-wing boom, owner decision (#126 choice, RK-7h).",
         "Owner-given ITM price GBP 45.80 ex VAT, one per rack."),
    line("ITM Components", CAT_ANT, "L-com CA3N075 400-series coax N-male/N-male 22.86 m (75 ft): rack to far wing", "CA3N075", 1, 88.02, Q,
         "https://www.itm.com", D_NOW,
         "Rack to far-wing boom (12 m stage). A 30 ft lead does not reach the far wing (design-log RK-7h; audit.py Audit 5 needs 13.6 m on a 6 x 6 m venue). 7.65 dB at 100 ft is the longest the wing noise figure allows.",
         "ITM Components UK, ex VAT, read 2026-11-01 (rack PR #126, hw/rack/prices.py ANTENNA_KIT)."),
    line("RS UK", CAT_ANT, "Amphenol RF N socket to BNC plug adapter (at the rack BNC, one per wing)", "NF-BM-NT3G-50", 2, 8.40, Q,
         "https://uk.rs-online.com/web/c/?searchTerm=285-6398", D_NOW,
         "Joins each coax to the rack BNC. Replaces the L-com LCCA30301-FT1.5 jumper (GBP 37.09 each): 0.1 dB instead of ~0.2 dB plus a mated pair (rack PR #126).",
         "RS UK 285-6398, ex VAT, from a search snippet 2026-11-01 (rack PR #126); stock not seen."),
    line("ITM Components", CAT_ANT, "L-com HGX-PMT07 pole mount bracket for HG2409P", "HGX-PMT07", 2, 14.45, Q,
         "https://www.itm.com", D_NOW, "Holds each panel on the stand pole at 4 m, tilted 10 deg down (ADR-0021).", "Owner-given ITM price ex VAT."),
    line("Simply Sound & Lighting", CAT_ANT, "Thor winch-up lighting stand", "LS003", 2, 140.83, Q,
         "https://www.simplysoundandlighting.co.uk", D_NOW,
         "4 m mounting height in each wing where the venue has no boom (ADR-0021; install doc step 3).",
         "Owner-given ~GBP 140.83 ex VAT each. Large item: delivery is a separate line (estimated). OPTIONAL CUT: the venue's own lighting stands or booms may serve (the HGX-PMT07 U-bolt mounts stay).", cut_qty=2),

    # Mechanical and cells
    line("RS UK", CAT_MECH, "Protected 18650 Li-ion cell, button top, ~3000 mAh", "18650 protected", N_PACKS + 2, 7.00, E,
         SEARCH["RS UK"] + "protected+18650", "",
         "PK-6: one removable protected 18650 per pack, no on-board charging. 4 + 2 spares for bench and failure.",
         "Estimate, NOT sourced. Must be PROTECTED and button-top. RS UK shipping of cells unconfirmed. Tried 2026-11-01: Nkon (403), 18650.UK (TLS error), Fogstar (only a sold-out unprotected 2500 mAh cell, GBP 6.49, on page 1 of 3), Digi-Key UK (no cells in the search). Next: Fogstar or 18650.UK by hand, Nkon by courier."),
    line("Knives and Tools UK", CAT_MECH, "External 18650 charger, 2-bay, USB (Nitecore UI2)", "Nitecore UI2", 1, 16.63, Q,
         "https://knivesandtools.co.uk/en/pt/-nitecore-ui2-battery-charger.htm", D_NOW,
         "The pack has no charging circuit (PK-6), so cells charge externally.",
         "GBP 19.95 inc VAT on the page 2026-11-01 (16.63 ex; a search snippet showed 15.45), in stock, ships from the Netherlands. LED, no display."),
    line("123-3D UK", CAT_MECH, "PETG filament 1.75 mm, 1 kg spool (eSun solid grey; enclosures + belt clips)", "eSun PETG 1 kg", 1, 11.67, Q,
         "https://www.123-3d.co.uk/eSun-PETG-filament-1-75mm-Solid-Grey-1-kg-i9656.html", D_NOW,
         "ADR-0008: printed PETG body, clip and cradle on the Bambu A1 mini (assumed owned, not listed). About 30 g per pack; 1 kg covers reprints.",
         "SEARCH-RESULT SNIPPET, 2026-11-01: GBP 14.00 inc, 11.67 ex VAT. The product page returned HTTP 429, stock not confirmed; other 123-3D snippets disagreed (13.33 to 19.96 ex)."),
    line("RS UK", CAT_MECH, "M2 x 6 pan-head thread-forming screws, pack of 100", "M2x6 PT pan", 1, 6.00, E, SEARCH["RS UK"] + "M2x6+thread+forming", "",
         "2 per pack board retention into printed bosses (ADR-0008, pack_uk.csv).", "Estimate; replaces the US Fastener Superstore source in pack_uk.csv."),
    line("RS UK", CAT_MECH, "M2 brass heat-set inserts, pack of 50", "M2 heat-set insert", 1, 7.00, E, SEARCH["RS UK"] + "M2+heat+set+insert", "",
         "Clip screws into 7 mm bosses (ADR-0008), two per pack plus spares.", "Estimate."),
    line("RS UK", CAT_MECH, "Silicone hookup wire 24 AWG, 5 m red/black", "24AWG silicone", 1, 5.00, E, SEARCH["RS UK"] + "24AWG+silicone+wire", "",
         "Cell leads (2 x 60 mm per pack) and the 31 mm whip wire.", "Estimate."),
    line("RS UK", CAT_MECH, "Lead-free low-temperature solder paste, 35 g syringe (Chip Quik SMD LTLF)", "RS 146-6200", 1, 29.37, Q,
         "https://uk.rs-online.com/web/p/solder-pastes/1466200", D_NOW,
         "Bare PCBs plus stencil, assembly waits for bench results (ADR-0019); hot-plate reflow. 8 boards of about 70-95 parts each; 35 g replaces 2 x 10 g.",
         "SEARCH-RESULT SNIPPET 2026-11-01: GBP 29.37 ex VAT (35.24 inc); product page returned 403. Stock not seen. Farnell UK SMDLTLFP10T5 (10 g) found no price. Reflow hot plate/oven is not listed: if the owner has none, add a hot plate (about GBP 40)."),
    # PCB fabrication (JLCPCB)
    line("JLCPCB", CAT_FAB, "Pack PCB, 4-layer, 73.5 x 35.1 mm, 1.6 mm, ENIG, 10 pcs", "pack.kicad_pcb", 1, 28.00, E,
         "https://cart.jlcpcb.com/quote", "",
         "4 packs plus 6 spares so a re-spin or a bad solder job costs boards, not a new order (ADR-0019). Size/layers from hw/pack/out/fab/pack-job.gbrjob.",
         "Estimate; JLCPCB quote page is dynamic and was not readable 2026-11-01. Only published datum: 4-layer board charge USD 70.6/m2 (Mar 2024 news), which makes the board area itself under GBP 1; the rest is engineering fee, ENIG and shipping. Gerbers: hw/pack/out/fab/gerber. No JLC assembly is assumed (ADR-0019: hand/hot-plate reflow)."),
    line("JLCPCB", CAT_FAB, "Pack stencil, top side only, frameless", "pack stencil", 1, 8.00, E, "https://cart.jlcpcb.com/quote", "",
         "All 70 pack parts are on Top (cpl_jlc.csv), one stencil.", "Estimate."),
    line("JLCPCB", CAT_FAB, "Receiver sub-board PCB, 4-layer, 48.1 x 90.1 mm, 1.6 mm, ENIG, 10 pcs", "rx.kicad_pcb", 1, 36.00, E,
         "https://cart.jlcpcb.com/quote", "",
         "4 receivers plus 6 spares (50 ohm RF traces, 4-layer). Size/layers from hw/rx/out/fab/rx-job.gbrjob.",
         "Estimate; 5 pcs would do for 4 boards but 10 costs little more. Gerbers: hw/rx/out/fab/gerber."),
    line("JLCPCB", CAT_FAB, "Receiver stencil, top side only, frameless", "rx stencil", 1, 8.00, E, "https://cart.jlcpcb.com/quote", "",
         "All 95 receiver parts are on Top, one stencil.", "Estimate."),

    # Shipping
    line("Digi-Key UK", CAT_SHIP, "Delivery (UPS, duty-paid)", "-", 1, 0.00, E, "https://www.digikey.co.uk", "",
         "Free above the Digi-Key UK threshold (about GBP 33, unconfirmed); basket is far above it.", "Estimate."),
    line("Mouser UK", CAT_SHIP, "Delivery", "-", 1, 6.00, E, "https://www.mouser.co.uk", "",
         "Small basket; Mouser UK free-shipping threshold not confirmed.", "Estimate."),
    line("Farnell UK", CAT_SHIP, "Delivery", "-", 1, 4.00, E, "https://uk.farnell.com", "",
         "Under the free-delivery threshold (older sources say GBP 20 ex VAT, unconfirmed).", "Estimate."),
    line("RS UK", CAT_SHIP, "Delivery", "-", 1, 0.00, E, "https://uk.rs-online.com", "",
         "Free over GBP 50 ex VAT (pack-parts-uk-draft.md); basket is above it.", "Estimate."),
    line("LCSC", CAT_SHIP, "Shipping to the UK (courier) + import VAT at checkout", "-", 1, 12.00, E, "https://www.lcsc.com", "",
         "LCSC to UK is a worldwide courier. Order is under GBP 135, so VAT (20 %) is collected at checkout and there is no duty.",
         "Estimate; UK shipping option not confirmed (LCSC page unreadable per pack-parts-uk-draft.md)."),
    line("JLCPCB", CAT_SHIP, "Shipping to the UK (DHL) + import VAT at checkout", "-", 1, 16.00, E, "https://cart.jlcpcb.com/quote", "",
         "JLCPCB collects UK VAT (20 %) at checkout; no duty under GBP 135.", "Estimate."),
    line("ITM Components", CAT_SHIP, "Delivery (antennas and coax)", "-", 1, 10.00, E, "https://www.itm.com", "",
         "Coax drums are heavy.", "Estimate."),
    line("Simply Sound & Lighting", CAT_SHIP, "Delivery (2 stands)", "-", 1, 30.00, E, "https://www.simplysoundandlighting.co.uk", "",
         "Stands are about 10 kg each.", "Estimate. Goes with the stands if they are cut.", cut_qty=1),
    line("Rapid Online", CAT_SHIP, "Delivery (1U case, about 4 kg)", "-", 1, 6.00, E, "https://www.rapidonline.com", "",
         "Rapid UK delivery charge not read.", "Estimate."),
    line("The Pi Hut", CAT_SHIP, "Delivery", "-", 1, 3.50, E, "https://thepihut.com", "", "Standard.", "Estimate."),
    line("Thomann", CAT_SHIP, "Delivery to the UK", "-", 1, 8.00, E, "https://www.thomann.de/gb/", "",
         "Thomann ships from Germany; UK prices include VAT at checkout.", "Estimate."),
    line("Lab401 (EU)", CAT_SHIP, "Delivery to the UK (courier) + import VAT at the door", "-", 1, 15.00, E, "https://lab401.com", "",
         "EU seller; post-Brexit UK import VAT (20 %) is collected by the courier, unit is under GBP 135.", "Estimate; shipping is calculated at checkout."),
    line("The Debug Store", CAT_SHIP, "Delivery", "-", 1, 5.00, E, "https://thedebugstore.com", "", "UK seller.", "Estimate."),
    line("Knives and Tools UK", CAT_SHIP, "Delivery (fixed rate, from the Netherlands)", "-", 1, 8.29, Q,
         "https://knivesandtools.co.uk/en/pt/-nitecore-ui2-battery-charger.htm", D_NOW, "Fixed GBP 9.95 inc VAT for all orders.", "Page read 2026-11-01."),
    line("123-3D UK", CAT_SHIP, "Delivery", "-", 1, 4.00, E, "https://www.123-3d.co.uk", "", "Standard.", "Estimate."),

    # Rack: host, case, cables, panel parts, main-board PCB (hw/rack/prices.py EXTRAS, PR #126). Backplane parts: hw/bom/rack_uk.csv.
    line("The Pi Hut", CAT_RACK, "Raspberry Pi CM4 2 GB RAM / 8 GB eMMC, no wireless (SC0680 = CM4002008)", "CM4002008", 1, 79.20, Q,
         "https://thepihut.com", D_NOW, "Rack host (ADR-0018). SC0681 (16 GB eMMC) at the same price is the drop-in alternative.",
         "The Pi Hut UK qty 1, 2026-11-01 (coordinator decision on #95; DigiKey UK SC0680 was 0 stock at GBP 61.64)."),
    line("Digi-Key UK", CAT_RACK, "Raspberry Pi CM4 IO Board (SC0326)", "SC0326", 1, 26.15, Q, SEARCH["Digi-Key UK"] + "SC0326", D_NOW,
         "CM4 carrier for the rack host.", "Digi-Key UK 2026-11-01, read."),
    line("Digi-Key UK", CAT_RACK, "40-way IDC ribbon 152 mm socket-socket (Assmann H3AAH-4006G)", "H3AAH-4006G", 1, 1.30, Q,
         SEARCH["Digi-Key UK"] + "H3AAH-4006G", D_NOW, "Main board J2 to CM4IO J8.", "Digi-Key UK 2026-11-01, read."),
    line("LCSC", CAT_RACK, "CM4IO 12 V pigtail: JST VH 2-pin housing to 2.1 mm DC plug, 200 mm", "CM4IO-12V-pigtail", 1, 3.00, E,
         SEARCH["LCSC"] + "JST+VH+2+pin+housing", "", "Feeds the CM4IO from the main board J5.", "Estimate (rack PR #126); LCSC or RS UK."),
    line("RS UK", CAT_RACK, "Taoglas CAB.6012 U.FL-U.FL 1.13 mm jumper 100 mm", "CAB.6012", 16, 1.02, Q,
         SEARCH["RS UK"] + "069-0832", D_NOW,
         "Main-board RF port to each receiver J3/J4 (8 slots x 2); the ports sit right behind each receiver (0.3 dB + 2 mated pairs). All 16 are bought although 4 slots are used, as in #126.",
         "RS UK 069-0832, read by the coordinator 2026-11-01; stock unconfirmed. Alternative LCSC C7541876 (Kinghelm)."),
    line("Digi-Key UK", CAT_RACK, "Neutrik NE8FDP etherCON RJ45 feedthrough (rear panel)", "NE8FDP", 1, 12.78, Q,
         SEARCH["Digi-Key UK"] + "NE8FDP", D_NOW, "Rear-panel network port.", "Digi-Key UK 2026-11-01, read."),
    line("RS UK", CAT_RACK, "Cat6 patch lead 0.3 m (NE8FDP to CM4IO RJ45)", "Cat6 0.3 m", 1, 2.00, E, SEARCH["RS UK"] + "cat6+patch+0.3m", "",
         "Panel RJ45 to the CM4IO.", "Estimate (rack PR #126); RS UK or Farnell UK."),
    line("The Pi Hut", CAT_RACK, "Panel-mount USB-C socket to micro-B plug 30 cm, M3 ears 20 mm apart (Adafruit 4056)", "Adafruit 4056", 1, 3.83, Q,
         "https://thepihut.com", D_NOW,
         "CM4IO rpiboot port on the front panel (RK-1); no CC resistors, so service with a USB-A-to-C lead.",
         "The Pi Hut UK SKU 103462, GBP 4.60 inc VAT, read 2026-11-01; SOLD OUT that day (Adafruit direct USD 4.95). Order may wait."),
    line("Digi-Key UK", CAT_RACK, "Mean Well GST60A12-P1J 12 V 5 A desktop brick, 2.1 mm plug, C14 inlet", "GST60A12-P1J", 1, 14.50, Q,
         SEARCH["Digi-Key UK"] + "GST60A12-P1J", D_NOW, "Rack 12 V supply.", "Digi-Key UK 2026-11-01, read (6,852 in stock)."),
    line("Digi-Key UK", CAT_RACK, "UK mains cord BS1363 to C13, 1.83 m", "AC-12206-UK", 1, 8.35, Q,
         SEARCH["Digi-Key UK"] + "AC-12206-UK", D_NOW, "Mains lead for the 12 V brick.", "Digi-Key UK 2026-11-01, read (7,931 in stock)."),
    line("JLCPCB", CAT_RACK, "Rack main board, full JLCPCB order: 5 x 4-layer 412 x 321.5 mm ENIG boards, large framed stencil, extended-part fees, DHL ~2 kg, UK import VAT and handling",
         "rack.kicad_pcb", 1, 300.00, E, "https://cart.jlcpcb.com/quote", "",
         "The rack main board (hw/rack/out/fab). One board is used, four are spares (5 is JLC's minimum).",
         "ESTIMATE: reviewer's range GBP 250-350 for the whole order, mid value; the JLC quote page needs a browser, so quote before ordering. The figure already includes DHL and UK import VAT, so the VAT column here slightly overstates. Own order: the shipping line above is for the pack and receiver boards."),
    line("Rapid Online", CAT_RACK, "Hammond RM1U1913SBK 1U 19 in aluminium case, 330 mm deep", "RM1U1913SBK", 1, 140.76, Q,
         "https://www.rapidonline.com", D_NOW, "Rack chassis (mech/rack.py; panels drilled per hw/rack/mech/out).",
         "Rapid Online 31-1555, read by the coordinator 2026-11-01, in stock; DigiKey UK HM996-ND GBP 142.98 (90 in stock)."),
    line("RS UK", CAT_RACK, "M3 x 11 mm F-F hex spacer + 2 x M3 x 6 screws (receiver mounts, 2 per slot)", "M3x11 spacer set", 16, 0.30, E,
         SEARCH["RS UK"] + "M3+11mm+hex+spacer", "", "Receiver mounts H1/H2 in each of 8 slots.", "Estimate (brass class price; rack PR #126)."),
    line("RS UK", CAT_RACK, "M2.5 x 10 mm F-F spacer + screws (CM4IO above the main board)", "M2.5x10 spacer set", 4, 0.30, E,
         SEARCH["RS UK"] + "M2.5+10mm+spacer", "", "CM4IO standoffs.", "Estimate (rack PR #126)."),
    line("RS UK", CAT_RACK, "M3 x 5 mm F-F spacer + screws (main board to the case floor, 8 holes)", "M3x5 spacer set", 8, 0.25, E,
         SEARCH["RS UK"] + "M3+5mm+spacer", "", "Main-board mounting.", "Estimate (rack PR #126)."),
]


# ---------------------------------------------------------------- derived pack / receiver lines
def is_passive(mpn):
    return mpn.startswith(("C_", "R_", "ALU_", "GRM")) or mpn.startswith("GRM")


def spares(unit, passive, order):
    if passive:
        return max(10, math.ceil(0.25 * order))
    return 1 if unit < 1.0 else 0


def basket_for_rx(dist):
    d = dist.lower()
    if d.startswith("lcsc"):
        return "LCSC"
    if "farnell" in d and "digikey" not in d and "mouser" not in d:
        return "Farnell UK"
    if "mouser" in d and "digikey" not in d and "digi-key" not in d and "farnell" not in d:
        return "Mouser UK"
    return "Digi-Key UK"


def derive():
    """Sum the demand per MPN over packs, receivers and the rack, then place each MPN in ONE basket."""
    demand = OrderedDict()  # mpn -> dict(qty, who, srcs)

    def add(basket, mpn, qty, who, unit4, unit100, status, url, date, note, item):
        d = demand.setdefault(mpn, dict(qty=0, who=[], srcs=[]))
        d["qty"] += qty
        d["who"].append(who)
        d["srcs"].append(dict(basket=basket, unit4=unit4, unit100=unit100, status=status, url=url, date=date,
                              note=note, item=item, pack=who.startswith("pack")))

    with open(HERE / "pack_uk.csv") as f:
        for r in csv.DictReader(f):
            q = int(r["qty_per_pack"])
            dist, mpn = r["distributor"], r["mpn"]
            if q == 0 or dist in ("-", "") or dist.startswith("self") or mpn.startswith(("PCB-", "M2x6", "CELL-")):
                continue
            basket = {"Digi-Key UK": "Digi-Key UK", "Mouser UK": "Mouser UK", "LCSC": "LCSC"}[dist]
            blob = (r["notes"] + r["stock"]).upper()
            est = "ESTIMATE" in blob or "UNVERIFIED" in blob or "NOT CHECKED" in blob
            date = D_NOW if "2026-11-01" in blob else D_REPO
            url = r["url"]
            if url.rstrip("/").endswith((".co.uk", ".com")) or not url:
                url = SEARCH[basket] + mpn
            add(basket, mpn, q * N_PACKS, f"pack x{q}", float(r["gbp_qty4"]), float(r["gbp_qty100"]),
                E if est else Q, url, "" if est else date, r["notes"], r["ref"])

    with open(ROOT / "hw/rx/out/bom.csv") as f:
        for r in csv.DictReader(f):
            mpn, q = r["mpn"], int(r["qty"])
            if r["uk_distributor"] == "-" and not r["value"].startswith("U.FL-U.FL"):
                continue
            if r["value"].startswith("PCB"):
                continue
            if r["value"].startswith("U.FL-U.FL"):
                mpn, basket = "U.FL-U.FL-50MM", "LCSC"
            else:
                basket = basket_for_rx(r["uk_distributor"])
            unit = float(r["unit_gbp"])
            active = not is_passive(mpn) and unit >= 0.2
            src = r["source"]
            est = src.startswith("est") or "est." in src.lower()[:5] or active
            unit_adj = round(unit * RX_Q4_UPLIFT, 2) if active else unit
            quoted_exact = mpn == "BT40E"
            if quoted_exact:
                unit_adj, est = unit, False  # DK UK GBP 9.7765 quoted, used as is
            url = SEARCH[basket] + mpn
            note = (f"rx price from hw/rx/out/bom.csv ({src})" +
                    (f"; x{RX_Q4_UPLIFT} on the qty-100 figure for a 4-board order" if active and not quoted_exact else ""))
            add(basket, mpn, q * N_RX, f"rx x{q}", unit_adj, unit_adj, E if est else Q, url,
                "" if est else D_NOW, note, r["refs"])

    with open(HERE / "rack_uk.csv") as f:  # rack backplane parts, one rack (hw/rack/out/bom.csv, PR #126)
        for r in csv.DictReader(f):
            basket, mpn, unit = r["basket"], r["mpn"], float(r["unit_gbp"])
            quoted = r["status"] == "quoted"
            add(basket, mpn, int(r["qty"]), "rack", unit, unit, Q if quoted else E, SEARCH[basket] + mpn,
                D_NOW if quoted else "", "rack price from hw/rack/prices.py (" + r["source"] + ")", mpn)

    out = []
    labels = {"pack": "Packs x4", "rx": "Receivers x4", "rack": CAT_RACK}
    for mpn, d in demand.items():
        baskets = [s_["basket"] for s_ in d["srcs"]]
        basket = "LCSC" if "LCSC" in baskets else baskets[0]  # one basket per MPN; LCSC when any user can buy there
        cands = [s_ for s_ in d["srcs"] if s_["basket"] == basket]
        src = next((s_ for s_ in cands if s_["pack"]), cands[0])
        passive = is_passive(mpn)
        sp = spares(src["unit4"], passive, d["qty"])
        order = d["qty"] + sp
        unit = src["unit100"] if order >= 100 else src["unit4"]
        kinds = [k for k in ("pack", "rx", "rack") if any(w.startswith(k) for w in d["who"])]
        cat = labels[kinds[0]] if len(kinds) == 1 else " + ".join(labels[k] for k in kinds)
        reason = (f"Needed {d['qty']} ({'; '.join(d['who'])}; refs {src['item'][:40]}), +{sp} spare"
                  if sp else f"Needed {d['qty']} ({'; '.join(d['who'])})")
        out.append(line(basket, cat, mpn, mpn, order, round(unit, 4), src["status"],
                        src["url"], src["date"], reason, src["note"][:240]))
    return out


def all_lines():
    lines = derive() + MANUAL
    # tidy: item column readable
    for l in lines:
        l["qty"] = int(l["qty"])
        l["unit_gbp_ex"] = round(float(l["unit_gbp_ex"]), 4)
        l["line_gbp_ex"] = round(l["qty"] * l["unit_gbp_ex"], 2)
        l["line_vat"] = round(l["line_gbp_ex"] * VAT, 2)
    order = {b: i for i, b in enumerate(BASKETS)}
    lines.sort(key=lambda l: (order[l["basket"]], l["category"] == CAT_SHIP, l["category"], l["mpn"]))
    return lines


def write_csv(lines, path):
    with open(path, "w", newline="") as f:
        w = csv.DictWriter(f, fieldnames=FIELDS)
        w.writeheader()
        for l in lines:
            w.writerow({k: l[k] for k in FIELDS})


def money(x):
    return f"{x:,.2f}"


def summarize(lines):
    base = OrderedDict()
    cat = OrderedDict()
    opt = 0.0
    for l in lines:
        if l["required"] != "yes":
            opt += l["line_gbp_ex"]
            continue
        base[l["basket"]] = base.get(l["basket"], 0) + l["line_gbp_ex"]
        cat[l["category"]] = cat.get(l["category"], 0) + l["line_gbp_ex"]
    return base, cat, opt


CUT_WHY = {  # mpn -> why the owner may drop it
    "nRF5340-DK": "One DK runs most bring-up; the second is the peer for the radio link and end-to-end latency tests (#38), which the packs and rack could stand in for later.",
    "nRF-PPK2": "Only measures pack and FEM current; the battery-life check can use a bench meter instead.",
    "LS003": "The venue's existing lighting stands or booms may serve as the 4 m antenna mounts (the HGX-PMT07 mounts stay).",
    "-": "Delivery for the two stands; goes with them.",
}


def cuts(lines):
    """Optional cuts: lines (or part of a line) in the required total that the owner may choose to drop."""
    return [l for l in lines if l["required"] == "yes" and l["cut_qty"]]


def render(lines):
    base, cat, opt = summarize(lines)
    tot = sum(base.values())
    est_lines = [l for l in lines if l["price_status"] == E and l["required"] == "yes" and l["category"] != CAT_SHIP]
    est_total = sum(l["line_gbp_ex"] for l in est_lines)
    q_total = sum(l["line_gbp_ex"] for l in lines if l["price_status"] == Q and l["required"] == "yes")
    o = []
    o.append("# OpenPack shopping list (issue #36, ADR-0019)\n")
    o.append("One purchase, bought once, after all design is done (ADR-0019). **Packs, receivers, bench kit and the rack** "
             "(main board PR #126, filled in here). Generated from `hw/bom/shopping.csv` "
             "by `python3 hw/bom/shopping.py`; do not edit this file by hand. A test (`tests/test_shopping.py`) checks that the totals add up.\n")
    o.append("## Totals\n")
    o.append("| Basket | Ex VAT (GBP) | VAT 20 % | Inc VAT |\n|---|---:|---:|---:|")
    for b, v in base.items():
        o.append(f"| {b} | {money(v)} | {money(v*VAT)} | {money(v*(1+VAT))} |")
    o.append(f"| **Grand total (required)** | **{money(tot)}** | **{money(tot*VAT)}** | **{money(tot*(1+VAT))}** |")
    o.append(f"| Optional items (not in total) | {money(opt)} | {money(opt*VAT)} | {money(opt*(1+VAT))} |")
    o.append("")
    o.append(f"Of the required total, GBP {money(q_total)} ex VAT is **quoted** and the rest, GBP {money(tot-q_total)}, is **estimated** "
             f"(including shipping). Estimated prices are marked `estimated` in every table; none can be called a quote.\n")
    cl = cuts(lines)
    cut_tot = sum(l["cut_qty"] * l["unit_gbp_ex"] for l in cl)
    o.append("## Optional cuts the owner may choose\n")
    o.append("The owner has not decided these. **They are still inside the required total above.** "
             "Taking all of them saves the amount in the last row.\n")
    o.append("| Basket | Item | Qty cut | Saving ex VAT | VAT 20 % | Saving inc VAT | Why it may go |\n|---|---|---:|---:|---:|---:|---|")
    for l in cl:
        sv = l["cut_qty"] * l["unit_gbp_ex"]
        name = l["item"] if l["mpn"] != "-" else l["item"]
        o.append(f"| {l['basket']} | {name} ({l['mpn']}) | {l['cut_qty']} | {money(sv)} | {money(sv*VAT)} | {money(sv*(1+VAT))} | {CUT_WHY[l['mpn']]} |")
    o.append(f"| **All cuts** | | | **{money(cut_tot)}** | **{money(cut_tot*VAT)}** | **{money(cut_tot*(1+VAT))}** | Total after all cuts: GBP {money(tot-cut_tot)} ex VAT, {money((tot-cut_tot)*(1+VAT))} inc VAT |\n")
    o.append("Lines already marked OPTIONAL in the baskets (PCM1840EVM, NanoVNA-H4, DS1054Z) are excluded from the total and are not in this table.\n")
    o.append("## How prices were read\n")
    o.append("- All prices GBP **ex VAT**; VAT 20 % shown separately and added in the inc-VAT column. Digi-Key UK, Mouser UK, Farnell UK, RS UK show ex- and inc-VAT side by side; ITM Components and the owner-given Simply Sound prices are ex VAT.\n"
             "- **quoted** = a price read from a source page, with its URL and read date. For pack lines these are the readings in `hw/bom/pack_uk.csv` (2026-10-31 for Digi-Key UK, 2026-11-01 for LCSC) and `hw/rx/out/bom.csv`; for the antennas, coax, mounts and stands they are the figures given by the owner or ADR-0016 on 2026-11-01. Prices are at the quantity of 4 packs (or the 100-tier when the order quantity reaches 100), not re-read today.\n"
             "- **estimated** = no page read (or the repo marks it ESTIMATE). Bench kit lines were re-read on 2026-11-01 from Digi-Key UK, The Debug Store, Lab401, Knives and Tools UK and 123-3D UK (some from search snippets, marked in the notes). Farnell, Mouser and RS pages timed out or were refused. Still estimated: JLCPCB fab, stencil and shipping (quote page is dynamic), protected cells, fasteners, wire, most delivery lines. Re-check each basket before paying.\n"
             "- **LCSC and JLCPCB** orders to the UK: 20 % import VAT is collected at checkout, no duty under GBP 135 per consignment, courier shipping is a separate line. Split orders so each stays under GBP 135 ex VAT (the PCB order and parts order already do).\n"
             "- Quantities: pack lines are 4 packs; receiver lines are **4 receivers** (one per pack; the rack has 8 slots, 4 stay empty, but all 8 get their main-board parts and u.FL jumpers). An MPN is bought **once**: parts shared by packs, receivers and the rack are summed into one line (shared passives sit in LCSC). Rack-only lines come from `hw/bom/rack_uk.csv` (the #126 backplane BOM summed per MPN); the rack host, case, cables and PCB order are in `hw/bom/shopping.py`. Spares: passives max(10, 25 %), ICs under GBP 1 get 1 spare, dearer parts none. Lines used by both pack and receiver are merged into one line.\n"
             "- Parts the repo consigns elsewhere: BT40NE (pack) at Digi-Key UK GBP 16.34 at qty 4, BT40E (receiver) at Digi-Key UK GBP 9.78 (10 week lead on both; order first). F1 fuse SF-1206F300-2 at Digi-Key UK. No FEM is bought (U8 is not fitted).\n")
    o.append("## Gaps and decisions\n")
    o.append("- **Not UK-sourceable / unconfirmed:** the tinySA Ultra+ comes from Lab401 (France), no UK stockist was found; protected 18650 cells (no UK seller page could be read), the NanoVNA (optional). Everything else is on a UK distributor's list but unverified in stock.\n"
             "- **Missing from the BOMs, added here:** Tag-Connect TC2030-IDC-NL (programming), protected 18650 cells, an external 18650 charger, solder paste, the u.FL pigtails and attenuators for conducted-power measurement.\n"
             "- **Decided with the rack (#126):** near wing CA3N030 (9.14 m), far wing CA3N075 (22.86 m); an N-socket to BNC-plug adapter at the rack replaces the LCCA30301-FT1.5 jumper. A reflow hot plate/oven and a multimeter are assumed owned.\n"
             "- **Biggest estimate:** the rack main-board PCB order, GBP 300 (reviewer's range 250-350, the JLC page needs a browser). Quote it before ordering.\n"
             "- **Not listed (assumed owned):** Bambu A1 mini (ADR-0008 says the owner has it), PC, soldering iron.\n")
    cur = None
    for b in BASKETS:
        bl = [l for l in lines if l["basket"] == b]
        if not bl:
            continue
        bt = base.get(b, 0)
        o.append(f"## Basket: {b}\n")
        o.append(f"**Basket total: GBP {money(bt)} ex VAT, VAT {money(bt*VAT)}, GBP {money(bt*(1+VAT))} inc VAT.**\n")
        o.append("| Item | Part number | Qty | Unit (GBP ex VAT) | Line total | Price | Link | Reason / what it unblocks |\n|---|---|---:|---:|---:|---|---|---|")
        for l in bl:
            tag = l["price_status"] + (f" {l['date_read']}" if l["date_read"] and l["price_status"] == Q else "")
            if l["required"] != "yes":
                tag += ", OPTIONAL"
            elif l["cut_qty"]:
                tag += f", OPTIONAL CUT x{l['cut_qty']}"
            link = f"[link]({l['source_url']})" if l["source_url"] else "-"
            item = l["item"] if l["category"] in (CAT_BENCH, CAT_ANT, CAT_FAB, CAT_MECH, CAT_SHIP, CAT_RACK) else f"{l['category']} part"
            reason = l["reason"] + ((" " + l["notes"]) if l["notes"] else "")
            reason = reason.replace("|", "/")
            o.append(f"| {item} | {l['mpn']} | {l['qty']} | {l['unit_gbp_ex']:.4f} | {money(l['line_gbp_ex'])} | {tag} | {link} | {reason} |")
        o.append("")
    o.append("## Summary by category\n")
    o.append("| Category | Ex VAT | VAT 20 % | Inc VAT |\n|---|---:|---:|---:|")
    for c, v in cat.items():
        o.append(f"| {c} | {money(v)} | {money(v*VAT)} | {money(v*(1+VAT))} |")
    o.append(f"| **Total** | **{money(tot)}** | **{money(tot*VAT)}** | **{money(tot*(1+VAT))}** |\n")
    o.append("Shipping is its own category. Lines marked OPTIONAL are excluded; the optional cuts above are included.\n")
    return "\n".join(o)


def main():
    lines = all_lines()
    csv_path, md_path = HERE / "shopping.csv", ROOT / "docs/shopping-list.md"
    if "--check" in sys.argv:
        import io
        buf = io.StringIO()
        w = csv.DictWriter(buf, fieldnames=FIELDS, lineterminator="\r\n")
        w.writeheader()
        for l in lines:
            w.writerow({k: l[k] for k in FIELDS})
        ok = csv_path.read_bytes().decode() == buf.getvalue() and md_path.read_text() == render(lines)
        sys.exit(0 if ok else 1)
    write_csv(lines, csv_path)
    md_path.write_text(render(lines))
    base, cat, opt = summarize(lines)
    for b, v in base.items():
        print(f"{b:28s} {v:9.2f}")
    t = sum(base.values())
    print(f"TOTAL ex {t:.2f}  VAT {t*VAT:.2f}  inc {t*(1+VAT):.2f}; optional {opt:.2f}")


if __name__ == "__main__":
    main()
