saturncity/openpack/(commit log)

2026-10-31 sim/loss: loss traces, PLC, quality curve script (#51)
    * sim/loss: GE loss traces, PLC, tests (#14)
    * sim/loss: curve script, RESULTS (#14)
    * sim/loss: per-copy busy, gap-carrier table, derivation (#14)
    ---------
2026-10-31 host: FastAPI service + channel plan + module driver (#28) (#54)
    * host: FastAPI service, channel plan, serial module driver (#28)
    * tests: put repo root on sys.path for host import (#28)
    * host: spread in-band carriers 2/2/4 over Wi-Fi 11/1/6, loader cap (#28)
    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
2026-10-31 adr-0007: amend after module verification (+19.1 dBm, $13.47); AIR-6, PK-7, BOM (#58)
2026-10-31 host: WebSocket /telemetry (10 Hz) + cached RF scan (#29) (#59)
2026-10-31 mech: CadQuery pack enclosure + 1U panel + tests (#35) (#60)
    * mech: CadQuery pack enclosure + 1U panel + tests (#35)
    * mech: printed clip, 3-segment printed 1U panel, snap-arm door, 180 mm bed checks, ADR-0008 (#35)
    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
2026-10-31 bsim: AIR-1 confirmed, WLAN_actmod calibrated, ADR-0009 (#18) (#66)
    * fw workflow: shellcheck fixes (#18)
    * fw workflow: find Zephyr SDK (#18)
    * fw workflow: find Zephyr SDK (#18)
    * probe: include nrfx.h (#18)
    * probe: debug prints (#18)
    * probe: TIMER0 us clock, busy-wait polling (#18)
    * probe: event-driven radio (TIMER/DPPI/IRQ), step t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
2026-10-31 fw: pack net-core frame scheduler, TIMER+DPPI, IPC frames, bsim schedule check (#22) (#74)
    * fw: app skeleton, roles, bsim + DK targets, MCUboot, Twister (#19) (#67)
    * fw: app skeleton with roles, sysbuild net core image, Twister (#19)
    * fw: guard net image add, drop integration platforms (#19)
    * west: add tf-psa-crypto for mbedtls/MCUboot (#19)
    * fw: detect app/net core via SOC_COMPATIBLE (bsim + DK) (#19)
    ---------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
2026-10-31 fw/rx: receiver acquisition, tracking, merge, antenna choice (#23) (#73)
    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
2026-10-31 hw/pack: SKiDL pack schematic, ERC, BOM ≤ $35, filtered mic bias, ADR-0012 (#31) (#75)
    * hw/pack: SKiDL pack schematic, ERC, sourced BOM (PK-12 in audit.py), RC-filtered mic bias in preamp.cir (#31)
    * hw/pack: schematic sheets + SVG previews, pack ERC/BOM test, ADR-0012 pinouts (#31)
    * hw/pack: README for the SKiDL flow (#31)
    * hw/pack: review fixes for #75 (op-amp CM, hot-plug protection, CI, cutoff, LEDs) (#31)
    - VCM 180k/100k (1.77 V) keeps OPA1656 +IN inside V+ - 2.25 V; SPICE clamp 0.25/4.70 V,
    test asserts inp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
2026-10-31 fw: UART/CDC text protocol, telemetry packer (#25) (#72)
    * fw: pack net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
2026-10-31 bom: UK sourcing for pack BOM (#78) (#79)
    test asserts input CM, ADC pin (1.375 V) and prints numbers in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
2026-10-31 pack: restore battery-sense divider (R13/C30) (#84)
    * hw/pack: restore battery-sense divider R13/C30 hidden in a comment
    * tests: cite nRF5340 SAADC pin limit (VDD) from the product spec
    * hw/pack: price 0402 resistors and 100n caps from LCSC qty-100 pages; UK BOM refs; merge main
    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
2026-10-31 fw/rx: jitter slot, PLC, PI clock recovery, bsim (d) (#24) (#77)
    * fw: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
2026-10-31 hw/rx: SKiDL receiver sub-board, balanced driver in ngspice, ADR-0014 backplane pinout (#32) (#81)
    test a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
2026-11-01 ADR-0016/0017: UK R1 via rack antennas + 2482 carrier, TD off by default (#26, #89) (#93)
    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
2026-11-01 STATUS: clock sync, G2 passing on UK plan, latency fixed, schematics, UK parts (#94)
2026-11-01 host: resilient receiver framing, Schemathesis + resilience + bsim tests (#30) (#96)
    modules.request skips log lines, needs newline-terminated ok/err, bounds the whole call,
    write timeout, port-busy timeout; app: 502/504 mapping, parallel probes, declared degraded
    statuses and firmware body in OpenAPI, trim sent as plain decimal, dfu payload withheld on refusal.
2026-11-01 fw: pace pack frames from the audio frame clock, phased to the net latch (#87) (#100)
    * fw: pace pack frames from the audio frame clock, phased to the net latch (#87)
    Root cause: the placeholder k_timer source ran on 30.5 us RTC ticks (1 ms =
    1007 us, phase sweeping past the net core's latch every 142 frames) and any
    other timeout due within 3 ticks of a frame pushed its callback 61 us late
    (nrf_rtc_timer MIN_CYCLES_FROM_NOW). Near the latch that frame missed its slot
    and was overwritten by the next: repeat, then seq skip.
    Fix: src/app/pack.c runs the real pipeline (op_audio_read_frame -> ADPCM-6 ->
    op_ipc_send) from a frame-clock interrupt (TIMER1 until I2S lands, same crystal
    as TIMER0)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
2026-11-01 docs/analysis: BT40NE drives its u.FL through the nRF21540 (#105) (#106)
    Primary sources (Fanstel spec v1.09 and 2020 draft, FCC ID X8WBT40N
    exhibits) show the "BT40X hard-wired to PCB antenna" line is about the
    PCB-only part (now BT40N). The BT40NE is certified with a 6 dBi dipole
    on its u.FL at full PA power; ANT_SEL (P1.05) picks the port. No module
    change on pack or receiver; ANT_SEL polarity and US re-filing remain.
2026-11-01 Time diversity as a per-pack setting: td_audio, RX-4 recovery, td command (#91) (#102)
    * fw/td: td_audio pack/unpack and RX-4 recovery, pure C + ztest (#91)
    * fw/host/bsim: per-pack time diversity, td command, RX-4 recovery, real TD in G2 (#91)
    Pack: Kconfig OP_TIME_DIVERSITY (default n, SB_CONFIG_ too) is the boot value of
    the td setting; the frame source sends 42 or 81 B (frame n-2 td_audio), the net
    core times copy B per length; OP_RX_WINDOW_US defaults to 0 with TD.
    Receiver: timeline from the payload length at lock (+-10 us window for 81 B),
    op_td_rx delay line plays frame n at packet n+2's deadline, recovering from
    td_audio; re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
2026-11-01 host+test: fix telemetry poller dying on termios.error; deterministic test_receiver_reboot (#108) (#109)
    Root cause: pyserial does not wrap termios.error (tcflush on a pty whose peer was just killed).
    It escaped modules.request, killed the slot's poller task silently, and the slot never came back.
    Test now waits on telemetry state (frame-count bounded) instead of 3 s / 5 s wall-clock windows.
2026-11-01 fw/pack: latch the payload from TIMER0 COMPARE3 20 us before TXEN (#98) (#111)
    The net core copied the newest frame into the radio buffer in the DISABLED
    interrupt after copy B (t0 + 565 us, t0 + 877 at 81 B), 435 us before it went
    on air. It now latches from TIMER0 COMPARE3 at t0 - OP_PACK_LATCH_LEAD_US
    (20 us, new Kconfig), for both payload lengths; the sync and the app core's
    frame clock follow. Audio frame done -> TXEN = 100 + 20 = 120 us.
    run.py (a) now measures from the app core's audio frame clock: test-only
    PACK_FCLK (app) and PACK_IPC t0_hw_mod_us (net) lines carry the bsim device
    time mod 1 ms. Measured: 884 us TD off, 1196 us TD on. SYS-2: 2.67 ms TD off
    (2.28 with FLT=1), 4.60 m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
2026-11-01 hw/pack: 4-layer pack PCB layout, review fixes, fab outputs, cost-down (#104)
    * hw/pack: scripted 4-layer layout from the netlist, DRC clean (#34)
    layout.py builds pack.kicad_pcb from out/pack.net with pcbnew: outline from
    mech/pack.py, BT40NE antenna past the board edge, TI-pattern boost cell,
    grid maze router (router.py), GND fan-out vias, RF via fence, JLC rules in
    pack.kicad_dru. outputs.py writes gerbers/drill/BOM/CPL/STEP and renders.
    * hw/pack: enclosure fit (fit.py + CadQuery test), mech outline from the layout, layout tests (#34)
    mech/pack.py takes the real outline (73.4 x 35 mm, post notch), z0 +1.4 mm so
    the module antenn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
2026-11-01 fw/pack: hold the frame lead with a PI loop on HFCLKAUDIO; I2S frame clock (#97) (#114)
    - Pace the pack from I2S RXPTRUPD (48-sample buffers, op_audio_i2s.c, HFCLKAUDIO
    ACLK); a TIMER1 one-shot starts I2S at the synced phase. Without I2S (bsim)
    TIMER1 at 16 MHz stands in, free-running with absolute compares (bsim's TIMER
    rounds CLEAR-relative periods up to whole us).
    - Net core reports the latch margins every OP_PACK_LEAD_REPORT_FRAMES (100)
    frames over the same endpoint (OP_LEAD_LEN; first window 10 frames).
    - op_lead (fw/src/clk): earliest-frame margin vs the first report, op_clk PI
    (kp 2000 ppb/us, ki 100), sigma-delta dither between whole FREQ steps
    (op_aclk_dither) once per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
2026-11-01 R1 with antennas only in the wings: ADR-0021 (4 m wing rule, BT40E receivers, RX-5 miss switch) (#101) (#103)
    * sim: wing-antenna geometry model, run.py --geometry with RX-5 replay, Audit 7 (#101)
    Owner constraint: rack antennas only in the wings. sim/loss/wing_geometry.py models
    UK studio / proscenium houses with one HG2409P-NF per wing, audience and crew Wi-Fi,
    actors walking past an antenna, and the PR #95 rack chain. run.py --geometry gives
    every pack two receivers (antenna L/R) and replays RX-5 per carrier on the dumps.
    * ADR-0021: wing-antenna install rule, RX-5 probe 1000, bsim results (#101)
    Owner constraint: rack antennas o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
2026-11-01 hw/rx: receiver module BT40NE -> BT40E, FEM node pack-only (ADR-0021, #112) (#113)
    - hw/rx: BT40E symbol (Fanstel v1.09 p.14 pad map = BT40F/NE names), footprint
    openpack:Fanstel_BT40E (14x16 mm), no FEM nets, P1.05 open; GPIO map unchanged.
    ERC 0/0. BOM: Digi-Key UK GBP 9.7765 q100 -> $30.68 / GBP 23.38 per sub-board.
    - fw: receiver builds add boards/role_rx_cpunet.overlay (FEM node disabled, no
    &radio fem); rx.c refuses to build with the FEM enabled.
    - ADR-0014 amended (datasheet checks, FCC X8WBT40F, no UKCA DoC, BOM).
2026-11-01 hw/rack: backplane SKiDL, 2x LNA + 1:8 Wilkinson, rear panel, CM4IO carrier, ADR-0018 (#33) (#95)
    * hw/rack: SKiDL main board, 1:8 Wilkinson model, Audit 6 RF cascade + BOM, ADR-0018 (#33)
    Per antenna: BNC, ESD103, switchable bias-T eFuse, DC block, ESD101, QPL9057
    LNA, QPQ1907 BAW, 3-stage microstrip Wilkinson to 8 u.FL. Per-slot eFuses,
    ADR-0014 sockets (key 14), XLR with SMAJ58CA. CM4IO host carrier, CM4 UARTs +
    2x SC16IS752. ERC 0/0.
    * hw/rack: KiCad schematic sheets and SVGs; ADR-0018 load budget, host cmdline, ESD103 source (#33)
    * audit: Audit 6 gain plan for wing anten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
2026-11-01 STATUS: wing antennas, BT40E receiver, rack board, pack layout (#117)
2026-11-01 hw/rx: receiver sub-board layout, 50 ohm GCPW, keyed J1, JLC rules that load, fab outputs (#34) (#116)
    Part of #34. Receiver layout (48x90 mm, DRC 0/0), #116 independent-review fixes (netclass pour clearances in rx + pack, no hole at J1 pin 14, solid RF grounds, K1 pin-1/CPL), every placed part with a checked LCSC code.
2026-11-01 fw: openpack_pack / openpack_rx board targets from the netlists (#118) (#119)
    * wip: board targets (paused, owner usage request)
    * fw: openpack_pack / openpack_rx board targets, pins generated from the netlists (#118)
    Out-of-tree boards (nRF5340 cpuapp + cpunet, MCUboot) whose pin devicetree is generated by
    fw/boards/openpack/gen_pins.py from hw/pack/out/pack.net and hw/rx/out/rx.net. The generator refuses
    unmapped nets, double-used pins, battery sense off AIN, LFXO/NFC pads and FEM pads wired on the board.
    --check-dts parses each merged zephyr.dts and compares every pin to the netlist (tests/test_fw_board_pins.py,
    fw.yml twister ste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
2026-11-01 fw: MCUboot ECDSA-P256 on openpack boards, drop TEST_RANDOM_GENERATOR (#120) (#121)
    The nRF5340 app core has no RNG peripheral; its entropy is the net core's
    over HCI, which MCUboot does not have. MCUboot's RSA/PSA path then selects
    the insecure TEST_RANDOM_GENERATOR. ECDSA-P256 only verifies, needs no RNG.
2026-11-01 hw/rack: rack main board layout + 1U chassis fit (#34) (#126)
    * hw/rack: carry the rack layout WIP (130940f) onto main without the pre-squash rx history (#34)
    * hw/rack: decided parts: CS0603-39NJ-S choke (C142171), AKER crystal (C6523919), BOOMELE 2x20 (C9138), SRP5030T-6R8M from UK, Sunlord 18 nH; BOM regenerated (#34)
    * hw/rack: layout fixes: ILM resistors beside pin 7, LNA bias stubs, buck SW pour + TI-style cluster, 50 ohm into the LNA/BAW pins, router budget for long hops; USB-C cut-out from the Adafruit drawing; audit: crystal margin, PIMD distance (#34)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
2026-11-01 Shopping list: everything except the rack (Part of #36) (#125)
    * docs: consolidated UK shopping list, per-distributor baskets (Part of #36)
    * docs: firm up shopping list with UK quotes read 2026-11-01 (Part of #36)
    Bench kit, charger, PETG and solder paste now quoted; tinySA from Lab401 (no UK stockist).
    Quoted GBP 795 -> 1,440 of 1,815 ex VAT.
    * docs: PCM1840EVM to optional (Part of #36)
    * docs: fill the shopping list RACK section from the rack board PR #126 (Part of #36)
    One line per MPN, antennas match #126 (C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
